CCR-SOP/OpenSourcePerfusionSystem/Documentation/README.txt

Files with extension .drawio can be read online directly through https://app.diagrams.net/?src=about
A free desktop app is available at https://github.com/jgraph/drawio-desktop/releases/
The "Windows No Installer" release can be run directly with no admin privileges needed.
