CCR-SOP/OpenSourcePerfusionSystem/Models/mcc_dac_amp-EDM/mcc_dac_amp_BottomDecalImage_5.png

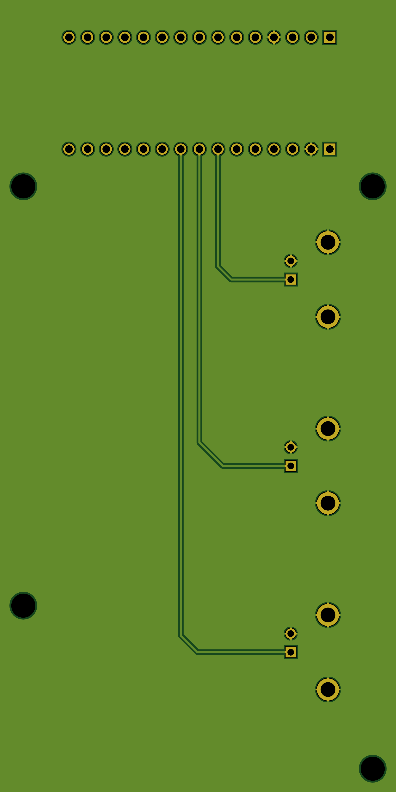
Models/mcc_dac_amp-EDM/mcc_dac_amp_BottomDecalImage_5.png
