CCR-SOP/OpenSourcePerfusionSystem/Models/mcc_dac_amp-EDM/mcc_dac_amp_TopDecalImage_5.png

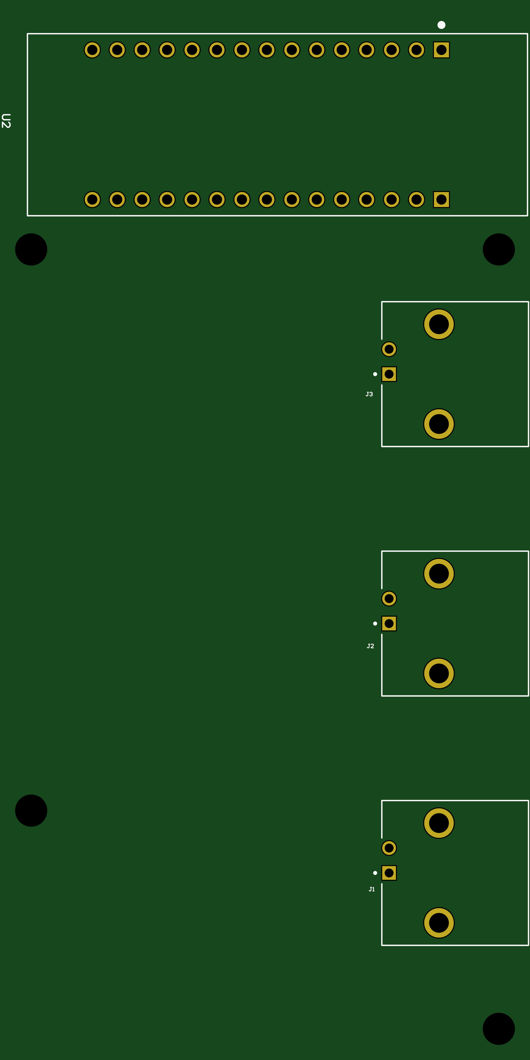
Models/mcc_dac_amp-EDM/mcc_dac_amp_TopDecalImage_5.png
