CCR-SOP/OpenSourcePerfusionSystem/Models/DialysisDACEnclosure.SLDASM

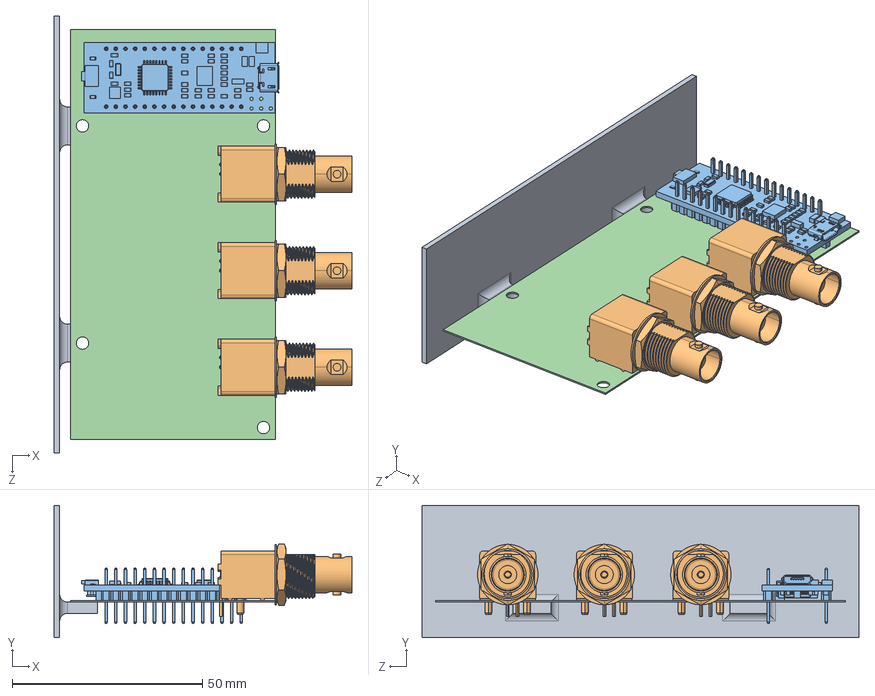
[picture p3: CAD file, 2024-11-08]
Models/DialysisDACEnclosure.SLDASM
78.4 x 34.8 x 115.0 mm
mcc_dac_amp_BOARD
MODULE_NUCLEO-F303K8_NUCLEO-F303K8-4
LINX_CONBNC002_CONBNC002-1 x 3
DialysisDACEnclosure_RearPanel
