CCR-SOP/OpenSourcePerfusionSystem/Models/PerfusionChamber/Liver_Perfusion_Chamber_Assembly.SLDASM

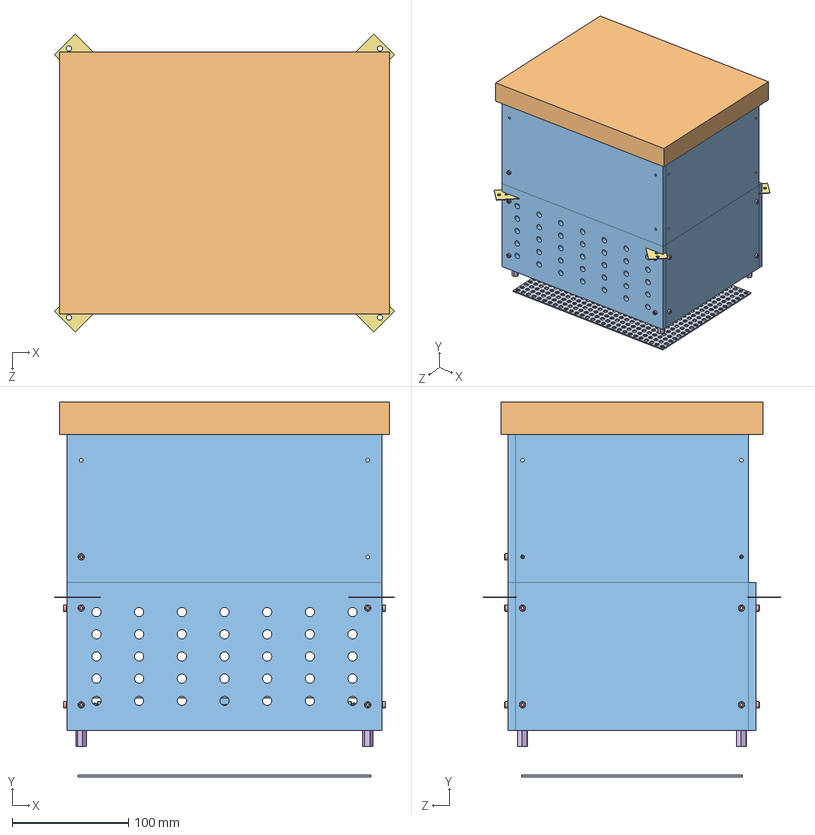
[picture p4: CAD file, 2022-06-02]
Models/PerfusionChamber/Liver_Perfusion_Chamber_Assembly.SLDASM
292.1 x 322.0 x 256.1 mm
Metal_Plate
CustomSpacerWall x 4
FabricationCube x 8
91292A346_18-8 Stainless Steel Socket Head Screw x 16
SH1000-G_Standoff x 4
91292A114_TYPE 18-8 SS SOCKET HEAD CAP SCREW x 4
Hammock_drainage_frame x 2
2633T11_HIGH-TEMPERATURE SILICONE RUBBER SHEET
magnet_based_drain
