CCR-SOP/OpenSourcePerfusionSystem/Models/mcc_dac_amp.SLDASM

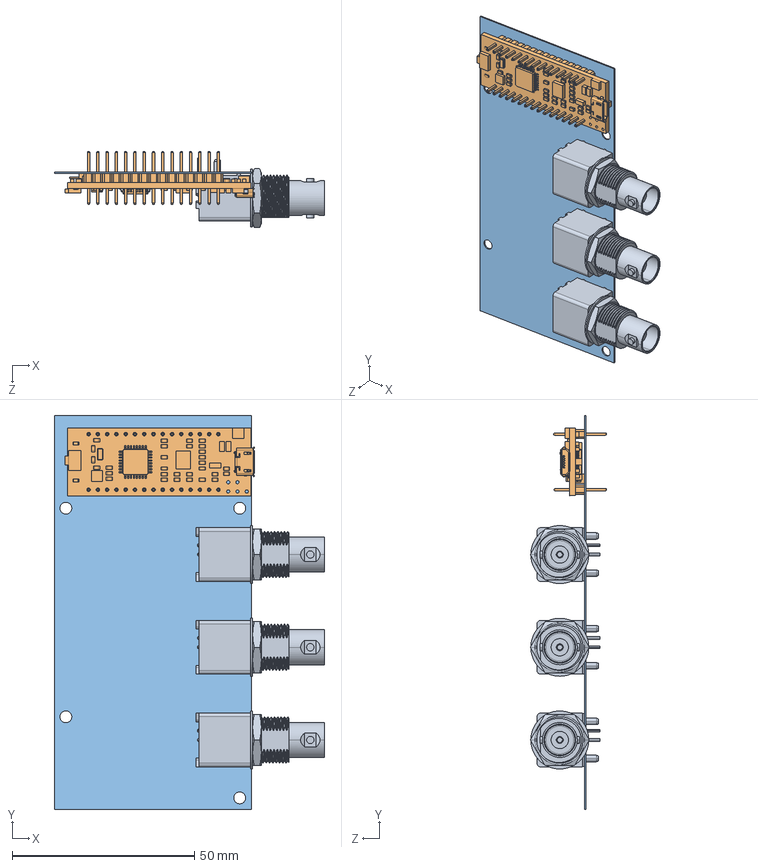
[picture p5: CAD file, 2024-07-02]
Models/mcc_dac_amp.SLDASM
74.1 x 108.0 x 20.9 mm
mcc_dac_amp_BOARD
MODULE_NUCLEO-F303K8_NUCLEO-F303K8-4
LINX_CONBNC002_CONBNC002-1 x 3
