CCR-SOP/OpenSourcePerfusionSystem/Models/SideComponents/Levitronics_pumpwithpumphead.SLDASM

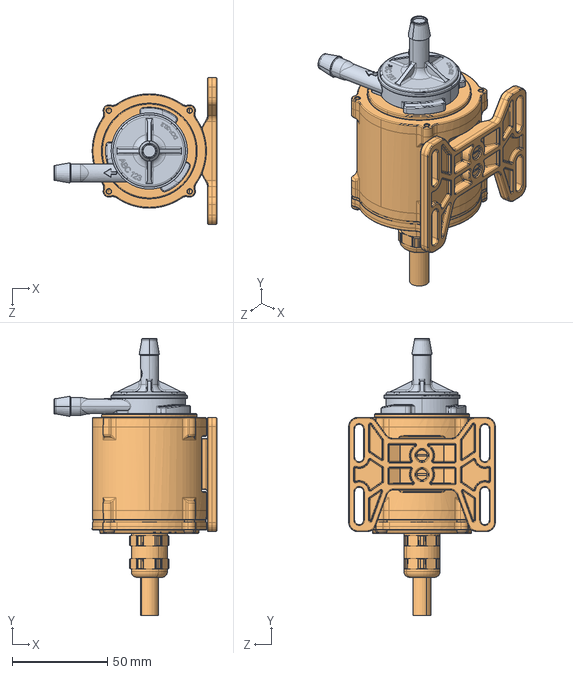
[picture p6: CAD file, 2024-11-08]
Models/SideComponents/Levitronics_pumpwithpumphead.SLDASM
85.5 x 145.4 x 77.0 mm
PS-4060-07 Rev01 Spec for Pump Driver IPD-30-8 Simplified Solid
PS-4078-00 Rev00 Pump Head DCP-30-2 Simplified Solid
