CCR-SOP/OpenSourcePerfusionSystem/Models/mcc_dac_amp-EDM/MODULE_NUCLEO-F303K8_NUCLEO-F303K8-3.SLDPRT

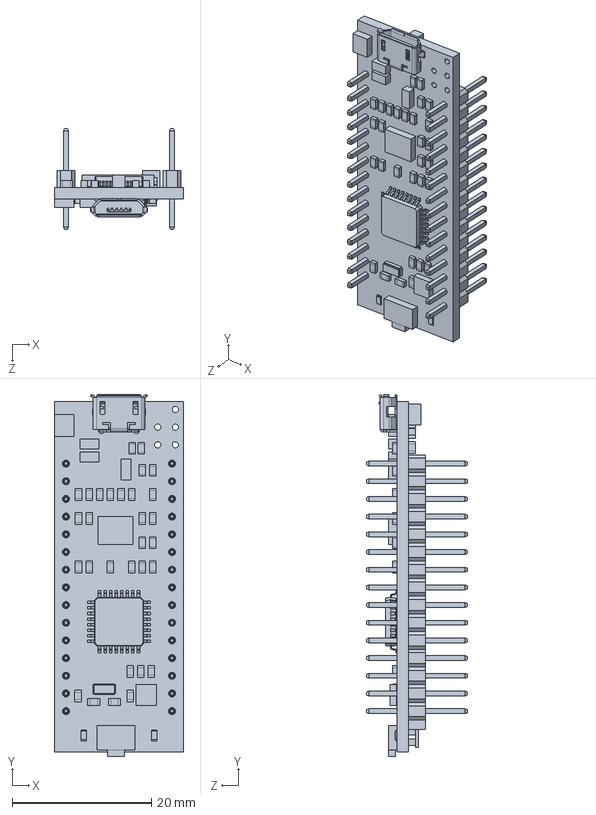
[picture p7: CAD file, 2024-07-02]
Models/mcc_dac_amp-EDM/MODULE_NUCLEO-F303K8_NUCLEO-F303K8-3.SLDPRT
18.5 x 52.0 x 14.5 mm
