CCR-SOP/OpenSourcePerfusionSystem/Models/SideComponents/pegboard_stand_top.SLDPRT

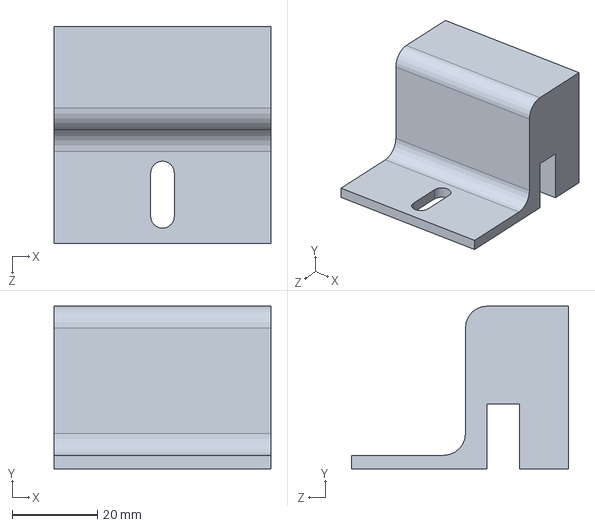
[picture p8: CAD file, 2024-11-08]
Models/SideComponents/pegboard_stand_top.SLDPRT
50.8 x 38.1 x 50.8 mm
