CCR-SOP/OpenSourcePerfusionSystem/Models/mcc_dac_amp-EDM/mcc_dac_amp_BOARD.SLDPRT

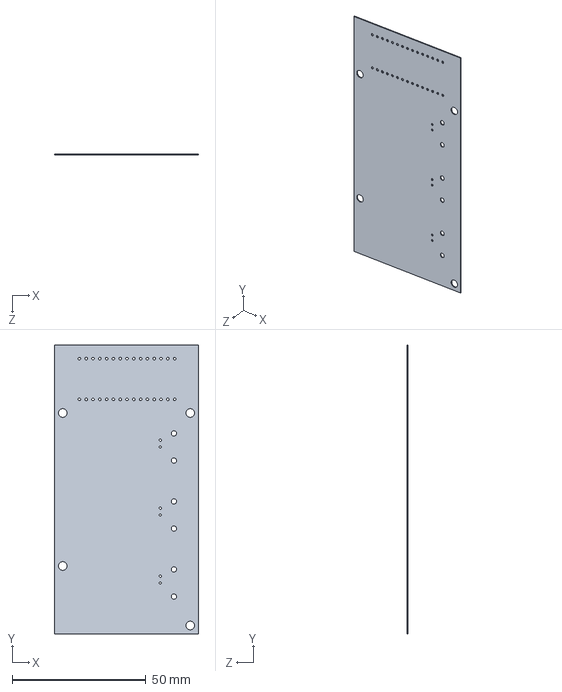
[picture p9: CAD file, 2024-07-02]
Models/mcc_dac_amp-EDM/mcc_dac_amp_BOARD.SLDPRT
54.0 x 108.0 x 0.411 mm
