CCR-SOP/OpenSourcePerfusionSystem/Models/SideComponents/HDfilter_holder.SLDPRT

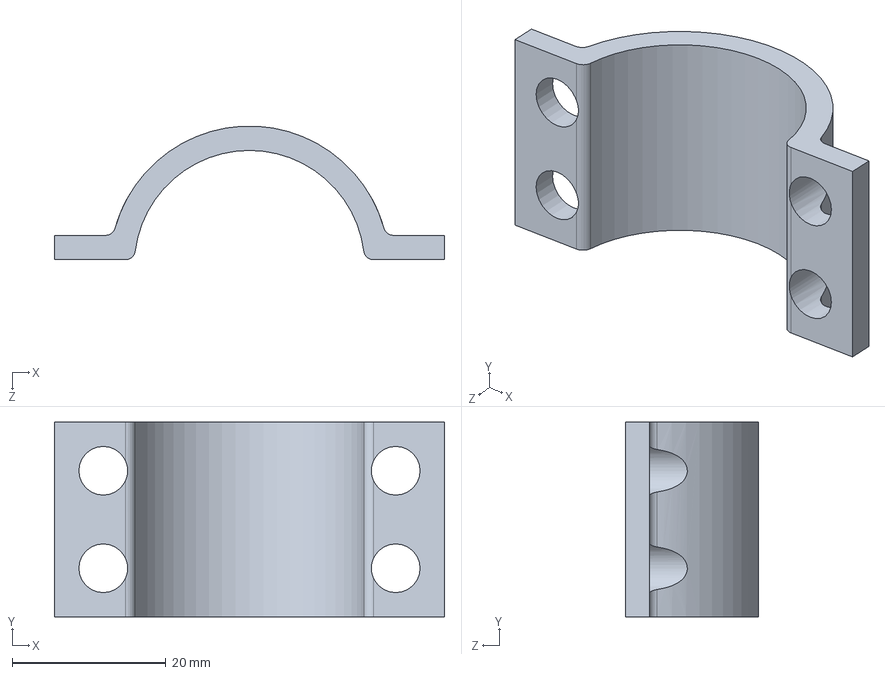
[picture p10: CAD file, 2024-11-08]
Models/SideComponents/HDfilter_holder.SLDPRT
50.8 x 25.4 x 17.4 mm
