CCR-SOP/OpenSourcePerfusionSystem/Models/DialysisDACEnclosure_RearPanel.SLDPRT

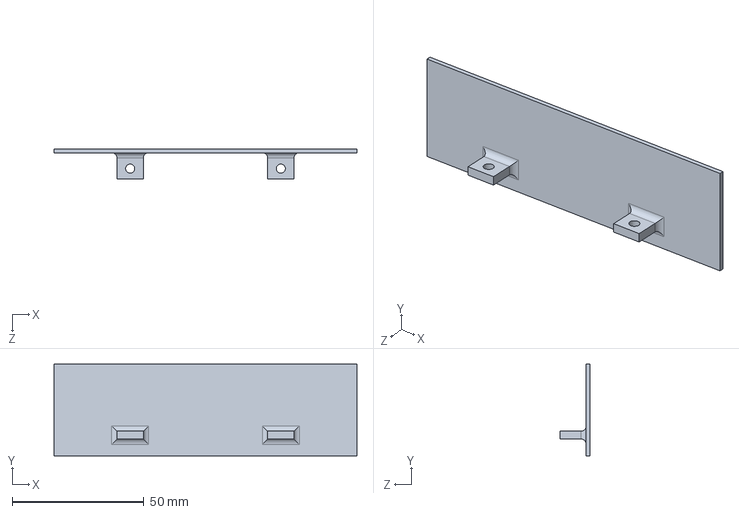
[picture p11: CAD file, 2024-07-02]
Models/DialysisDACEnclosure_RearPanel.SLDPRT
115.0 x 34.8 x 11.5 mm
