CCR-SOP/OpenSourcePerfusionSystem/Models/SideComponents/Clamponflow_holder.SLDPRT

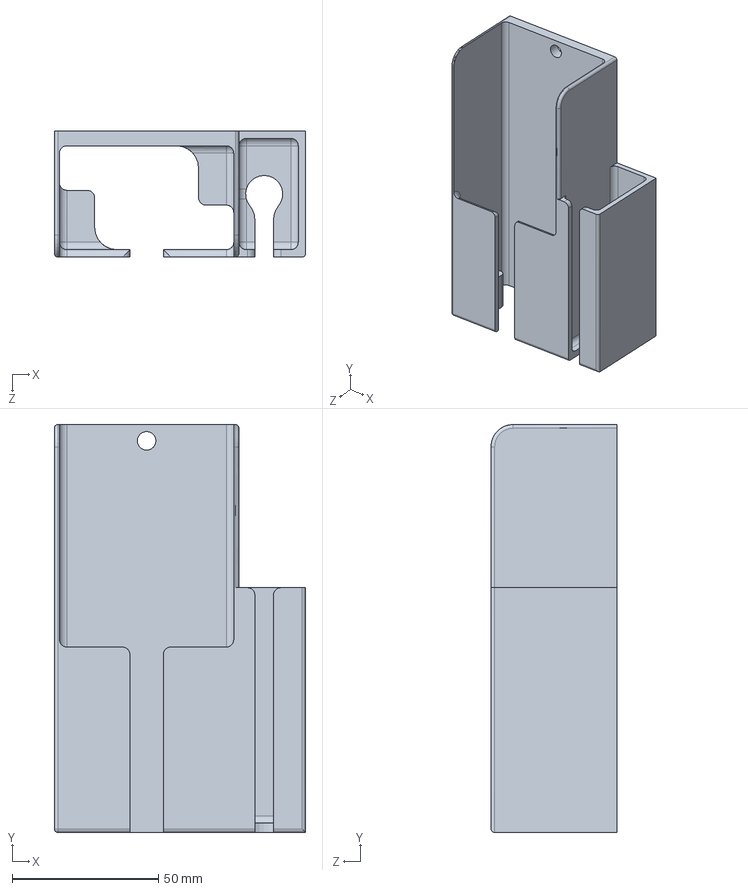
[picture p12: CAD file, 2024-11-08]
Models/SideComponents/Clamponflow_holder.SLDPRT
86.1 x 139.7 x 43.2 mm
