CCR-SOP/OpenSourcePerfusionSystem/Models/mcc_dac_amp-EDM/LINX_CONBNC002_CONBNC002-1.SLDPRT

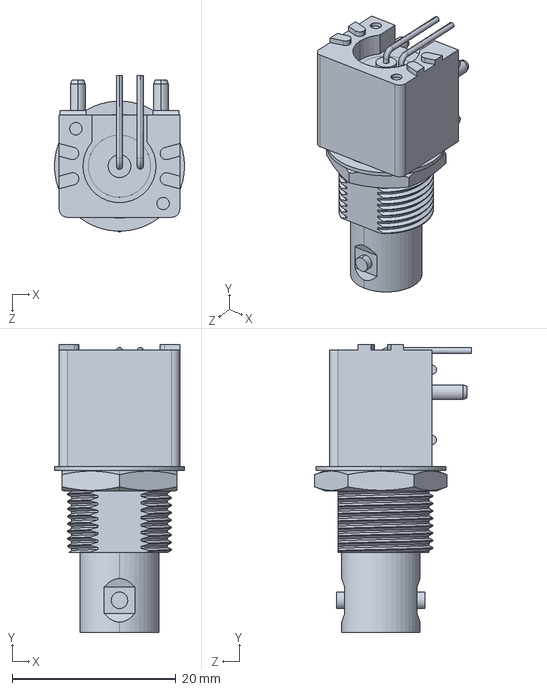
[picture p13: CAD file, 2024-07-02]
Models/mcc_dac_amp-EDM/LINX_CONBNC002_CONBNC002-1.SLDPRT
15.9 x 35.2 x 19.1 mm
