CCR-SOP/OpenSourcePerfusionSystem/Models/SideComponents/Clampon_frontbracket.SLDPRT

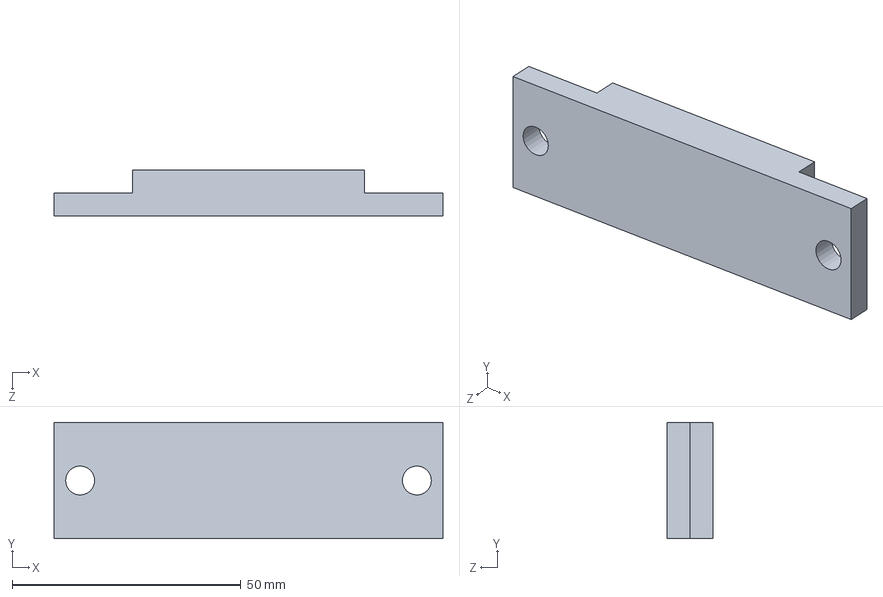
[picture p14: CAD file, 2024-11-08]
Models/SideComponents/Clampon_frontbracket.SLDPRT
85.1 x 25.4 x 10.2 mm
