CCR-SOP/OpenSourcePerfusionSystem/Models/SideComponents/PS-4060-07 Rev01 Spec for Pump Driver IPD-30-8 Simplified Solid.SLDPRT

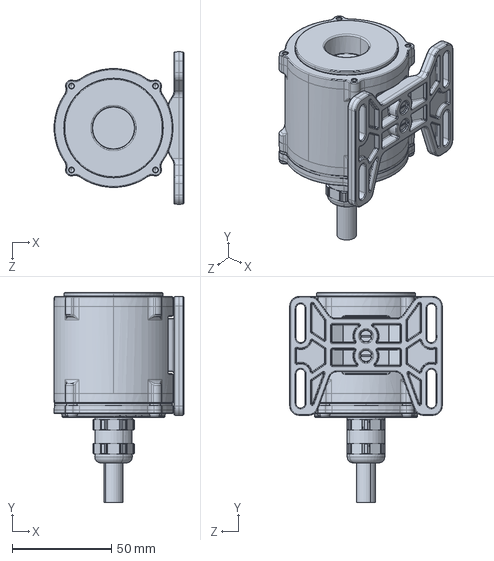
[picture p15: CAD file, 2024-11-08]
Models/SideComponents/PS-4060-07 Rev01 Spec for Pump Driver IPD-30-8 Simplified Solid.SLDPRT
65.5 x 106.0 x 77.0 mm
