CCR-SOP/OpenSourcePerfusionSystem/Models/SideComponents/HDfilter_holder_U.SLDPRT

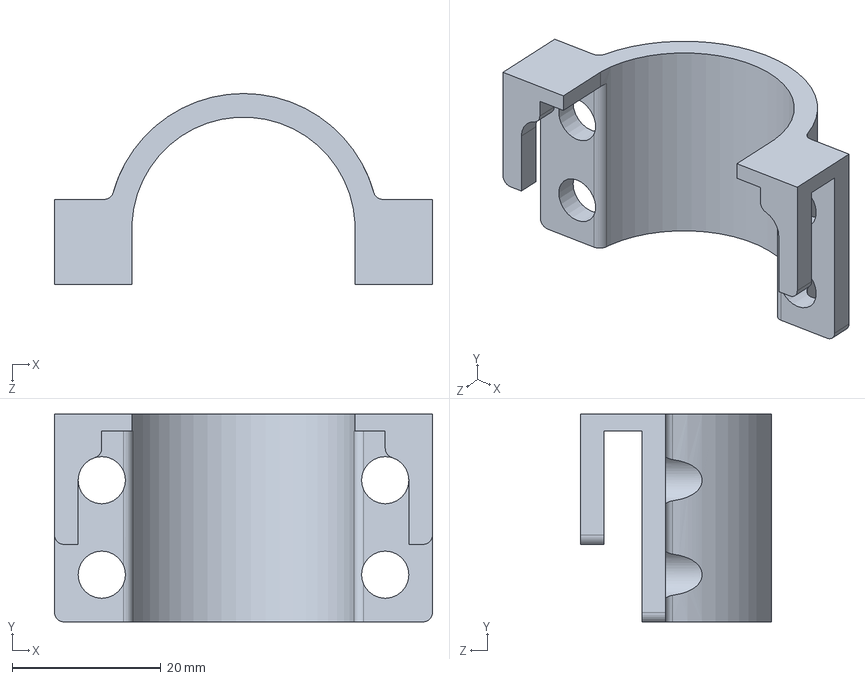
[picture p16: CAD file, 2024-11-08]
Models/SideComponents/HDfilter_holder_U.SLDPRT
50.8 x 27.9 x 25.7 mm
