CCR-SOP/OpenSourcePerfusionSystem/Models/SideComponents/Clampon_base.SLDPRT

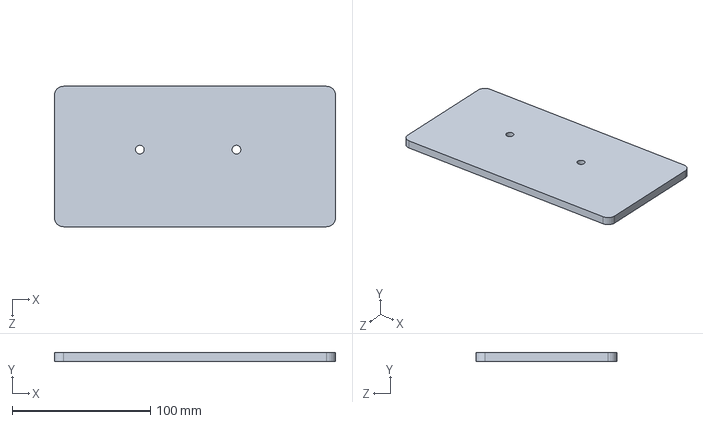
[picture p17: CAD file, 2024-11-08]
Models/SideComponents/Clampon_base.SLDPRT
203.2 x 6.35 x 101.6 mm
