CCR-SOP/OpenSourcePerfusionSystem/Models/SideComponents/Clampon_backbracket.SLDPRT

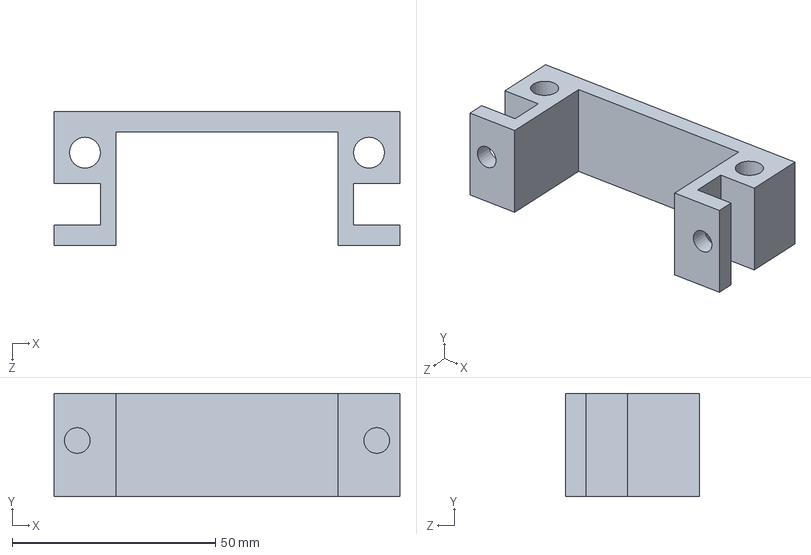
[picture p18: CAD file, 2024-11-08]
Models/SideComponents/Clampon_backbracket.SLDPRT
85.1 x 25.4 x 33.0 mm
