CCR-SOP/OpenSourcePerfusionSystem/Models/SideComponents/Pump_platform.SLDPRT

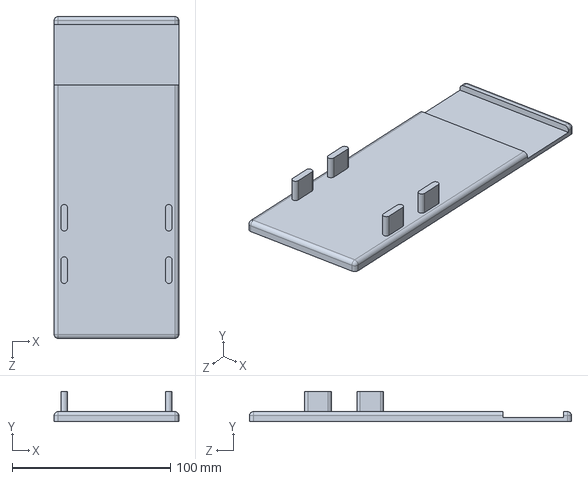
[picture p19: CAD file, 2024-11-08]
Models/SideComponents/Pump_platform.SLDPRT
78.7 x 19.1 x 203.2 mm
