CCR-SOP/OpenSourcePerfusionSystem/Models/SideComponents/Gasexchange_loop.SLDPRT

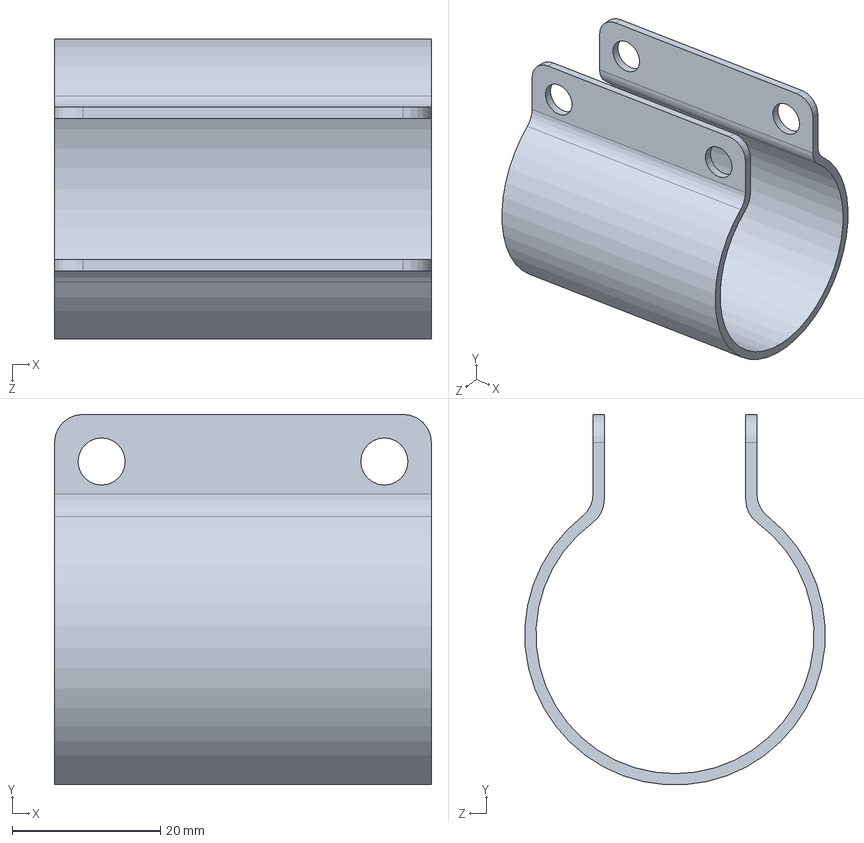
[picture p20: CAD file, 2024-11-08]
Models/SideComponents/Gasexchange_loop.SLDPRT
50.8 x 49.9 x 40.4 mm
