CCR-SOP/OpenSourcePerfusionSystem/Models/SideComponents/pegboard_stand.SLDPRT

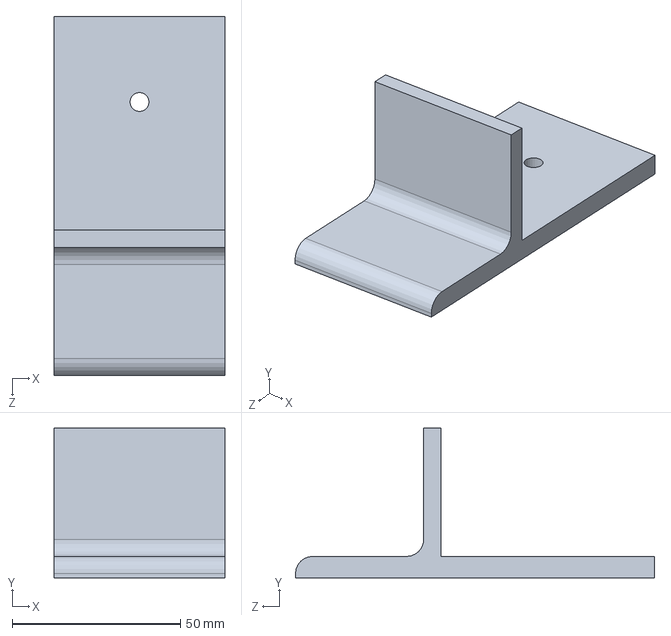
[picture p21: CAD file, 2024-11-08]
Models/SideComponents/pegboard_stand.SLDPRT
50.8 x 44.5 x 106.7 mm
