CCR-SOP/OpenSourcePerfusionSystem/Models/SideComponents/PS-4078-00 Rev00 Pump Head DCP-30-2 Simplified Solid.SLDPRT

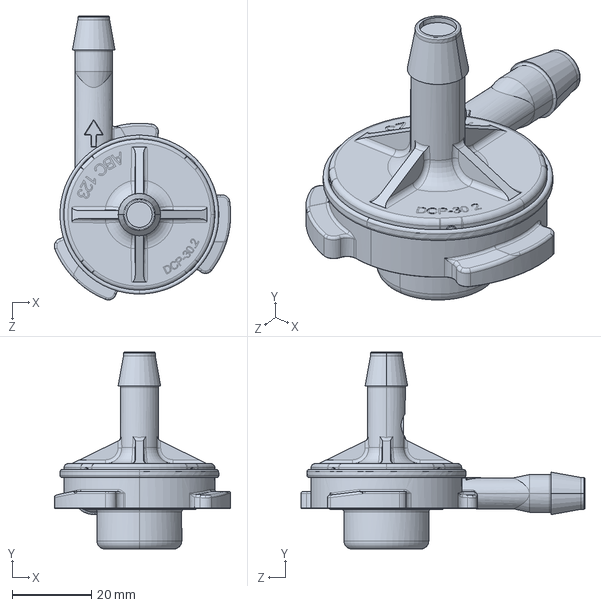
[picture p22: CAD file, 2024-11-08]
Models/SideComponents/PS-4078-00 Rev00 Pump Head DCP-30-2 Simplified Solid.SLDPRT
44.4 x 49.6 x 71.5 mm
