CCR-SOP/OpenSourcePerfusionSystem/Models/SideComponents/HDfilter_dialysis.SLDPRT

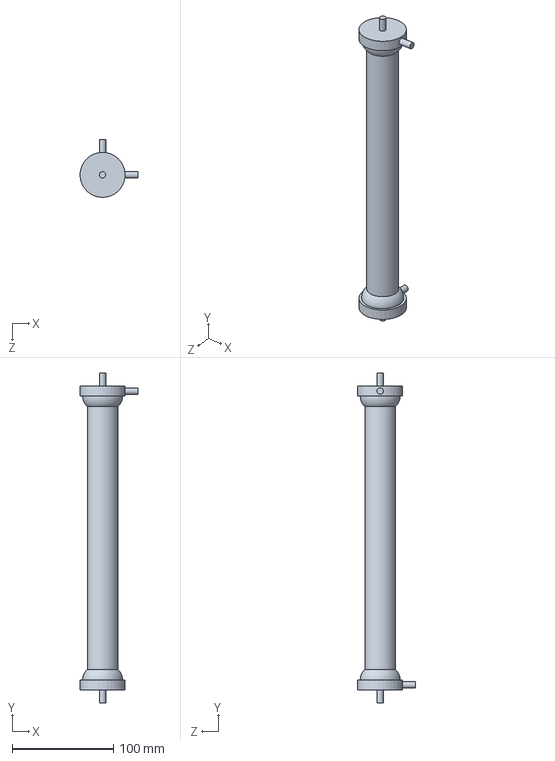
[picture p23: CAD file, 2024-11-08]
Models/SideComponents/HDfilter_dialysis.SLDPRT
56.9 x 325.4 x 57.0 mm
