CCR-SOP/OpenSourcePerfusionSystem/(list of files, cad)

Other CAD files:
Models/mcc_dac_amp-EDM/MODULE_NUCLEO-F303K8_NUCLEO-F303K8-4.SLDPRT
Circuits/mcc_dac_amp/mcc_dac_amp-EDM/LINX_CONBNC002_CONBNC002.x_t
Models/DialysisDACEnclosure.SLDPRT
Models/SideComponents/18535A102_Zinc-Plated Steel Pegboard Hook.SLDPRT
Models/SideComponents/18535A132_Pegboard Holder for 1-1 2 Diameter Item.SLDPRT
Models/mcc_dac_amp-EDM/Orig/LINX_CONBNC002_CONBNC002_1.x_t
