CCR-SOP/OpenSourcePerfusionSystem/(list of files, drawings)

Other design files:
Circuits/mcc_dac_amp/mcc_dac_amp.PcbDoc
Circuits/mcc_dac_amp/mcc_dac_amp.PrjPcb
Circuits/mcc_dac_amp/mcc_dac_amp.SchDoc
Circuits/mcc_dac_amp/SnapDocs/CONBNC002.PcbLib
Circuits/mcc_dac_amp/SnapDocs/CONBNC002.SchLib
Circuits/mcc_dac_amp/SnapDocs/SSQ-106-02-T-S-RA.PcbLib
Circuits/mcc_dac_amp/SnapDocs/SSQ-106-02-T-S-RA.SchLib
Circuits/PumpDriver/Driver.SchDoc
Circuits/PumpDriver/PumpDriver1/PumpDriver.SCHLIB
Circuits/PumpDriver/PumpDriver2/PumpDriver.SCHLIB
Circuits/PumpDriver/PumpDriver.PcbDoc
Circuits/PumpDriver/PumpDriver.PrjPcb
Circuits/PumpDriver/PumpDriver.SchDoc
