CCR-SOP/OpenSourcePerfusionSystem/Code/nucleo_dac/Core/Src/main.c

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
/* Includes ------------------------------------------------------------------*/
#include "main.h"
#include "cmsis_os.h"

/* USER CODE BEGIN Includes */
#include <string.h>
#include <stdio.h>
#include <stdarg.h>
#include <stdlib.h>
/* USER CODE END Includes */

/* USER CODE BEGIN PD */
#define UART_STR_LEN 80


#define CMD_MAX_LEN 16
#define PARAM_MAX_LEN 8
#define TOTAL_CMD_PARAMS 3
#define TOTAL_DACS 3
#define MAX_RCV_LEN (CMD_MAX_LEN + 1 + (PARAM_MAX_LEN * TOTAL_CMD_PARAMS))
#define FLAG_CMD_BUF0_READY 0x1
#define FLAG_CMD_BUF1_READY 0x2
#define FLAG_DAC0_UPDATE 0x1
#define FLAG_DAC1_UPDATE 0x2
#define FLAG_DAC2_UPDATE 0x3
/* USER CODE END PD */

DAC_HandleTypeDef hdac1;
DAC_HandleTypeDef hdac2;

UART_HandleTypeDef huart2;

/* Definitions for defaultTask */
osThreadId_t defaultTaskHandle;
const osThreadAttr_t defaultTask_attributes = {
  .name = "defaultTask",
  .stack_size = 128 * 4,
  .priority = (osPriority_t) osPriorityNormal,
};
/* Definitions for taskCMD */
osThreadId_t taskCMDHandle;
const osThreadAttr_t taskCMD_attributes = {
  .name = "taskCMD",
  .stack_size = 128 * 4,
  .priority = (osPriority_t) osPriorityLow,
};
/* Definitions for eventCMD */
osEventFlagsId_t eventCMDHandle;
const osEventFlagsAttr_t eventCMD_attributes = {
  .name = "eventCMD"
};
/* Definitions for eventUpdateDAC */
osEventFlagsId_t eventUpdateDACHandle;
const osEventFlagsAttr_t eventUpdateDAC_attributes = {
  .name = "eventUpdateDAC"
};
/* USER CODE BEGIN PV */
uint16_t dac_value[TOTAL_DACS];

char uart_msg[UART_STR_LEN];
extern struct RunTableInfo RunTable;

// serial command processing
uint8_t rcv_byte;
uint8_t rcv_buf[2][MAX_RCV_LEN];
uint8_t rcv_idx = 0;
uint8_t rcv_buf_idx = 0;
uint8_t rcv_cmd_len = 0;

char cmd_buf[MAX_RCV_LEN];
char cmd[CMD_MAX_LEN];
char cmd_params[TOTAL_CMD_PARAMS][PARAM_MAX_LEN];
char cmd_delim[2] = " ";


/* USER CODE END PV */

void SystemClock_Config(void);
static void MX_GPIO_Init(void);
static void MX_USART2_UART_Init(void);
static void MX_DAC1_Init(void);
static void MX_DAC2_Init(void);
void StartDefaultTask(void *argument);
void StartTaskCMD(void *argument);

/* USER CODE BEGIN PFP */
void debug_print_uart(char *fmt, ...);
/* USER CODE END PFP */

/**
  * @brief  The application entry point.
  * @retval int
  */
int main(void)
{
  /* MCU Configuration--------------------------------------------------------*/

  /* Reset of all peripherals, Initializes the Flash interface and the Systick. */
  HAL_Init();

  /* Configure the system clock */
  SystemClock_Config();

  /* Initialize all configured peripherals */
  MX_GPIO_Init();
  MX_USART2_UART_Init();
  MX_DAC1_Init();
  MX_DAC2_Init();
  /* USER CODE BEGIN 2 */
  HAL_DAC_Start(&hdac1, DAC_CHANNEL_1);
  HAL_DAC_Start(&hdac1, DAC_CHANNEL_2);
  HAL_DAC_Start(&hdac2, DAC_CHANNEL_1);
  /* USER CODE END 2 */

  /* Init scheduler */
  osKernelInitialize();

  /* USER CODE BEGIN RTOS_MUTEX */
  /* add mutexes, ... */
  /* USER CODE END RTOS_MUTEX */

  /* USER CODE BEGIN RTOS_SEMAPHORES */
  /* add semaphores, ... */
  /* USER CODE END RTOS_SEMAPHORES */

  /* USER CODE BEGIN RTOS_TIMERS */
  /* start timers, add new ones, ... */
  /* USER CODE END RTOS_TIMERS */

  /* USER CODE BEGIN RTOS_QUEUES */
  /* add queues, ... */
  /* USER CODE END RTOS_QUEUES */

  /* Create the thread(s) */
  /* creation of defaultTask */
  defaultTaskHandle = osThreadNew(StartDefaultTask, NULL, &defaultTask_attributes);

  /* creation of taskCMD */
  taskCMDHandle = osThreadNew(StartTaskCMD, NULL, &taskCMD_attributes);

  /* USER CODE BEGIN RTOS_THREADS */
  /* add threads, ... */
  /* USER CODE END RTOS_THREADS */

  /* Create the event(s) */
  /* creation of eventCMD */
  eventCMDHandle = osEventFlagsNew(&eventCMD_attributes);

  /* creation of eventUpdateDAC */
  eventUpdateDACHandle = osEventFlagsNew(&eventUpdateDAC_attributes);

  /* USER CODE BEGIN RTOS_EVENTS */
  /* add events, ... */
  /* USER CODE END RTOS_EVENTS */

  /* Start scheduler */
  osKernelStart();

  /* We should never get here as control is now taken by the scheduler */
  /* Infinite loop */
  /* USER CODE BEGIN WHILE */
  while (1)
  {
    /* USER CODE END WHILE */

    /* USER CODE BEGIN 3 */
  }
  /* USER CODE END 3 */
}

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
/* USER CODE BEGIN 4 */

void debug_print_uart(char *fmt, ...)
{
	va_list va;
	va_start(va, fmt);
	vsnprintf(uart_msg, UART_STR_LEN, fmt, va);
	HAL_UART_Transmit(&huart2, (const uint8_t*)uart_msg, strlen(uart_msg), 500);
	va_end(va);

}

void HAL_UART_RxCpltCallback(UART_HandleTypeDef *huart)
{
   if (huart->Instance == USART2) { // Current UART
	   rcv_buf[rcv_buf_idx][rcv_idx] = rcv_byte;    // Add data to Rx_Buffer
	   if ((rcv_byte == '\n' || rcv_byte == '\r')) {
		   // if a \r or \n already handled, ignore the next one until new characters received
		   if (rcv_idx > 0) {
			   rcv_cmd_len = rcv_idx;
			   osEventFlagsSet(eventCMDHandle, rcv_buf_idx + 1);
			   rcv_buf_idx = (int)(!rcv_buf_idx);
			   rcv_idx = 0;
		   }
	   } else {
		   rcv_idx++;
		   if (rcv_idx >= MAX_RCV_LEN) {
			   rcv_idx = MAX_RCV_LEN;
			   //TODO, should report error
		   }
	   }
   }

   HAL_UART_Receive_IT(&huart2, &rcv_byte, 1);
}

void parse_cmd_buf(void)
{
	char *ptr = strtok(cmd_buf, cmd_delim);
	strncpy(cmd, ptr, sizeof(cmd));
	int param_idx = 0;
	while (ptr != NULL) {
		ptr = strtok(NULL, cmd_delim);
		strncpy(cmd_params[param_idx], ptr, sizeof(cmd_params[param_idx]));
		param_idx++;
	}

}

void clear_cmd_buf(void)
{
	memset(cmd, 0, CMD_MAX_LEN);
	for (int i=0;i<TOTAL_CMD_PARAMS;i++) {
		memset(cmd_params[i], 0, PARAM_MAX_LEN);
	}
}
/* USER CODE END 4 */

/* USER CODE BEGIN Header_StartDefaultTask */
/**
  * @brief  Function implementing the defaultTask thread.
  * @param  argument: Not used
  * @retval None
  */
/* USER CODE END Header_StartDefaultTask */
void StartDefaultTask(void *argument)
{
  /* USER CODE BEGIN 5 */
  /* Infinite loop */
	uint32_t requested_flags = FLAG_DAC0_UPDATE | FLAG_DAC1_UPDATE | FLAG_DAC2_UPDATE;
	uint32_t flags;

	for(;;) {
		flags = osEventFlagsWait(eventUpdateDACHandle, requested_flags, osFlagsWaitAny, osWaitForever);
		if (flags < 0x80000000) {
			if (flags & FLAG_DAC0_UPDATE) {
				HAL_DAC_SetValue(&hdac1, DAC_CHANNEL_1, DAC_ALIGN_12B_R, dac_value[0]);
			}
			if (flags & FLAG_DAC1_UPDATE) {
				HAL_DAC_SetValue(&hdac1, DAC_CHANNEL_2, DAC_ALIGN_12B_R, dac_value[1]);
			}
			if (flags & FLAG_DAC2_UPDATE) {
				HAL_DAC_SetValue(&hdac2, DAC_CHANNEL_1, DAC_ALIGN_12B_R, dac_value[2]);
			}
		}
	}
  /* USER CODE END 5 */
}

/* USER CODE BEGIN Header_StartTaskCMD */
/**
* @brief Function implementing the taskCMD thread.
* @param argument: Not used
* @retval None
*/
/* USER CODE END Header_StartTaskCMD */
void StartTaskCMD(void *argument)
{
  /* USER CODE BEGIN StartTaskCMD */
  /* Infinite loop */
  for(;;) {
	  HAL_UART_Receive_IT(&huart2, &rcv_byte, 1);

		uint32_t flags;
		for(;;) {
			flags = osEventFlagsWait(eventCMDHandle, FLAG_CMD_BUF0_READY | FLAG_CMD_BUF1_READY, osFlagsWaitAny, 100);
			if (flags < 0x80000000) {
				memcpy((char*)cmd_buf, (const char*)rcv_buf[flags-1], rcv_cmd_len);
				cmd_buf[rcv_cmd_len] = '\0';
				clear_cmd_buf();
				parse_cmd_buf();
				if (strncmp(cmd, "dac", 3) == 0) {
					int dac_idx = atoi(cmd_params[0]);
					if (0 <= dac_idx && dac_idx < TOTAL_DACS) {
						float percent = atof(cmd_params[1]);
						if (percent < 0.0 || percent > 100.0) {
							debug_print_uart("Illegal dac value %d\r\n", dac_value[dac_idx]);
						} else {
							debug_print_uart("Setting DAC %d to %d\r\n", dac_idx, dac_value[dac_idx]);
							dac_value[dac_idx] = (int)(percent/100.0 * 4095);
							osEventFlagsSet(eventUpdateDACHandle, dac_idx+1);
						}
					} else{
						debug_print_uart("Illegal DAC %d\r\n", dac_idx);
					}
				} else {
					debug_print_uart("Unknown cmd |%s|\r\n", cmd);
				}
			}
		}
	}
  /* USER CODE END StartTaskCMD */
}

/**
  * @brief  This function is executed in case of error occurrence.
  * @retval None
  */
void Error_Handler(void)
{
  /* USER CODE BEGIN Error_Handler_Debug */
  /* User can add his own implementation to report the HAL error return state */
  __disable_irq();
  while (1)
  {
  }
  /* USER CODE END Error_Handler_Debug */
}

#ifdef  USE_FULL_ASSERT
/**
  * @brief  Reports the name of the source file and the source line number
  *         where the assert_param error has occurred.
  * @param  file: pointer to the source file name
  * @param  line: assert_param error line source number
  * @retval None
  */
void assert_failed(uint8_t *file, uint32_t line)
{
  /* USER CODE BEGIN 6 */
  /* User can add his own implementation to report the file name and line number,
     ex: printf("Wrong parameters value: file %s on line %d\r\n", file, line) */
  /* USER CODE END 6 */
}
#endif /* USE_FULL_ASSERT */
