CCR-SOP/OpenSourcePerfusionSystem/Code/PerfusionControl/config/automations.ini

[Arterial Gas Mixer Automation]
class = AutoGasMixerArterial
gas_device = Arterial Gas Mixer
data_source = CDI
adjust_rate_ms = 60000
pH_min = 7.35
pH_max = 7.45
CO2_min = 10
CO2_max = 30
PO2_min = 100
PO2_max = 130
O2_min = 95
O2_max = 100
CO2_adjust = 1.0
flow_adjust = 5.0
O2_channel = 1
CO2_channel = 2

[Venous Gas Mixer Automation]
class = AutoGasMixerVenous
gas_device = Venous Gas Mixer
adjust_rate_ms = 300000
data_source = CDI
O2_min = 82
O2_max = 88
pH_min = 7.35
pH_max = 7.45
flow_adjust = 5.0
O2_adjust = 1.0
O2_channel = 1
CO2_channel = 2

[Dialysate Inflow Automation]
class = AutoDialysisInflow
pump = Dialysate Inflow Pump
data_source = CDI
adjust_rate = 0.5
adjust_rate_ms = 300000
flow_range = [0, 100]
K_min = 2.0
K_max = 6.0

[Dialysate Outflow Automation]
class = AutoDialysisOutflow
pump = Dialysate Outflow Pump
data_source = CDI
adjust_rate = 0.5
adjust_rate_ms = 300000
hct_min = 35
hct_max = 45
K_min = 2
K_max = 6

[Dialysis Blood Automation]
class = AutoDialysis
pump = Dialysis Blood Pump
data_source = CDI
adjust_rate_ms = 300000
adjust_rate = 0

[Glucose Circuit Automation]
class = AutoDialysis
pump = Dialysis Blood Pump
data_source = CDI
adjust_rate_ms = 1000
adjust_percent = 0

[Vasoactive Automation]
class = AutoSyringeVaso
data_source = Hepatic Artery Pressure
constrictor = Phenylephrine
dilator = Epoprostenol
constrictor_volume_ul = 0
constrictor_ul_per_min = 0
dilator_volume_ul = 0
dilator_ul_per_min = 0
basal = True
update_rate_minute = 5
pressure_mmHg_min = 30.0
pressure_mmHg_max = 60.0

[Glucose Automation]
class = AutoSyringeGlucose
data_source = Hepatic Artery Pressure
increase = Glucagon
decrease = Insulin
decrease_volume_ul = 0
decrease_ul_per_min = 0
increase_volume_ul = 0
increase_ul_per_min = 0
basal = True
update_rate_minute = 5
glucose_min = 30.0
glucose_max = 50.0

[Phenylephrine Automation]
class = AutoSyringePhenyl
device = Phenylephrine
data_source = Hepatic Artery Pressure
adjust_rate_ms = 1000
volume_ul = 0
ul_per_min = 0
basal = True
pressure_mmHg_min = 30
pressure_mmHg_max = 60

[Epoprostenol Automation]
class = AutoSyringeEpo
device = Epoprostenol
data_source = Hepatic Artery Pressure
adjust_rate_ms = 1000
volume_ul = 0
ul_per_min = 10
basal = True
pressure_mmHg_min = 30
pressure_mmHg_max = 60

[Glucagon Automation]
class = AutoSyringeGlucagon
device = Glucagon
data_source = Hepatic Artery Pressure
adjust_rate_ms = 60000
volume_ul = 5
ul_per_min = 5
basal = False
glucose_min = 80
glucose_max = 180

[Insulin Automation]
class = AutoSyringeInsulin
device = Insulin
data_source = Hepatic Artery Pressure
adjust_rate_ms = 600000
volume_ul = 1
ul_per_min = 4
basal = True
glucose_min = 80
glucose_max = 180
max_ul_per_min = 11

[TPN + Bile Salts Manual]
class = AutoSyringe
device = TPN + Bile Salts
data_source = Hepatic Artery Pressure
adjust_rate_ms = 0
volume_ul = 0
ul_per_min = 83
basal = True

[Zosyn Manual]
class = AutoSyringe
device = Zosyn
data_source = Hepatic Artery Pressure
adjust_rate_ms = 0
volume_ul = 0
ul_per_min = 41
basal = True

[Solumed Manual]
class = AutoSyringe
device = Solumed
data_source = Hepatic Artery Pressure
adjust_rate_ms = 0
volume_ul = 0
ul_per_min = 33
basal = True

[TestAutoFlowDC]
class = StaticAutoFlow
device = Test Puralev DC
data_source = Hepatic Artery Flow
adjust_rate_ms = 1000
kp = 1.0
ki = 0.0
kd = 0.0
setpoint = 3.4
limit_high = 200.0
limit_low = 100.0

[TestAutoFlowSine]
class = SinusoidalAutoFlow
device = Test Puralev Sine
data_source = Hepatic Artery Flow
adjust_rate_ms = 1000
kp = 1.0
ki = 0.0
kd = 0.0
setpoint = 2.0
limit_high = 200.0
limit_low = 100.0
desired_min_flow = 40.0
desired_max_flow = 60.0
