CCR-SOP/OpenSourcePerfusionSystem/Code/PerfusionControl/config/hardware.ini

[MCC_Brd0]
class = MCCAIDevice
device_name = 0
device_number = 0
sampling_period_ms = 100
read_period_ms = 500
data_type = float64

[NI_Dev2]
class = NIDAQAIDevice
device_name = Dev2
sampling_period_ms = 100
read_period_ms = 500
data_type = float64
pk2pk_volts = 5
offset_volts = 2.5

[Pump1]
class = NIDAQDCDevice
device = Dev2
line = 1
flow_range = 0, 50
cal_pt1_volts = 0.1
cal_pt1_flow = 0.868
cal_pt2_volts = 5
cal_pt2_flow = 49.23

[Pump2]
class = NIDAQDCDevice
device = Dev2
line = 0
flow_range = 0, 50
cal_pt1_volts = 0.00
cal_pt1_flow = 0.0
cal_pt2_volts = 5
cal_pt2_flow = 1860

[Pump3]
class = NIDAQDCDevice
device = Dev1
line = 1
flow_range = 0, 50
cal_pt1_volts = 0.1
cal_pt1_flow = 0.806
cal_pt2_volts = 5
cal_pt2_flow = 49.23

[Pump4]
class = NIDAQDCDevice
device = Dev1
line = 0
flow_range = 0, 50
cal_pt1_volts = 0.1
cal_pt1_flow = 0.868
cal_pt2_volts = 5
cal_pt2_flow = 49.35

[CDI]
class = CDI
port = COM13
sampling_period_ms = 2000

[Gas Mixer 1]
class = GasDevice
port = COM25
flow_limits = 0, 250

[Gas Mixer 2]
class = GasDevice
port = COM19
flow_limits = 0, 250

[Syringe1_BDP_60ml]
class = Pump11Elite
com_port = COM9
baud = 9600
manufacturer_code = (bdp) Becton Dickinson, Plasti-pak
size = 60 ml
address = 0

[Syringe2_BDP_10ml]
class = Pump11Elite
com_port = COM11
baud = 9600
manufacturer_code = (bdp) Becton Dickinson, Plasti-pak
size = 10 ml
address = 0

[Syringe3_BDP_60ml]
class = Pump11Elite
com_port = COM7
baud = 9600
manufacturer_code = (bdp) Becton Dickinson, Plasti-pak
size = 60 ml
address = 0

[Syringe4_BDP_60ml]
class = Pump11Elite
com_port = COM8
manufacturer_code = (bdp) Becton Dickinson, Plasti-pak
size = 60 ml
baud = 9600
address = 0

[Syringe5_BDP_60ml]
class = Pump11Elite
com_port = COM12
baud = 9600
manufacturer_code = (bdp) Becton Dickinson, Plasti-pak
size = 60 ml
address = 0

[Syringe6_BDP_60ml]
class = Pump11Elite
com_port = COM10
baud = 9600
manufacturer_code = (bdp) Becton Dickinson, Plasti-pak
size = 60 ml
address = 0

[Puralev1]
class = PuraLevi30
port = COM4
baud = 57600
serial_num = nnnnnn-nnnn
device_addr = 0
update_rate_ms = 1
waveform = sine, 4000.0, 6000.0, 60

[Puralev2]
class = PuraLevi30
port = COM15
baud = 57600
serial_num = nnnnnn-nnnn
device_addr = 0
update_rate_ms = 1
waveform = sine, 4500, 4500, 0

[Leviflow1]
class = LeviFlow
port = COM14
baud = 57600
device_addr = 3
sampling_period_ms = 1000

[CITSens1]
class = CITSens
port = COM27
sampling_period_ms = 5000
