CCR-SOP/OpenSourcePerfusionSystem/Code/PerfusionControl/pyHardware/pyPuraLevi30.py

""" Class for controlling PuraLev i30 Pump

Uses minimalmodbus
Based on Firmware H2.48 R03 document provided by Levitronix

@project: LiverPerfusion NIH
@author: John Kakareka, NIH

This work was created by an employee of the US Federal Gov
and under the public domain.
"""

from dataclasses import dataclass
from enum import IntEnum
from queue import Queue, Empty
from threading import Lock, Thread, Event

import minimalmodbus as modbus
import serial
import numpy as np

import pyHardware.pyGeneric as pyGeneric
import pyPerfusion.utils as utils
import pyPerfusion.PerfusionConfig as PerfusionConfig
import pyHardware.pyWaveformGen as pyWaveformGen


class i30Exception(pyGeneric.HardwareException):
    """Exception used to pass simple device configuration error messages, mostly for display in GUI"""


class PumpState(IntEnum):
    Off = 1
    SpeedControl = 2
    ProcessControl = 3
    SpeedSafetyControl = 7
    ProcessSafetyControl = 8
    Error = 4


class RegisterMode(IntEnum):
    WriteSingle = 0x06
    WriteMultiple = 0x10


@dataclass
class Register:
    addr: int = 0x0
    word_len: int = 1
    scaling: float = 1.0


class ModbusFunction(IntEnum):
    HoldRegister = 6
    InputRegister = 4

# Taken from page 31 Section 2.3.2.4.1 of Firmware H2.48 docs
ReadRegisters = {
             'ID': Register(addr=0x3FE0, word_len=5),
             'DeviceType': Register(addr=0x3FE5),
             'FW': Register(addr=0x3FE6, word_len=8),
             'SN': Register(addr=0x3FEE),
             'State': Register(addr=0x4000),
             'ActualSpeed': Register(addr=0x4001),
             'ActualProcess': Register(addr=4002, scaling=0.01),
             'SetpointSpeed': Register(addr=0x4003),
             'SetpointProcess': Register(addr=0x4004, scaling=0.01),
             'Error': Register(addr=0x4005),
             'Warning': Register(addr=0x4006),
             'Message': Register(addr=4007),
             'DriverTemp': Register(addr=0x4008),
             'ImpellerZ': Register(addr=0x4009),
             'LastError': Register(addr=0x400A),
             'LastWarning': Register(addr=0x4006),
             'LastMessage': Register(addr=4007),
             'BearingPhaseV': Register(addr=0x400D, scaling=7.123/32767),
             'BearingPhaseW': Register(addr=0x400E, scaling=7.123/32767),
             'DrivePhaseV': Register(addr=0x400F, scaling=15/32767),
             'DrivePhaseW': Register(addr=0x4010, scaling=15/32767),
             'SupplyVoltage': Register(addr=0x40011, scaling=0.1),
             'PLCAnalogInput1': Register(addr=0x4012, scaling=0.002),
             'PLCAnalogInputCal1': Register(addr=0x4012, scaling=0.002),
             'PLCAnalogInputPercent1': Register(addr=0x4014, scaling=0.0125),
             'PLCAnalogInput2': Register(addr=0x4015, scaling=0.001),
             'PLCAnalogInputCal2': Register(addr=0x4016, scaling=0.001),
             'PLCAnalogInputPercent2': Register(addr=0x4017, scaling=0.01),
             'PLCProcessValue': Register(addr=0x4018, scaling=0.01),
             'PLCSetpointSpeed': Register(addr=0x4019),
             'PLCSetpointProcess': Register(addr=0x401A, scaling=0.01),
             'PLCAnalogOutput': Register(addr=0x401B, scaling=0.01),
             'PLCDigitalInput1': Register(addr=0x401C),
             'PLCDigitalInput2': Register(addr=0x401D),
             'PLCDigitalOutput1': Register(addr=0x401E),
             'PLCDigitalOutput2': Register(addr=0x401F),
             'BufferedError': Register(addr=0x4020),
             'BufferedWarning': Register(addr=0x4021),
             'BufferedMessage': Register(addr=0x4022)
             }


WriteRegisters = {
             'State': Register(addr=0x4000),
             'SetpointSpeed': Register(addr=0x4001),
             'SetpointProcess': Register(addr=0x4002, scaling=0.01),
             'Baud': Register(addr=0x4005),
             'DeviceAddress': Register(addr=0x4006),
             'InterframeTimeout': Register(addr=4007, scaling=0.2284148),
             'ActivateSettings': Register(addr=0x4008),
             'AnalogInputAssignment': Register(addr=0x4009),
             'AnalogOutputAssignment': Register(addr=0x400A),
             'DigitalOutput1Logic': Register(addr=0x400B),
             'DigitalOutput1Config': Register(addr=0x400C),
             'DigitalOutput2Logic': Register(addr=0x400D),
             'DigitalOutput2Config': Register(addr=0x400E),
             'CustomDigitalOutputConfig': Register(addr=0x400F)
             }


@dataclass
class PuraLevi30Config:
    port: str = ''
    baud: int = 57600
    serial_num: str = 'nnnnnn-nnnn'
    device_addr: int = 0
    update_rate_ms: int = 0
    waveform: str = 'none, 0'


class PuraLevi30(pyGeneric.GenericDevice):
    def __init__(self, name):
        super().__init__(name)
        self.cfg = PuraLevi30Config()
        self.waveform = pyWaveformGen.WaveformGen(parent=self)

        self.hw = None
        self.mutex = Lock()

        self.__thread = None
        self._event_halt = Event()

        self._buffer = np.zeros(1, dtype=self.data_dtype)
        self.buf_len = 1

        self.last_speed = 0

    def open(self):
        if self.cfg.port != '':
            self._lgr.info(f'{self.name}: Opening PuraLev i30 at {self.cfg.port}')
            try:
                with self.mutex:
                    self.hw = modbus.Instrument(self.cfg.port, 1, modbus.MODE_RTU, debug=False)
                    self.hw.serial.baudrate = self.cfg.baud
                    self.hw.serial.bytesize = 8
                    self.hw.serial.parity = serial.PARITY_EVEN
                    self.hw.serial.stopbits = 1
                    self.hw.serial.timeout = 3
            except serial.serialutil.SerialException as e:
                self._lgr.exception(e)
                raise i30Exception(f'Could not open Puralev {self.name} - {self.cfg}')
        self._queue = Queue()

    def close(self):
        if self.hw:
            with self.mutex:
                self.hw.serial.close()
            self.stop()

    def start(self):
        self._lgr.debug(f'{self.name}: stopping any existing thread')
        self.stop()

        super().start()
        self._event_halt.clear()

        self.__thread = Thread(target=self.run)
        self.__thread.name = f'{__name__} {self.name}'
        self.__thread.start()
        self.set_speed(self.last_speed)
        self._lgr.debug(f'{self.name}: starting at speed {self.last_speed}')

    def stop(self):
        if self.__thread and self.__thread.is_alive():
            self._event_halt.set()
            self.__thread.join(2.0)
            self.__thread = None
        else:
            self._lgr.debug(f'{self.name}: in stop(), no active thread')

        if self.hw:
            with self.mutex:
                try:
                    reg = WriteRegisters['State']
                    self.hw.write_register(reg.addr, PumpState.Off, functioncode=ModbusFunction.HoldRegister)
                    self._lgr.debug(f'{self.name}: in stop(), set pump state to off')
                except modbus.NoResponseError as e:
                    self._lgr.exception(e)
            self._buffer[0] = 0
            self._queue.put((self._buffer, utils.get_epoch_ms()))
            self.last_speed = 0
        else:
            self._lgr.debug(f'{self.name}: in stop(), no valid hw')
        super().stop()

    def has_started(self):
        return self.__thread.is_alive()

    def is_running(self):
        # JWK, replace with call to hardware to verify actually running
        return self.last_speed > 0.0

    def write_config(self):
        self.cfg.waveform = self.waveform.get_config_str()
        PerfusionConfig.write_from_dataclass('hardware', self.name, self.cfg, classname=self.__class__.__name__)

    def read_config(self):
        PerfusionConfig.read_into_dataclass('hardware', self.name, self.cfg)
        self._lgr.debug(f'config for {self.name} is {self.cfg}')
        self._lgr.debug(f'Creating waveform {self.cfg.waveform}')
        self.waveform = pyWaveformGen.create_waveform_from_str(self.cfg.waveform, parent=self)
        if self.waveform is None:
            self._lgr.error(f'Unknown waveform string: {self.cfg.waveform}')
        if self.cfg.update_rate_ms == 0 and type(self.waveform) == pyWaveformGen.SineGen:
            self.cfg.update_rate_ms = int(((1.0 / self.waveform.cfg.bpm) * 1_000.0) / 10.0)
            self._lgr.warning(f'{self.name}: No update rate specified for sine waveform,'
                              f'setting to {self.cfg.update_rate_ms} ms '
                              f'(10 the sinusoidal period of {self.waveform.cfg.bpm}')

        self.open()

    def update_waveform(self, waveform_cfg):
        self.waveform = pyWaveformGen.create_waveform_from_config(waveform_cfg)

    def set_speed(self, rpm: int):
        if rpm < 0:
            rpm = 0
            self._lgr.warning(f'Attempt to set rpm ({rpm}) below zero. Setting to 0.')
        rpm = int(rpm)

        if self.hw:
            with self.mutex:
                try:
                    reg = WriteRegisters['SetpointSpeed']
                    self.hw.write_register(reg.addr, rpm, functioncode=ModbusFunction.HoldRegister)
                    reg = WriteRegisters['State']
                    self.hw.write_register(reg.addr, PumpState.SpeedControl, functioncode=ModbusFunction.HoldRegister)
                except modbus.InvalidResponseError as e:
                    self._lgr.warning(f'{self.name}: when trying to set speed, received Invalid Response')
                    self._lgr.exception(e)

        self.last_speed = rpm
        self._buffer[0] = rpm
        t = utils.get_epoch_ms()
        self._queue.put((self._buffer, t))

    def set_flow(self, percent_of_max: float):
        self._lgr.info(f'Setting flow to {percent_of_max}%')
        if self.hw:
            with self.mutex:
                reg = WriteRegisters['SetpointProcess']
                self.hw.write_register(reg.addr, int(percent_of_max*100), functioncode=ModbusFunction.HoldRegister)
                reg = WriteRegisters['State']
                self.hw.write_register(reg.addr, PumpState.SpeedControl, functioncode=ModbusFunction.HoldRegister)

    def get_speed(self) -> int:
        if self.hw:
            with self.mutex:
                reg = ReadRegisters['SetpointSpeed']
                rpm = self.hw.read_register(reg.addr, functioncode=ModbusFunction.InputRegister)
                return rpm
        else:
            return 0

    def get_flow(self) -> float:
        if self.hw:
            with self.mutex:
                reg = ReadRegisters['SetpointProcess']
                percent = self.hw.read_register(reg.addr, functioncode=ModbusFunction.InputRegister)
                return percent / 100.0

    def get_data(self):
        buf = None
        t = None
        try:
            buf, t = self._queue.get(timeout=1.0)
        except Empty:
            # this can occur if there are attempts to read data before it has been acquired
            # this is not unusual, so catch the error but do nothing
            pass
        return buf, t

    def run(self):
        t = 0
        last_speed = self.get_speed()
        if self.waveform is None:
            self._lgr.error(f'Missing waveform for {self.name}')
            return
        if self.cfg.update_rate_ms == 0:
            self._lgr.warning(f'Update rate is 0, stopping thread')
            return
        while not PerfusionConfig.MASTER_HALT.is_set():
            period_timeout = self.cfg.update_rate_ms / 1_000.0
            if not self._event_halt.wait(timeout=period_timeout):
                t = t + period_timeout
                new_speed = self.waveform.get_value_at(t)
                if new_speed != last_speed:
                    self.set_speed(new_speed)
                    last_speed = new_speed
            else:
                break


class Mocki30(PuraLevi30):
    def __init__(self, name: str):
        super().__init__(name)
        self.state = PumpState.Off
        self.speed = 0
        self.process = 0

    def open(self):
        self._queue = Queue()

    def close(self):
        self.stop()

    def read_register(self, addr, number_of_decimals=0):
        if addr == ReadRegisters['SetpointProcess'].addr:
            return self.process
        elif addr == ReadRegisters['SetpointSpeed'].addr:
            return self.speed

    def write_register(self, addr, value):
        if addr == WriteRegisters['State'].addr:
            self.state = value
        elif addr == WriteRegisters['SetpointSpeed'].addr:
            self.speed = value
        elif addr == WriteRegisters['SetpointProcess'].addr:
            self.process = value
