CCR-SOP/OpenSourcePerfusionSystem/Code/PerfusionControl/pyPerfusion/pyAutoGasMixer.py

# -*- coding: utf-8 -*-
""" Class to auto adjust the percentages of gases in a GB100 gas mixer
    based on physiological values read from a CDI monitor

@project: LiverPerfusion NIH
@author: John Kakareka, NIH

This work was created by an employee of the US Federal Gov
and under the public domain.
"""

from threading import Thread, Event
from dataclasses import dataclass, field
from typing import List

from pyHardware.pyCDI import CDIData
import pyPerfusion.utils as utils
import pyPerfusion.PerfusionConfig as PerfusionConfig


@dataclass
class AutoGasMixerConfig:
    gas_device: str = ''
    data_source: str = ''
    adjust_rate_ms: int = 600_000


@dataclass
class ArterialAutoGasMixerConfig(AutoGasMixerConfig):
    pH_min: float = 0.0
    pH_max: float = 0.0
    CO2_min: float = 0.0
    CO2_max: float = 0.0
    O2_min: float = 0.0
    O2_max: float = 0.0
    PO2_min: float = 0.0
    PO2_max: float = 0.0
    CO2_adjust: float = 0.0
    flow_adjust: float = 0.0
    flow_cancel: float = 0.0
    flow_resume: float = 0.0
    O2_channel: int = 0
    CO2_channel: int = 0


@dataclass
class VenousAutoGasMixerConfig(AutoGasMixerConfig):
    pH_min: float = 0.0
    pH_max: float = 0.0
    O2_min: float = 0.0
    O2_max: float = 0.0

    O2_adjust: float = 0.0
    flow_adjust: float = 0.0
    O2_channel: int = 0
    N2_channel: int = 0


class AutoGasMixer:
    def __init__(self, name: str):
        self.name = name
        self._lgr = utils.get_object_logger(__name__, self.name)
        self.gas_device = None
        self.data_source = None
        self.cfg = AutoGasMixerConfig()

        self.acq_start_ms = 0
        self._event_halt = Event()
        self.__thread = None
        self.is_streaming = False

    @property
    def is_running(self):
        return self.is_streaming

    def write_config(self):
        PerfusionConfig.write_from_dataclass('automations', self.name, self.cfg, classname=self.__class__.__name__)

    def read_config(self):
        PerfusionConfig.read_into_dataclass('automations', self.name, self.cfg)

    def run(self):
        self.is_streaming = True
        # JWK, this assumes the take to get the data and make the
        # adjustments is small compared to the adjust rate so timing drift
        # is small
        while not PerfusionConfig.MASTER_HALT.is_set():
            timeout = self.cfg.adjust_rate_ms / 1_000.0
            if self._event_halt.wait(timeout):
                break
            if self.gas_device and self.data_source:
                ts, all_vars = self.data_source.get_last_acq()
                if all_vars is not None:
                    cdi_data = CDIData(all_vars)
                    self.update_on_input(cdi_data)
                # else:
                    # self._lgr.debug(f'{self.name} No CDI data. Cannot run gas mixers automatically')

    def start(self):
        self.stop()
        self._event_halt.clear()
        self.acq_start_ms = utils.get_epoch_ms()

        self.__thread = Thread(target=self.run)
        self.__thread.name = f'AutoGasMixer {self.name}'
        self.__thread.start()
        self._lgr.info(f'AutoGasMixer {self.name} started')

    def stop(self):
        if self.is_streaming:
            self._event_halt.set()
            self.is_streaming = False
            self._lgr.info(f'AutoGasMixer {self.name} stopped')

    def update_on_input(self, data):
        # this is the base class, so do nothing
        # This can be used when an automation object needs to be supplied
        # but no automation is necessary (e.g., panel_gas_mixers)
        pass


class AutoGasMixerVenous(AutoGasMixer):
    def __init__(self, name: str):
        super().__init__(name)
        self._lgr = utils.get_object_logger(__name__, self.name)
        self.cfg = VenousAutoGasMixerConfig()

    def update_on_input(self, data):
        try:
            self._update_O2(data.venous_sO2)
            self._update_flow(data.venous_pH)
        except AttributeError:
           # this will happen if there is invalid CDI data
            pass

    def _update_flow(self, pH: float):
        if pH == -1:
            self._lgr.warning(f'{self.name} pH is out of range. Cannot be adjusted automatically')
        elif pH < self.cfg.pH_min:
            self.gas_device.adjust_flow(self.cfg.flow_adjust)
            self._lgr.info(f'{self.name} is acidotic (pH={pH:1.2f}), increasing total flow by {self.cfg.flow_adjust}')
        elif pH > self.cfg.pH_max:
            self.gas_device.adjust_flow(-self.cfg.flow_adjust)
            self._lgr.info(f'{self.name} is alkalotic (pH={pH:1.2f}), decreasing total flow by {self.cfg.flow_adjust}')

    def _update_O2(self, O2: float):
        O2_adjust = 0

        if O2 == -1:
            self._lgr.warning(f'{self.name}: O2 is out of range. Cannot be adjusted automatically')
        elif O2 < self.cfg.O2_min:
            O2_adjust = self.cfg.O2_adjust
            self._lgr.info(f'{self.name}: O2 low. Increasing O2 percentage by {O2_adjust}%')
        elif O2 > self.cfg.O2_max:
            O2_adjust = -self.cfg.O2_adjust
            self._lgr.warning(f'{self.name}: O2 high. Decreasing O2 percentage by {O2_adjust}%')
        if O2_adjust != 0:
            new_percent = self.gas_device.get_percent_value(self.cfg.O2_channel) + O2_adjust
            self.gas_device.set_percent_value(2, 100-new_percent)  # only adjust channel 2
            self._lgr.info(f'O2 updated to {new_percent}')


class AutoGasMixerArterial(AutoGasMixer):
    def __init__(self, name: str):
        super().__init__(name)
        self._lgr = utils.get_object_logger(__name__, self.name)
        self.cfg = ArterialAutoGasMixerConfig()

    def update_on_input(self, data):
        try:
            self.update_CO2(data.arterial_pH, data.arterial_CO2)
            #self._update_O2(data.arterial_sO2)
            self._update_PO2(data.arterial_O2, data.arterial_pH)
        except AttributeError:
            # this will happen if there is invalid CDI data
            pass

    def update_CO2(self, pH: float, CO2: float):
        co2_adjust = 0
        check_co2 = False
        if pH == -1:
            self._lgr.warning(f'{self.name}: pH is out of range. Cannot be adjusted automatically')
            check_co2 = True
        elif pH < self.cfg.pH_min:
            co2_adjust = -self.cfg.CO2_adjust
            self._lgr.info(f'{self.name} is acidotic (ph={pH:1.2f}), decreasing CO2')
        elif pH > self.cfg.pH_max:
            co2_adjust = self.cfg.CO2_adjust
            self._lgr.info(f'{self.name} is alkalotic (ph={pH:1.2f}), increasing C02')
        else:
           check_co2 = True

        if check_co2 is True:
            if CO2 == -1:
                self._lgr.warning(f'{self.name}: CO2 is out of range. Cannot be adjusted automatically')
            elif CO2 < self.cfg.CO2_min:
                co2_adjust = self.cfg.CO2_adjust
                self._lgr.warning(f'{self.name}: CO2 low, blood alkalotic')
            elif CO2 > self.cfg.CO2_max:
                co2_adjust = -self.cfg.CO2_adjust
                self._lgr.warning(f'{self.name}: CO2 high, blood acidotic')

        if co2_adjust != 0:
            new_percent = self.gas_device.get_percent_value(self.cfg.CO2_channel) + co2_adjust
            self.gas_device.set_percent_value(self.cfg.CO2_channel, new_percent)
            self._lgr.debug(f'CO2 updated')

    def _update_PO2(self, PO2: float, pH: float):
        if PO2 == -1:
              self.gas_device.bolus_O2()
              self.gas_device.cancel_flow()
              self._lgr.warning(f'{self.name}:PO2 is out of range. Cannot be adjusted automatically')
        elif PO2 < self.cfg.PO2_min:
              self.gas_device.bolus_O2()
              self.gas_device.resume_flow()
              self._lgr.info(f'{self.name}: PO2 low: {PO2}. Resuming flow.')
        elif PO2 > self.cfg.PO2_max:  # and pH < self.cfg.pH_max:
              self.gas_device.bolus_O2()
              self.gas_device.cancel_flow()
              self._lgr.info(f'{self.name}: PO2 high: {PO2}.Stopping flow.')
        elif PO2 > self.cfg.PO2_max and pH > self.cfg.pH_max:
              self.gas_device.bolus_CO2()
              self.gas_device.resume_flow()
              self._lgr.warning(f'{self.name}: PO2 high: {PO2} but artery is basic: {pH}. Bolusing CO2.')


#    def _update_O2(self, O2: float):
#
 #       if O2 == -1:
  #          self._lgr.warning(f'{self.name}: O2 is out of range. Cannot be adjusted automatically')
   #     elif O2 < self.cfg.O2_min:
    #        self.gas_device.adjust_flow(self.cfg.flow_adjust)
     #       self._lgr.info(f'{self.name}: O2 low. {O2}. Increasing total flow by {self.cfg.flow_adjust}')
      #  elif O2 > self.cfg.O2_max:
       #     self.gas_device.adjust_flow(self.cfg.flow_adjust)
        #    self._lgr.warning(f'{self.name}: O2 high. Decreasing total flow by {self.cfg.flow_adjust}')
