CCR-SOP/OpenSourcePerfusionSystem/Code/PerfusionControl/pyPerfusion/Strategies.py

# -*- coding: utf-8 -*-
"""Base class for processing stream data


@project: LiverPerfusion NIH
@author: John Kakareka, NIH

This work was created by an employee of the US Federal Gov
and under the public domain.
"""
import pyPerfusion.PerfusionConfig as PerfusionConfig
import pyPerfusion.Strategy_Processing as Strategy_Processing
import pyPerfusion.Strategy_ReadWrite as Strategy_RW


def get_class(name: str):
    if name == 'RMS':
        return Strategy_Processing.RMS
    elif name == 'MovingAverage':
        return Strategy_Processing.MovingAverage
    elif name == 'RunningSum':
        return Strategy_Processing.RunningSum
    elif name == 'WriterStream':
        return Strategy_RW.WriterStream
    elif name == 'WriterPoints':
        return Strategy_RW.WriterPoints
    else:
        return None


def get_strategy(name: str):
    params = PerfusionConfig.read_section('strategies', name)
    strategy_class = get_class(params['algorithm'])
    cfg = strategy_class.get_config_type()()
    PerfusionConfig.read_into_dataclass('strategies', params['algorithm'], cfg)
    strategy = strategy_class(cfg.name, cfg.window_len, cfg.buf_len)
    return strategy
