CCR-SOP/OpenSourcePerfusionSystem/(commit log)

2019-03-18 basic half sketch of perfusion lid
    [perfusion_basket.SLDPRT]
2019-03-18 Redo sketch as previous one didn't line up well. This one based on horizontal (across major axis) distances and slot-slot distances.
    [perfusion_basket.SLDPRT]
2019-03-18 Basic lid, good enough for initial testing.
    [perfusion_basket.SLDPRT]
2019-03-20 Reduce Control Point to lip edge form 9mm to 7mm. First prototype did not fit properly within recessed lip.
    [perfusion_basket.SLDPRT]
2019-03-20 very basic wedge design as suggested by Tom
    [BladderWedge.SLDPRT]
2019-03-25 Update lid for an empty center in preparation for a two part design
    [perfusion_basket.SLDPRT]
2019-03-26 add assembly for entire lid and create a holder to bolt underlying fabric sheet to hold liver
    [FabricHolder.sldprt, LidAssembly.SLDASM]
2019-03-26 Initial design for wedge
    [BladderWedge.SLDPRT]
2019-03-26 fTAM vacuum chamber base (flashcube vacuum chamber 1b) from Tom Pohida
    [BladderBase.sldprt]
2019-03-26 new part for bladder assembly
    [BladderAssembly.SLDASM, BladderBase.sldprt, BladderWindow.sldprt]
2019-03-27 updates to lidassembly
    [LidAssembly.SLDASM]
2019-03-28 Updates so bladder backing can be cut from acyrlic for quicker design iterations
    [BladderAssembly.SLDASM, BladderBacking.sldprt, FlexibleBottomSupportHolder.sldprt, LidAssembly.SLDASM, perfusion_basket_lid.SLDPRT]
2019-04-01 Add a bladder mask so bladder portion is completely separate from lid
    [BladderBacking.sldprt, BladderMask.sldprt, LidAssembly.SLDASM, perfusion_basket_lid.SLDPRT]
2019-04-02 add support piece to mate existing bladder window to clamped membrane support
    [BladderToSupportSpacer.SLDPRT]
2019-04-03 Add new clamps for holding flexible bottom material Add supports and clamps to main assembly
    [BladderAssembly.SLDASM, BladderWindow.sldprt, BottomSupportClamps.sldprt]
2019-04-03 Had to rebuild assembly for unknown reason
    [BladderAssembly.SLDASM]
2019-04-04 add datasheet for BPS120 pressure sensor which will be used to hopefully measure the pressure of the bladder
2019-04-04 initial commit of MSPWare I2C example
2019-04-04 Add small hook to support a rod to cause the bladder to divide into two regions
    [BladderAssembly.SLDASM, BladderDividerHook.SLDPRT]
2019-04-04 add global variables for a few dimensions
    [BladderBase.sldprt, BladderWindow.sldprt]
2019-04-04 add microcontroller user's guide being used to test pressure sensor
2019-04-04 Add code specific to BPS120 sensor to I2C example
2019-04-09 update graphics demo for basic buttons for inflating and deflating
2019-04-09 Create new test project to test GPIO control of bladder relays. Based on simple GUI test program
2019-04-09 Update basic bladder control program with inflate/deflate buttons tied to GPIO Remove unused code
2019-04-10 New bottom support bracket. Full rectangular design and double-slots to hold rubber sheet/fabric
    [BottomSupport.SLDPRT]
2019-04-12 Wide bracket offset and use only a single slot...originally design could not be cut correctly using acrylic
    [BottomSupport.SLDPRT]
2019-04-12 Redesign bladder base and assembly: rounded edges to prevent tearing of rubber sheet, no inset in bladder base (not needed)
    [BladderAssembly.SLDASM, BladderBase.sldprt, BladderDividerHook.SLDPRT, BladderWindow.sldprt, BottomSupportClamps.sldprt]
2019-04-16 Update bladder hook to add a rear hook for attaching string/cable etc to limit the bladder expansion in certain areas
    [BladderAssembly.SLDASM, BladderDividerHook.SLDPRT]
2019-04-17 Update divider hook...use a rounded edge on top and bottom to make it easier to slide onto assembly, remove screw hole (ideally unnecessary), and eliminate tab to hook onto top (there is some width v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
    [BladderAssembly.SLDASM, BladderDividerHook.SLDPRT]
2019-04-18 Add square pegs to bottom of Bladder to act as posts for locking hooks Update locking hooks to fit square pegs
    [BladderAssembly.SLDASM, BladderBase.sldprt, BladderDividerHook.SLDPRT, BladderWindow.sldprt]
2019-04-18 Add two small hooks to bottom of bladder hooks as a tie off
    [BladderAssembly.SLDASM, BladderDividerHook.SLDPRT]
2019-04-23 Remove tie-offs and redesign hooks to fit between pegs instead of over them. Less stress on hooks and allows them to be more easily added.
    [BladderAssembly.SLDASM, BladderDividerHook.SLDPRT]
2019-04-23 Add BladderSheet to assembly Add fillet to inside of bladderhooks for more strength
    [BladderAssembly.SLDASM, BladderDividerHook.SLDPRT, BladderSheet.sldprt, BladderWindow.sldprt]
2019-04-23 circuit board to interface pressure sensors and relays to uproc board
    [MSP430F5529_Relays_PressureSensor.brd, MSP430F5529_Relays_PressureSensor.sch]
2019-04-24 Fix error on pressure board (launchpad header rotated 180 )
    [MSP430F5529_Relays_PressureSensor.brd]
2019-04-25 Add new design for hold the bladder assembly and bottom support using a height bar with holes between clips.
    [BladderAndSupport.SLDASM, BladderAssembly.SLDASM, BladderDividerHook.SLDPRT, BottomSupportSheetClip.SLDPRT, HeightBar.SLDPRT]
2019-04-25 Update sheet clip and heightbar (heightbar needs to be thicker and clip needs a larger jaw to account for support sheet Height bar will screw into clip as it need to resist bladder moving upwards
    [BladderAndSupport.SLDASM, BottomSupportSheetClip.SLDPRT, HeightBar.SLDPRT]
2019-04-25 Add debouncing to the touchscreen and enlarge buttons
2019-04-25 create helper function for creating buttons
2019-04-25 Update thickness of support bracket to proper 1/4" Move screw hold for bottom support hook to underneath hook so there is more material for strength Slim outside thickness for bottom support hook so 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
    [BladderAndSupport.SLDASM, BottomSupport.SLDPRT, BottomSupportSheetClip.SLDPRT]
2019-04-26 Fix bug where timer IRQ not cleared which prevent IRQ from firing after wraparound Some other style changes and removal of test code
    [main.c]
2019-04-26 add doc on I2C comm for Honeywell sensor
2019-04-26 Move driverlib and grlib to main parent directory so all project can access In project, grlib folder cannot be named "grlib" for some reason (causes linking errors, may be grlib is #define or somethi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
2019-04-26 Update clips and hooks to use a slotted mechanism for locking
    [BladderAndSupport.SLDASM, BladderAssembly.SLDASM, BladderDividerHook.SLDPRT, BottomSupportSheetClip.SLDPRT]
2019-04-26 Update pressuresensor test app for basic operation Based off TI example usci_b_i2c_ex4_masterRxMultiple
2019-04-26 refactor i2c code into separate files for re-use in other projects
2019-04-30 move driverlib files into a subfolder of project
2019-05-02 updates to fix bad I2C communication and data read
    [main.c]
2019-05-02 code cleanup to SSC driver
2019-05-07 Updates to properly integrate LCD/Touchscreen with I2C sensor Key point is the setup of the clock
2019-05-07 add some additional datasheets (main 5529, TFT/LCD driver, and MSP430 I2C comm)
2019-05-08 Update I2C test program to explicitly set clocks to verify the needed clocks for the TFT/LCD are compatible with the I2C
2019-05-08 use OPAQUE_TEXT when printing psi
2019-05-08 return PSI as milliPSI as the pressure measured from the bladder is sub-0 typically
2019-05-08 cycle pressure based on preset values instead of timing. Check pressure every 0.25 seconds
2019-05-09 Update touchscreen to use an interrupt timer for checking for touches
2019-05-09 git move driverlib and grlib files into project folders
2019-05-13 Fix driverlib references
2019-05-13 add text doc listing all resources used to avoid pin double-use
2019-05-14 Circular Joint
    [BladderAndSupport.SLDASM, BladderAssembly.SLDASM, BladderDividerHook.SLDPRT, BottomSupportSheetClip.SLDPRT]
2019-05-14 Added tolerances and addition config for joint
    [BottomSupportSheetClip.SLDPRT]
2019-05-14 Added tolerances- .005 and .002
    [BladderDividerHookJointTest.STL, BottomSupportSheetClip .002.STL, BottomSupportSheetClip .005.STL, BottomSupportSheetClip.SLDPRT, BottomSupportSheetClipJointTest.STL]
2019-05-14 Added tolerances- .009 and .007
    [BottomSupportSheetClip .007.STL, BottomSupportSheetClip .009.STL, BottomSupportSheetClip.SLDPRT]
2019-05-14 Removed slot in bladder divider hook
    [BladderAndSupport.SLDASM, BladderAssembly.SLDASM, BladderDividerHook.SLDPRT, BottomSupportSheetClip.SLDPRT]
2019-05-14 Revert "move driverlib files into a subfolder of project"
    This reverts commit 253463cd37a9dcfbef35b17092f9508c9da7f380.
    Main PC failed before commit could be pushed to github. Continued work on laptop and fixed all issues from this commit.
2019-05-15 Switching back to work on PC, needed to re-add MainApp to workspace
2019-05-15 add new test program allowing to cycle pressure without the LCD This is was done due to the only one LCD in stock and allows testing cycling while developing new GUI for LCD
2019-05-15 added divider hook with submerged clip/extension and set joint as .009 tol
    [BladderDividerHook with clip.STL, BladderDividerHook.SLDPRT, BladderDividerHook.STL, BottomSupportSheetClip fullsize .009.STL, BottomSupportSheetClip.SLDPRT]
2019-05-15 added addition hooks and shortened length of dividerhook
    [BladderDividerHook with clip.STL, BladderDividerHook.SLDPRT, BladderDividerHook.STL, BladderDividerHookJointTest.STL, BottomSupportSheetClip .002.STL, BottomSupportSheetClip .005.STL, BottomSupportSheetClip .007.STL, BottomSupportSheetClip .009.STL]
2019-05-15 bug fixes to basic GUI control. Not all buttons are enabled yet, titles and background not working
    [main.c]
2019-05-16 changed drawing references to dividerhook and bottomsupportsheetclip and added additional parts to the assembly
    [BladderAndSupport.SLDASM, BladderAssembly.SLDASM, BladderDividerHook.SLDPRT, BottomSupport.SLDPRT, BottomSupportSheetClip.SLDPRT]
2019-05-16 added more clips to the assembly
    [BladderAndSupport.SLDASM, BladderAssembly.SLDASM]
2019-05-16 add actions for all buttons on GUI (+/-, high/low)
2019-05-16 Unsure of why this project settings changed, probably related to renaming (grlib->grilib_local, driverlib->driverlib_local)
2019-05-16 add pullup resistors to I2C lines
    [MSP430F5529_Relays_PressureSensor.brd, MSP430F5529_Relays_PressureSensor.sch]
2019-05-16 Add CK switches datasheet
2019-05-16 Substitute right angle pressure sensor
    [MSP430F5529_Relays_PressureSensor.brd, MSP430F5529_Relays_PressureSensor.sch]
2019-05-16 Add switches for control of LCD instead of touchscreen
    [MSP430F5529_Relays_PressureSensor.brd, MSP430F5529_Relays_PressureSensor.sch]
2019-05-20 changed pushdown hook to adjust from lower joint
    [BladderDividerHook.SLDPRT]
2019-05-20 add board to align switches around LCD
    [GUI_Switches.brd, GUI_Switches.sch]
2019-05-20 Add power supply and connector for GUI_Switches board
    [GUI_Switches.brd, GUI_Switches.sch, MSP430F5529_Relays_PressureSensor.brd, MSP430F5529_Relays_PressureSensor.sch]
2019-05-21 add mounting holes
    [MSP430F5529_Relays_PressureSensor.brd]
2019-05-21 minor update to silkscreen
    [MSP430F5529_Relays_PressureSensor.brd]
2019-05-21 Fix mistakes where power supply and terminal on bottom but use bottom traces Put both on top (top of supply will still be below LCD) and fix traces Some other minor layout adjustments (move pressure 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
    [MSP430F5529_Relays_PressureSensor.brd, MSP430F5529_Relays_PressureSensor.sch]
2019-05-21 Update doc file with missing 6 switch GPIO pin
2019-05-21 add driver for mechanical switches
2019-05-21 refactor code so touchscreen and mechanical switches alter program operation
2019-05-21 add Switches.* to project
2019-05-21 Replace P7.4 with P2.3 as P7.4 is not IRQ-capable
    [MSP430F5529_Relays_PressureSensor.brd, MSP430F5529_Relays_PressureSensor.sch]
2019-05-21 Check current panel mode before looking as switches as they are duplicated.
2019-05-21 modified lid
    [BladderBacking.sldprt, BladderMask.sldprt, LidAssembly.SLDASM]
2019-05-29 "Changed Lid assembly"
    [BladderBacking.sldprt, BladderMask.sldprt, LidAssembly.SLDASM, perfusion_basket_lid.SLDPRT]
2019-05-29 added lid and handle
    [BladderDividerHook.SLDPRT, BladderMask.sldprt, Lid Handle.SLDPRT, Lid.SLDPRT, LidAssembly.SLDASM]
2019-05-30 made lid handle smaller
    [BladderMask.sldprt, Lid Handle.SLDPRT, Lid.SLDPRT, LidAssembly.SLDASM]
2019-05-30 update used pins docs for GPIO switch (port 7 does not support interrupts)
2019-05-31 added air filter and regulator
    [Air Filter.SLDPRT, Air Regulator.SLDPRT]
2019-05-31 added valves to pneumatic parts
    [Air Filter.SLDPRT, Air Regulator.SLDPRT]
2019-05-31 added air fill bleed
    [Air Fill Bleed.SLDPRT]
2019-06-03 added pneumatic assembly and mounting board
    [Pneumatic Assembly.SLDASM, Pneumatic Base.SLDPRT]
2019-06-05 removed mounting brackets and using hole to mount filter
    [Air Filter Mount.SLDPRT, Pneumatic Assembly.SLDASM, Pneumatic Base Stand.SLDPRT, Pneumatic Base.SLDPRT]
2019-06-07 right-angle SMT sensor has a different slave address. Use #ifdef to choose which sensor is being used
2019-06-10 add new sensor information Update min/max default values Fix bug where pressures were off by factor of 10
    [main.c]
2019-06-14 added config to bottom support with rounded corners
    [BottomSupport.SLDPRT]
2019-06-14 made clips narrower
    [BladderAndSupport.SLDASM, BladderAssembly.SLDASM, BladderBase.sldprt, BladderDividerHook.SLDPRT, BladderSheet.sldprt, BladderWindow.sldprt, BottomSupport.SLDPRT, BottomSupportSheetClip.SLDPRT]
2019-06-17 Update hole for 15/32 feedthrough pneumatic (Clippard part 15027)
    [BladderBase.sldprt]
2019-06-17 made joint modifications on clips to flip system
    [BladderAndSupport.SLDASM, BladderDividerHook.SLDPRT, BottomSupportSheetClip.SLDPRT]
2019-06-18 modified tolerances and made the female joint shorter
    [BladderAndSupport.SLDASM, BladderDividerHook.SLDPRT, BottomSupportSheetClip.SLDPRT]
2019-06-18 updated assembly
    [BladderAndSupport.SLDASM, BottomSupportSheetClip.SLDPRT]
2019-06-19 updated old assembly to be accurate
    [BladderAndSupport.SLDASM, BladderDividerHook.SLDPRT, BottomSupportSheetClip.SLDPRT]
2019-06-20 checking dividerhook tolerances
    [BladderAndSupport.SLDASM, BladderDividerHook.SLDPRT]
2019-06-20 switch to master
    [BladderAndSupport.SLDASM, BladderAssembly.SLDASM, BladderBase.sldprt, BladderDividerHook.SLDPRT, BladderSheet.sldprt, BladderWindow.sldprt, BottomSupport.SLDPRT, BottomSupportSheetClip.SLDPRT]
2019-06-24 modified support sheet clip tolerances to account for eden
    [BladderAndSupport.SLDASM, BladderDividerHook.SLDPRT, BottomSupportSheetClip.SLDPRT]
2019-06-28 modified bladder base
    [BladderAndSupport.SLDASM, BladderAssembly.SLDASM, BladderBase.sldprt, BladderDividerHook.SLDPRT, BladderWindow.sldprt, BottomSupportSheetClip.SLDPRT]
2019-07-02 made trench deeper in bladderback
    [BladderBase.sldprt]
2019-07-22 modified tolerances and clips
    [BladderAndSupport.SLDASM, BladderAssembly.SLDASM, BladderBase.sldprt, BladderDividerHook milling template no hook 1 .42.SLDPRT, BladderDividerHook milling template no hook 2 .42.SLDPRT, BladderDividerHook milling template no hook 2.SLDPRT, BladderDividerHook milling template no hook.SLDPRT, BladderDividerHook milling template.SLDPRT]
2020-07-31 Move datasheets for custom diaphragm pump to sub-folder to differentiate in anticipation of adding more datasheets for other aspects of perfusion system
2020-07-31 Move compression models into subfolder
    [Air Fill Bleed.SLDPRT, Air Filter Mount.SLDPRT, Air Filter.SLDPRT, Air Regulator.SLDPRT, BladderAndSupport.SLDASM, BladderAssembly.SLDASM, BladderBacking.sldprt, BladderBase.sldprt]
2020-07-31 rename PressureSensor to more DiaphragmControl to better reflect actual code
2020-08-20 add second page showing how different pumps and sensors are controlled
2020-08-21 update plotting panel to switch between different sensors and plot dummy data for testing
2020-08-21 copy of mock sensor classes from another project
2020-08-21 add a sensor name to the classes to keep track of sensors
2020-08-21 simple program to test creation and use of mock sensors
2020-08-28 Added SW Model of Dexcom Glucose Sensor
    [Dexcom_Glucose_Sensor.SLDPRT]
2020-08-28 Added SW model of Platform Holder for the Dexcom
    [Glucose_Sensor_Adapter_Platform.SLDPRT]
2020-08-28 Added SW model of Tubing where Dexcom inserts
    [Glucose_Sensor_Adapter_Tubing.SLDPRT]
2020-08-28 Added SW assembly for the Dexcom parts
    [Glucose_Sensor_Assembly.SLDASM]
2020-08-28 Moved all Dexcom files to subfolder 'DexcomSensor'
    [Dexcom_Glucose_Sensor.SLDPRT, Glucose_Sensor_Adapter_Platform.SLDPRT, Glucose_Sensor_Adapter_Tubing.SLDPRT, Glucose_Sensor_Assembly.SLDASM]
2020-08-28 Removed Dexcom files from main folder
    [Dexcom_Glucose_Sensor.SLDPRT, Glucose_Sensor_Adapter_Platform.SLDPRT, Glucose_Sensor_Adapter_Tubing.SLDPRT, Glucose_Sensor_Assembly.SLDASM]
2020-09-01 New Platform/Box Model Created
    [Glucose_Sensor_Adapter_Platform_pt2.SLDPRT]
2020-09-01 Updated Sensor to contain adhesive patch
    [Dexcom_Glucose_Sensor.SLDPRT, Glucose_Sensor_Adapter_Platform_pt2.SLDPRT]
2020-09-01 Added SW Assembly of updated platform and sensor
    [Glucose_Sensor_Assembly_pt2.SLDASM]
2020-09-02 Shortened the push on connector, removed "pt2" from platform file name
    [Glucose_Sensor_Adapter_Platform.SLDPRT, Glucose_Sensor_Adapter_Platform_pt2.SLDPRT]
2020-09-03 Updated assembly with new platform, removed "pt2" from file name
    [Glucose_Sensor_Assembly.SLDASM, Glucose_Sensor_Assembly_pt2.SLDASM]
2020-09-09 Deleted "Glucose_Sensor_Adapter_Tubing.SLDPRT"; no longer being used
    [Glucose_Sensor_Adapter_Tubing.SLDPRT]
2020-09-14 new manuals for peristaltic pump and Reglo Digital Pump
2020-09-15 Add base classes for acquiring sensor data and streaming to file
2020-09-15 add basic test program for testing SensorStream class
2020-09-15 update to use SensorStream Class use set_data functions for better plotting
2020-09-15 Update to use SensorStream and HWAcq classes
2020-09-15 re-add printing of header small code cleanups
2020-09-15 remove debug print
2020-09-15 Update choice box to reflect time frame to plot Create enum for management of time frames
2020-09-15 add read_period separate from sampling period to reflect that the ADC may read multiple samples for efficieny
2020-09-15 add support from getting data from starting add support for slicing full data based on samples needed
2020-09-16 code refactoring to ease overriding print header update for HWAcq queue changes (includes timestamp)
2020-09-16 refactor print header for better readability refactor main thread to extract writing to file for easier overriding by subclasses
2020-09-16 Fix print_header (fid does not have print()), refactor for cleaner updates
2020-09-16 refactor panel_plotting to support multiple lines based on number of sensors add helper function to HWAcq and SensorStream to retrieve size of buffers
2020-09-16 change some private var to protected to they can be accessed by subclass open file as binary and update text-based header printing accordingly
2020-09-16 add support for printing SensorEvents
2020-09-17 fix plotting format for events to only plot markers
    [panel_plotting.py]
2020-09-17 add class for saving event-type data (e.g. injections). The assumption is the samples are more widely spaced and not a continuous stream
2020-09-17 cut down on the wait time for halt event
2020-09-17 start sensors closer in time to one another slow down event creation
2020-09-18 add basic diagragm showing potential data pathways for glucose sensor
2020-09-22 add Reglo pump details for blood gas circuit
2020-09-22 Updated box design to strengthen adapters; shortened length of both the filament and the sensing portion of the filament in accordance with updated measurements
    [Dexcom_Glucose_Sensor.SLDPRT, Glucose_Sensor_Adapter_Platform.SLDPRT, Glucose_Sensor_Assembly.SLDASM]
2020-09-22 Updated box design
    [Dexcom_Glucose_Sensor.SLDPRT, Glucose_Sensor_Adapter_Platform.SLDPRT, Glucose_Sensor_Assembly.SLDASM]
2020-09-22 update SensorStream to use memory-mapped files for efficient reading and slicing of files over long time periods
2020-09-23 update SensorPoint to use new fid naming convention
2020-09-23 Updated box assembly to shorten inner channel
    [Glucose_Sensor_Adapter_Platform.SLDPRT, Glucose_Sensor_Assembly.SLDASM]
2020-09-23 refactor printing of stream info for easier overriding when subclasses need to add information
2020-09-23 set title of plot to sensor name
2020-09-23 provide SensorStream property to access expected units for sensor plot units along y-axis
2020-09-23 add support for showing a shaded area for valid sensor ranges
2020-09-23 on initial printing of shaded region, check for a valid region
2020-09-23 Changed filament angle to 30 degrees; further updated box design
    [Dexcom_Glucose_Sensor.SLDPRT, Glucose_Sensor_Adapter_Platform.SLDPRT]
2020-09-24 Finished updated design of glucose adapter w/shortened inner channel
    [Dexcom_Glucose_Sensor.SLDPRT, Glucose_Sensor_Adapter_Platform.SLDPRT, Glucose_Sensor_Assembly.SLDASM]
2020-09-24 reduce font size of time frame choice box
2020-09-25 add basic class for printint out a single number readout from a sensor
2020-09-25 add SensorStream as parameter, use sensor object for text values Add timer to get last value of sensor and display
2020-09-28 add valid ranges to sensors place readouts in a single columns expand plots
2020-09-28 refactor sensor loops as list comprehensions
2020-09-28 check for valid "valid range" before trying to print shaded area
2020-09-28 update so overrange and underrange have shaded areas create LongTerm (LT) subclass for plots printing from start (not title/labels) create getter/setter for frame_ms
2020-09-29 update SensorPoint to match fid read changes to SensorStream
2020-09-29 Added strain relief holes to sensor mount design
    [Dexcom_Glucose_Sensor.SLDPRT, Glucose_Sensor_Adapter_Platform.SLDPRT, Glucose_Sensor_Assembly.SLDASM]
2020-09-29 Shortened patch length to decrease overall length of platform for better drilling out of lumen
    [Dexcom_Glucose_Sensor.SLDPRT, Glucose_Sensor_Adapter_Platform.SLDPRT, Glucose_Sensor_Assembly.SLDASM]
2020-10-02 Replace protected classes for converting volts to counts and setting ao by counts with a single set_voltage. NIDAQ allows for specifying voltage directly, so the abstract class shouldn't assume it ne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
2020-10-02 add concrete class for setting the voltage on an NIDAQ analog output
2020-10-02 Update AOSine to generate sine wave data directly as NI USB devices do not support the FuncGen functionality Generate a single cyle of the desired sine wave and repeat until stopped
2020-10-02 fixes to pyAI to work with NIDAQ (which returns data as voltages, not adc counts)
    [pyAI.py]
2020-10-02 add concrete class for NIDAQ analog input update pyAI to pass buffer type since NIDAQ returns data converted into voltages (float64)
2020-10-02 BUGFIX: _convert_to_units should convert to specified datatype and return buffer
    [pyAI_NIDAQ.py]
2020-10-02 SensorStream.open should also call open of underlying HW object
2020-10-08 add text to right side of plot to display current value. Hernandez group prefers the current val be displayed with the associated plot rather than on a side panel.
2020-10-08 add flag to control display of current value readout. By default, long-term plots should not display the current values as it is redundant when paired with a time window display
2020-10-14 Notes on using Dexcom glucose sensors
2020-10-26 add notes for proper printing of the glucose mount
2020-10-27 Form3 file for glucose mount, printed at an angle on 2020-10-26 by Javier Mendez
2020-10-28 Decreased inner lumen diameter, decreased barb ID and OD
    [Dexcom_Glucose_Sensor.SLDPRT, Glucose_Sensor_Adapter_Platform.SLDPRT, Glucose_Sensor_Assembly.SLDASM]
2020-10-28 Move driver diagrams from ConceptLayout to SoftwareArchitecture Remove blank drawio file
2020-10-28 Add new classes for syringe control based on USB serial comm
2020-10-28 add classes for USBSerial and PHDserial (syringe pump)
2020-10-29 add functions to retrieve and print builtin syringe manufacturer info
2020-10-29 simple test program to verify proper retrieval of syringe manufacturers
2020-11-02 add additional test buttons for DIO
2020-11-03 move configuring of device from constructor to open() function so configuration can be done after creation
2020-11-03 fixes to syntax of pyserial. Rename self.__port to self.__serial
    [PHDserial.py]
2020-11-03 enable sine-wave specific controls only if sine checkbox checked. Reuse offset voltage for dc voltage (non-sine) control
2020-11-04 Update AOSine to support outputing a DC voltage to avoid need for a separate DC class
2020-11-04 refactor thread code so changes can be made without closing the AO channel
2020-11-04 Use former AOSine as new AO as it now supports setting a DC voltage directly
2020-11-04 Updated files in order to get list of syringe manufacturers correctly
    [PHDserial.py]
2020-11-05 Updated PHDSerial for successful fetching and display of syringe types and volumes
2020-11-05 Updated code to successfully set infusion rate/syringe type, and to initiate and stop infusions
2020-11-06 Fixed method for setting syringe type; added methods for seeing/clearing infusion volume; added methods for visualizing syringe parameters
    [PHDserial.py]
2020-11-09 Added output.txt file that displays syringe types/volumes from pytests.test_phdserial
2020-11-09 Updated hardware spec file to reflect how to control bvp-bp and peristaltic pump
2020-11-09 Updated hardware spec file to reflect control of syringe pump
2020-11-09 Updated hardware spec file to reflect gaining control of Reglo peristaltic pump
2020-11-09 Updated glucose sensor notes to reflect further details regarding the Dexcom sensors/third party data acquistion apps surrounding them
2020-11-10 Updated PHDserial.py to fix parsing of syringe volumes
    [PHDserial.py]
2020-11-10 Updated glucose sensor notes doc in relation to getting data via intercepting Bluetooth comms w/CGMBLEKit
2020-11-10 Updated glucose sensor notes doc
2020-11-10 Add Formlabs .form file used to 3D print commit 36855f49b59bfa24658830ba262c39643e00ae21
2020-11-12 Cleaned up code to eliminate polling switches, unnecessary while loops; overrode base "send" method to clear buffer after sending a string
2020-11-13 set default syringe address to 0, as non-programmable syringes can't be daisy-chained so all will be at same address of 0 and controlled by unique COM port
2020-11-13 add basic panel for testing and configuration of syringe pumps
2020-11-13 change get_syringe_xxx to update_syringe_ and add properties to underlying lists so values can be retrieved without redownloading from pump
2020-11-13 fix default of Baud rate add choice boxes for selection of syringe manufacturer and type
2020-11-13 when setting syringe manufacturer, do not set infusion rate, do that separately refactor set_parm string to use f formatting
2020-11-13 when a syringe type is selected, update the syringe pump with the new info
2020-11-13 add infuse and stop buttons
2020-11-16 add option to load/save current configuration
2020-11-17 add PerfusionConfig module to keep track of base folders and global config
2020-11-17 add helper function to create subfolder for streaming data Update SensorStream to use new PerfusionConfig class
2020-11-17 add PerfusionConfig support fix bug in how sensors are stopped at end of program
2020-11-19 add simple test app to test maintaining a flow rate based on sensor output
2020-11-19 add basic controls and plotting for pump (analog output) and sensor (analog input)
2020-11-19 add volts_offset property to retrieve expected offset in volts, needed for algorithms trying to maintain flow
2020-11-19 add timer to adjust analog output until measured sensor value matches desired value
2020-11-19 add label to show current analog ouput. print debug statements to terminal
2020-11-19 don't download syringe info on open, add manual button to download
2020-11-19 add setters for manufactuers and syringes lists so they can be set after reading data from a file
2020-11-19 add helper functions to read/save manufacturer info from syringe pumps
2020-11-19 clean up layout of controls and add a static box with name so it is clear which syringe is being controlled
2020-11-19 add array of syringe control in basic test
2020-11-19 force optionxform of ConfigParser to honor case of keys check for valid section, return empty map if none found
2020-11-19 fix bugs added during last refactor
    [pyAI.py, pyAI_NIDAQ.py]
2020-11-19 fix bug in variable naming during path creation do no open underlying hardware. New open() commands require parameters not available to SensorStream. Calling code responsible for opening the hardware
2020-11-20 default internal buffer to [] instead of None if len is checked before the AI is actually configured, it returns 0 instead of an error
    [pyAI.py]
2020-11-20 add ability to do 2pt cal, includes passing sensor to all the Panel classes. This code works but needs cleaning/refactoring
2020-11-20 make hw variable public so code using SensorStream can access underlying hardware for configuration
2020-11-20 add 2pt calibration functionality
2020-11-20 add ability to reset the calibration
    [panel_AI.py]
2020-11-20 add is_open property to AI class to prevent attempt to read_data before AI is opened()
    [pyAI.py, pyAI_NIDAQ.py]
2020-11-20 Tested compatibility of panel_Syringe with pump; maded minor modifications to PerfusionConfig such that configs were saved/loaded correctly
    [PHDserial.py, PerfusionConfig.py]
2020-12-01 Began schematic displaying all plumbing/connections for the perfusion machine
2020-12-01 Updated plumbing diagram, updated glucose sensor notes to reflect updates with our use of the G6 Commercial receiver, began updating Hardware Specs document with more detailed instructions for use
2020-12-01 Added documentation for heater oxygenator
2020-12-02 Added additional documentation files for BAT-12 Thermometer, Presens system, and heater/oxygenator
2020-12-03 Updated hardware specs sheet with information on pressure transducers
2020-12-09 documentation showing pin to wire color for VCS breakout. VCS pin numbering is non-standard from conventional DSub conventions.
2020-12-09 Correct mistakes from confusing Pin #'s with Bit #'s. Pinout confirmed with DMM
2020-12-14 Optimized loading in a syringe configurtion into panel_Syringe so that syringe can immediately be run after loading in; accomplished by updating infusion rate upon loading of the config
2020-12-15 Updated PerfusionConfig and panel_Syringe such that syringe libraries are loaded in correctly (i.e. syringe sizes after the first one no longer are loaded in with a space preceding them; prior to the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
    [PerfusionConfig.py]
2020-12-15 Updated panel to include 3 columns instead of 2; ensures that each individual syringe panel displays all buttons
2020-12-21 Updated DAQ routing doc to reflect that dialysis flow is being mesaured using an in-line flow sensor, rather than IVC flow
2020-12-21 Updated names of substances to be infused via syringe pump
2020-12-21 Updated syringe_gui to display an error message when trying to open an unavailable COM port
2020-12-21 Recommitting updated syringe_gui code after issue with local and remote repositories diverging
2021-01-04 Created preliminary framework for Dexcom sensor/receiver panel
2021-01-04 Further progressing in creation of Dexcom sensor panel
2021-01-05 Added new method in PerfusionConfig that returns receiver serial number/perfusion circuit location pair for each of the three Dexcom receivers
2021-01-05 Further updates to panel; connect button is no longer available if the receiver is changed after a previous receiver has been connected
2021-01-08 Updated plotting of glucose values; full date for each timepoint is shown to avoid problems with rescaling graph; disconnecting receiver adds a red line to the graph; errors from the sensor/receiver 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
2021-01-11 Further updated panel; tick marks on graph need to be made vertical, and app has error messages when a sensor run ends
2021-01-11 Updated perfusion config so that DAQ configuration data for the VCS is recorded in hardware.ini when it this data doesn't already exist (i.e. when a config is saved for the first time)
    [PerfusionConfig.py]
2021-01-11 Added functionality to save/load in configs for each valve
2021-01-12 update AO/AI lines for testing Update algorithm handling of deviation, flow returns 0-1.0V
2021-01-15 Added color coding of valve state, printed an error message when an attempt to open an already open DIO line is made, and fixed problem where the activate/deactivate button wouldn't always work on th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
2021-01-15 Removed unnecessary print statements associated with wx.MessageBox error notifications
2021-01-19 add simple-pid library to pipenv
2021-01-19 Added subpanel for control of VCS peristaltic pump
2021-01-21 Updated pump code to ensure that output voltage is set to 0 prior to closing the DIO channel; created basics of coordinating valve states for the valves corresponding to chemical sensors
2021-01-21 Chemical sensor valves are now designed such that only one can be opened at a time
2021-01-21 Fixed issue where pump panel didn't expand correctly to fit the screen like the valve panels do
2021-01-21 Add coordination panel that allows for cycling between open chemical sensor valves in order (HA->PV->IVC) in accordance with a specified time interval
2021-01-22 add test file for simple case of writing analog output to file
2021-01-25 Use ContSamps in CfgSampClkTiming so the USB repeats the same buffer. Remove attempts to push new buffer (not necessary in this mode) every sample. current code does not work with DC
2021-01-25 set output to 0V DC on before halting. This is to stop the motor if the app ends
2021-01-25 Refactor to use member thread instead of deriving from Thread class. This allows cleaner interaction with objects (open/close) and cleaning up resources on exit
2021-01-25 when frame closed, make sure panels are closed which in turns explicitly closes underlay AO objects. Without this, the frame close hangs due to the underlying threads
2021-01-25 When adjusting DC voltage, ensure that a max accel is maintained to prevent the motor from stalling
2021-01-25 remove debug print statement
2021-01-26 check if hardware clocking of AO is supported, if not, do not try to set ramp on DC voltage change
2021-01-26 refactor so thread is member instead of deriving class from Thread. This allows cleaner closing and exiting of the thread
2021-01-27 properly shut down SensorStream and AI objects when demo_ai app closes Refactor AI classes to thread is member for better handling
2021-02-01 Updated DAQ routing; AO for HA and PV BVP pumps moved to a new DAQ (USB-6211; Dev3); VCS peristaltic pump was rigged up for AO via Dev1/AO1
2021-02-02 use WriteAnalogF64 always to avoid error when trying to use WriteAnalogScalarF64 with USB-6211 add some debug print statements
2021-02-02 Created testing file for integration of valve switching with chemical sensors
2021-02-03 Added skeleton of code for coordinating valve switching with output of chemical sensors
2021-02-03 On halt, check for valid thread before trying to set dc to 0. If there is no valid_thread, the object was already closed and the output can't be changed.
2021-02-03 check for an alive thread before joining (can't join a thread which wasn't started)
2021-02-03 update simple test_ao app to test for some recent bugs (open/close, setting voltage to current value, waiting for task to complete)
2021-02-04 check if thread is alive before joining
2021-02-04 updates for new SensorStream/AI handling
2021-02-04 create sensor in test frame, catch evt_close and safely shutdown
2021-02-10 Messages are no longer printed to the command window when syringe parameters are changed; this speeds up the infusions in pyPerfusion/panel_Syringe
    [PHDserial.py]
2021-02-10 Syringe will infuse a user-defined volume upon request; I am using a timer here, so manual manipulation of the syringes using the panel is unavailable during these specific infusions
2021-02-10 Created skeleton code for app for testing integration of syringes with pressure/flow sensors
2021-02-10 Added syringe panels to test app
2021-02-10 add ch parameter to SensorStream so it knows which channel to access update test_stream app to test
2021-02-10 specify line in open() of SensorStream, not init
2021-02-10 update to panel_AI for new API use set_ch_id in SensorStream to set line so it can be more easily changed later
2021-02-11 BUGFIX: update slicing of multi-channel buffer to reflect proper grouping (all data from channel, next channel) instead of interleaved
    [pyAI_NIDAQ.py]
2021-02-11 Update demo_ai to reflect new AI/SensorStream API to support multiple channels
2021-02-11 Added functionality for two point calibration
2021-02-11 Edited out more unnecessary polling states so that opening/configuration of syringes in test_vasoactive_syringe.py occurs faster
2021-02-11 Integrated pressure sensor calibration into panel; also added syringe pump control, and added base code for initiating injections based on pressure conditions
2021-02-11 Added '\r' to string sent by set_syringe_manufacturer_size method to prevent the next query to the syringe pump from being invalid
    [PHDserial.py]
2021-02-11 Removed unnecessary print statement during voltage-to-unit conversion to avoid cluttering of command line
    [pyAI.py]
2021-02-11 Updated code such that syringes successfully initiate injections when the pressure is above or below a threshold
2021-02-12 in demo_ai, force all panel_AI to use one device which is chosen on startup.
2021-02-12 add sensors with fixed names for the flows and pressures
2021-02-12 Updated code such that the calibration readings and actual pressure readings during a run are separated
2021-02-12 Added methods for more efficient configuration and resetting of syringes
2021-02-12 Syringe target and infusion volumes are only reset when the syringe infused during the previous timer instance
2021-02-12 Added self.reset property to init method; is called during test_vasoactive_syringe
    [PHDserial.py]
2021-02-17 fix error message when can't open AI channel
    [pyAI_NIDAQ.py]
2021-02-17 update demo/demo_monitor1 to support new pyAI/SensorStream APIs
2021-02-17 Removed incomplete panel for testing VCS sensors; changes will be made to pyPerfusion/panel_VCS first prior to downstream testing
2021-02-17 update all test scripts and demo's for new pyAI/SensorStream API
2021-02-17 add basic panel for setting PID configuration
2021-02-17 panel_VCS now calls panel_AO for its pump subpanel; made small changes to panel_AO to condense the panel, set AO pump to 0 V upon opening, and set initial choices for offset and peak to peak voltages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
2021-02-17 add support for PID in test_maintain_flow (UNTESTED)
2021-02-17 Added "name" parameter to __init__ method of PanelDIO, added save and load buttons to panel, made it such that activate/deactivate button is unavailable until the DIO line is opened, made sure DIO li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
2021-02-17 Cleaned up "update_chemical_valves" method; added method for closing all chemical valves; simplified UI for coordination panel
2021-02-17 Load config button is deactivated when a DIO channel is opened
2021-02-18 Made slight changes to code after testing against VCS hardware; added method for closing the last open valve during valve switching
2021-02-18 Manual opening/closing of valves no longer relies on creating and updating a list of open valves (via open_glucose_valves and open_chemical_valves); code now queries the hardware directly to identify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
2021-02-18 Valve switching methods now query the hardware directly to look for open valves
2021-02-19 Added commented code which prevents the code attempting to reopen an unspecified channel of the DAQ which occurs when all AI channels are closed
    [pyAI.py]
2021-02-22 Convert voltages to units if a calibration has been performed
2021-02-22 If an ai channel is opened, calibrated, and then closed, upon reopening the previous calibration settings are retained; also removed unnecessary print statement which confirmed voltage -> unit conver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
2021-02-22 Added calibration functionality onto panel_AI
2021-02-22 Removed pyPerfusion/panel_calibration, as the calibration functionality was added to panel_AI instead
2021-02-22 Base code for running pressure controlled perfusions
2021-02-22 Finished basic code for running pressure controlled perfusions
2021-02-23 Make devname public the underlaying hardware configuration can be displayed by code using the class fix conflicts due to rebase
    [pyAI_NIDAQ.py]
2021-02-23 Added plots of IVC pressure and HA/PV flow onto panel
2021-02-23 Hepatic artery pump now outputs sinusoidal signals instead of DC ones
2021-02-23 Changed dev/line combinations for hardware to match HA pump/flow sensor in system; started sensor correctly so that the analog input is plotted as desired
2021-02-25 Made small modifications to code for setting flow
2021-02-26 Added new file for plotting outputs of the chemical sensors
2021-03-01 Added panel for plotting output of chemical sensors
2021-03-01 Removed panel for plotting chemical sensors, as I integrated this functionality into pyPerfusion/panel_VCS instead
2021-03-01 Added functionality for plotting chemical sensors outputs
2021-03-02 Added basic functionality for initiating valve switches passed on AI from chemical sensors
2021-03-02 Added method for returning the last 'x' sensor readings
2021-03-02 Added code that prevents an attempt to open an AI channel when all channels have been closed
    [pyAI.py]
2021-03-02 Completed integration of chemical sensors with VCS; tested successfully with system
2021-03-03 Made it such that receiver must be disconnected at the end of a sensor run
2021-03-03 Added code in add_Dexcom from PanelPlotting for plotting glucagon/insulin injection events and "end of sensor run" events
2021-03-03 Moved ResetSyringe and syringe_configuration methods from test app to underlying hardware app (PHDserial)
    [PHDserial.py]
2021-03-06 Reconfigured file for compatibility with SensorStream; the Dexcom() class serves as the hardware component in SensorStream
2021-03-06 Reconfigured file for compatibilty with SensorStream; code now uses PanelPlotting class, rather than overwriting some of its functionality with a child class (PlottingDexcom); made each subpanel be t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
2021-03-07 Added file detailing tubing information for the system
2021-03-07 Added images of tubing configuration for each of the five main circuits in the system
2021-03-08 Finished updating tubing documentation
2021-03-08 Created subfolder for housing all schematic information
2021-03-08 Updated the way in which the latest glucose value/time pair is returned so as to be compatible with SensorStream
2021-03-10 Created separate file for streaming data from a Dexcom sensor, rather than reusing SensorStream
2021-03-10 Replaced SensorStream with DexcomStream; removed unnecessary setting of channel_id for DexcomStream
2021-03-10 Added functionality for panel_plotting to plot in a different manner if type(sensor) is DexcomStream
2021-03-10 Updated code so that PanelPlotLT is compatible with sensors of type DexcomStream
2021-03-11 Prevented SensorStream from attempting to access more data from the receiver after a sensor session ends
2021-03-11 When a sensor session ends, DexcomStream thread is stopped
2021-03-11 Main plot only shows last hour's worth of data; updated code to handle the end of a sensor run
2021-03-17 Created syringe_timer code for centralized timer control of syringes; moved methods for resetting and configuring syringe to PHDserial
    [PHDserial.py]
2021-03-17 Updated test_vasoactive_syringe to call its syringe functionality via pyPerfusion/syringe_timer
2021-03-18 Added "parent" parameter in init method so that class can be called correctly; added print statements for confirmation of code functionality
2021-03-18 Added "self" in calls to SyringeTimer() class to ensure proper functionality
2021-03-18 Indent on elif statement was off, so normally unreachable code was executing and causing errors
    [panel_plotting.py]
2021-03-19 Updated code so that syringe injections can be stopped/started again if desired
2021-03-19 Upon calling the SyringeTimer class, the timer for checking injections is not initiated; this has instead been implemented in a separate method that is called outside the class; added appropriate con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
2021-03-19 Added commas back into code where they had inadvertently been removed; their absence was causing errors
    [panel_plotting.py]
2021-03-19 Removed comma from line of code in section of code that executes when sensor type = DexcomStream; was causing errors
    [panel_plotting.py]
2021-03-19 Changed plot_frame_ms for Dexcom plot so that the sampling period for data acquisition from the receiver can be increased to 5 minutes as needed; added button for starting/stopping syringe injections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
2021-03-22 Renamed DexcomStream to DexcomPoint and had it assume the functionality / data format of SensorPoint, rather than SensorStream
2021-03-22 When the sensor throws an error, it returns '0.1' as the glucose concentration, rather than 0, as returning 0 was causing errors with downstream code in DexcomPoint failing to execute
2021-03-22 Added code for stopping DexcomPoint object once glucose sensor session has ended
2021-03-25 Removed wx from syringe_timer and replaced it with timer functionality from threading
2021-03-25 add basic logging to pyHardware classes...converts existing prints to logging function but does not add new logging
2021-03-25 add basic logging to pyPerfusion classes...converts existing print statements to logging, but does not add more
2021-03-25 Changed the way in which threads are created/destroyed to ensure proper functionality of code; works with the system
2021-03-29 Added new data format for storing injection data from syringe pumps
2021-03-29 Added basic functionality for logging data about syringe injections into data files
2021-03-29 Created SyringeTimer objects outside of PanelVasoactiveSyringeTesting and passed them in as arguments so that syringe streams can be properly closed upon panel closure
2021-03-29 BUGFIX: fix improper config import
    [panel_plotting.py]
2021-03-29 add exception handling for instance of DAQ disconnect from USB and hibernation. Only print messages once
2021-03-29 Updated syringe names to correspond with new machine configuration
2021-03-29 Added method for getting COM/baud pairs for each syringe
2021-03-29 Hardcoded in COM/baud pairs for each syringe such that each syringe has its own dedicated subpanel; update code for compatibility with changes to underlying hardware code (PHDserial())
2021-03-29 Changed bytes per timestamp back to 4 instead of 8, as the amount of datapoints per timestamp doesn't actually affect this; changed how "chunk" is handled in the while loop to prevent an error when h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
    [PHDserial.py]
2021-03-29 Syringe stream is opened upon loading in a config
2021-03-29 Code now manages infusion rate string properly for PHDserial() to handle; added appropriate LP_CFG functionality for syringe streaming
2021-03-29 Syringe stream is properly stopped upon panel closure
2021-04-06 Commented out code that prints latest sensor readings every time a new valve is opened
2021-04-06 Changed initial conditions for desired pressure choices
2021-04-15 Integrated functionality in syringe_timer for stopping/starting basal infusions before/after bolus injections are given
2021-04-15 Removed unnecessary comments/print statements used during testing
2021-04-15 Removed unnecessary "start" button; made small changes in OnStartStop to make sure the proper methods/properties in parent/child classes are being referenced
2021-04-15 Removed syringe_configuration method, as I've stopped arbitrarily setting syringe size/type
2021-04-15 Added code to handle the case where syringe injections are stopped in the middle of the delivery of a bolus injection
2021-04-15 Updated file to reflect data logging in the case where a bolus injection is interrupted before it can be completed
2021-04-19 on sine wave output, check that device support feature, if not, print error to log
2021-04-19 catch SamplesNoLongerAvailableError exception and restart the task to clear the error
    [pyAI_NIDAQ.py]
2021-04-19 record time of each acq and, after recovery from failure to acquire samples (possibly due to sleep mode), print current time and last time so user can find out how much data was missed
    [pyAI_NIDAQ.py]
2021-04-20 Added new button for initiating basal injections independent of bolus injections; cleaned up appearance of UI and removed some unnecessary buttons
2021-04-20 Changed "if" statements in infuse and stop to properly handle exceptions; did a type conversion to prevent handling strings as integers
    [PHDserial.py]
2021-04-20 Added second peristaltic pump to control panel
2021-04-20 Centrifugal pump speed is altered every three seconds rather than every one second; added code to prevent setting pump voltage out of allowable range (0-5 V)
    [panel_pressure_controlled_perfusion.py]
2021-04-21 Fixed syntax errors associated with logging
    [panel_AO.py, panel_plotting.py]
2021-04-21 on device open, catch more appropriate DevCannotBeAccessedError exception and stop printing full exception. add is_open() function to check for open device In panel_AI, check if device was successful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
2021-04-21 add exceptions handling for AO missing device or bad line number
2021-04-21 if OnOpen fails, make sure button state retains unpressed state
    [panel_AO.py]
2021-04-21 add custom AODeviceException to pass on certain DAQ error messages so the GUI can display useful error message without needing to know the underlying DAQmx errors
    [panel_AO.py]
2021-04-22 add custom exception to handle AI device opening/configuration errors catch more specific errors are return clear messages to user
    [panel_AI.py, pyAI.py, pyAI_NIDAQ.py]
2021-04-22 in add_channel, need to reopen device as code that add channels to an existing opened device expects the device to be re-opened implicitly with the newly added channel
2021-04-22 add exception handling for device access in pyDIO
2021-04-23 refactor main acq loop to take into account time to acquire samples. This eliminate small time drifts that cause longer delays in acquisition over time
    [pyAI.py]
2021-04-23 update SensorStream loop to eliminate time drifts cleanup pyAI_NIDAQ
    [pyAI_NIDAQ.py]
2021-04-26 create acq buffer on start to avoid creating a new buffer every acq
    [pyAI.py, pyAI_NIDAQ.py]
2021-04-26 BUGFIX: fix bug in devname when creating thread name
    [pyAI.py]
2021-05-03 Added readout panels for displaying latest chemical sensor values
2021-05-03 Created sensors dedicated to each chemical sensed and each circuit (HA/PV/IVC); changed size of readout panels
2021-05-03 Tested functionality for initiating basal injections, stopping these injections to deliver bolus injections based on flow conditions, and then restarting these basal injections; stopping the cycle of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
2021-05-04 Tested functionality for stopping flow-informed bolus injections
2021-05-06 Updated UI to include readouts of each circuits' most recent chemical sensor readings; also eliminated plots
2021-05-06 Added code for initiating basal, bolus, or condition-informed bolus syringe injections on main perfusion panel
2021-05-06 If perfusion-condition informed injections are not supported for a syringe, a message is printed
2021-05-06 Is a syringe is infusing, it is stopped upon panel closure
2021-05-07 fix devname naming in creating thread name for is_open, check if any lines added, if not, consider it closed
    [pyAI.py]
2021-05-07 check valid device names on open() NIDAQ is_open should also check for a valid device names add new test script which requires valid hardware
2021-05-07 better checking for device open, refactor adding channel and open for cleaner code and error handling
    [panel_AI.py, pyAI_NIDAQ.py]
2021-05-07 fixes to channel handling of pyAI and pyA_NIDAQ to prevent errors. Hardware must be explicitly started after adding channels update test_stream to new usage
    [pyAI.py, pyAI_NIDAQ.py]
2021-05-07 if no channel added, return devname with device id (eg. Dev1) more descrption message if device rejected as valid device
2021-05-10 explicitly check for empty Device as an empty string is in all strings fix code so exceptions are raised properly to calling code
    [pyAI_NIDAQ.py]
2021-05-12 load config for DIO lines automatically add exception handling in case configuration missing for for some lines or device not available use global timeout for clearance timer
2021-05-12 add new class for finite sample acq update base classes to remove certain assumptions test script to test new class
2021-05-12 add new class to handle the switching of the VCS
2021-05-13 For finite acq, samples specificed at creation otherwise data file needs to support varying number of samples. There shouldn't be a need to change samples requested for a given channel. Add fixes to 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
    [pyAI.py, pyAI_Finite_NIDAQ.py, pyAI_NIDAQ.py]
2021-05-13 reset acq_complete flag on starting test acq of second group of samples
    [pyAI_Finite_NIDAQ.py]
2021-05-13 test script to test finite acq of samples test script to test reading of multi-sample sensorpoint
2021-05-13 print out full file
2021-05-14 bug fixes to get sensors working add test_vcs script
    [pyAI_Finite_NIDAQ.py]
2021-05-17 Increased wait times between checking for syringe injections; increased cooldown time for injections
2021-05-17 Changed method for stopping sensors upon valve switching so as to not constantly close and reopen DAQ channels
2021-05-19 fix bug in setting border
    [panel_AI.py]
2021-05-20 add notify functionality for better updating of readouts create new class to group sensors for given circuit location
2021-05-20 clean up GUI fix bugs in notify setup
    [pyAI_Finite_NIDAQ.py]
2021-05-20 update to reflect that the sensors share the same hardware AI which should only be started once Only one notify per group needed, PanelReadoutGroup will call individual readouts add slop to acq timeo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
    [pyAI_Finite_NIDAQ.py, pyAI_NIDAQ.py]
2021-05-21 add code to more cleanly handle the VCS pump
2021-05-21 add pump active/inactive feedback
2021-06-08 Commented out syringe injections for updating at a later point; removed HA glucose sensor
2021-06-15 SolidWorks model of bottom portion of the Liver Perfusion Chamber
    -Models only the portion of the chamber that holds the blood while running
    -Does not include tubes for fluid/blood flow
    [Blood_Portion_of_Liver_Perfusion_Chamber.SLDPRT]
2021-06-15 SolidWorks model of Octagonal Stir Bar
    -Stir bar with octagonal cross section created using measurements taken of the stir bar in use in lab
    -Stir bar has been used for perfusion runs up to 15 June 2021
    [Octagonal_Stir_Bar.SLDPRT]
2021-06-17 Remove old models used for compression system. Keep only files required for liver support Due to large divergence from legacy/compression/narrow-nopillar branch and current LiverPerfusion branch, I d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
    [Air Fill Bleed.SLDPRT, Air Filter Mount.SLDPRT, Air Filter.SLDPRT, Air Regulator.SLDPRT, BladderAndSupport.SLDASM, BladderAssembly.SLDASM, BladderBacking.sldprt, BladderBase.sldprt]
2021-06-17 Adjust overall size to 5x5 and fix all broken mates/relationships.
    [BladderAssembly.SLDASM, BladderBase.sldprt, BladderSheet.sldprt, BladderWindow.sldprt, Diaphragm_O-Ring.SLDPRT]
2021-06-22 Removed unnecessary setting of folder in SyringeTimer
2021-06-22 Syringe class is created separately from SyringeTimer; SyringeTimer is now only for condition-informed bolus infusions; modified allowable values/increments on spin controls; changed 2222 and 1111 to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
2021-06-22 Replaced print with logging
    [PHDserial.py]
2021-06-22 Added buttons for changing the bolus injection volume and time between checks for boluses during condition-informed syringe injections
2021-06-22 Updated code to only deal with syringe timing, not syringe configuration; updated names of timers to more accurately reflect their function; consolidated "check_for_injection" method; updated how the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
2021-06-22 Updated errors where an unnecessary "syringe" was present
2021-06-22 Added functionality for manually updating cooldown time during condition-informed syringe injections
2021-06-22 Fixed syntax error which was causing basal infusions to go unrecognized by the SyringeTimer code
2021-06-22 Removed buttons for changing thread timers mid-run
2021-06-23 Cleaned up init method for SyringeTimer; removed unnecessary while loop in OnCooldownLoop; reduced amount of polling of syringes during bolus infusions
2021-06-23 Updated calling of SyringeTimer to reflect changes to its init method
2021-06-23 Updated UI such that entire syringe panel fits on the screen
2021-06-23 Integrated syringe functionality in Dexcom panel
2021-06-23 Changed label for generalize code to all syringes
2021-06-23 Fixed if statement clauses to make sure syringes are being properly shunted into their specified code
2021-06-23 Added buttons for updating tolerance and threshold values mid-run
2021-06-24 Changed UI such that button always reads "activate" after opening/closing the line (during open/close, the valve is always shut off, so it will always be "activatable" after this action)
2021-06-25 Added button for opening/closing glucose valves
2021-06-25 Automatically shut off all independent valves when they are created; ensures that all valves are shut off prior to manipulation, in the case where one channel is active prior to running the code
2021-06-28 SolidWorks model of Upper Water Jacket -Water jacket sits on the very top of the entire device, directly above the spacer
    [Upper_Water_Jacket.SLDPRT]
2021-06-28 SolidWorks model of Spacer -Sits between the Upper Water Jacket and Reservoir/Lower Chamber
    [Spacer.SLDPRT]
2021-06-28 SolidWorks dimensions method update for Spacer and Upper Water Jacket -Modified dimensions in Spacer and Upper Water Jacket to refer to global variables instead of directly using numerical dimensions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
    [Spacer.SLDPRT, Upper_Water_Jacket.SLDPRT]
2021-06-28 SolidWorks model of Metal Plate -Model of Metal Plate with holes that rests on extrusions in Reservoir -Liver rests on Metal Plate -Modifications made to "Standard_Dimensions.txt" to include variable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
    [Metal_Plate.SLDPRT]
2021-06-28 SolidWorks model of Reservoir -Previous model was "Blood_Portion_of_Liver_Perfusion_Chamber.SLDPRT" and modeled only the lower part of the Reservoir that held the blood -Renamed "Blood_Portion_of_Liv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
    [Blood_Portion_of_Liver_Perfusion_Chamber.SLDPRT, Reservoir.SLDPRT]
2021-06-28 SolidWorks Liver Perfusion Chamber Assembly -Assembly of Reservoir, Metal Plate, Spacer, and Upper Water Jacket -Does not include tubing
    [Liver_Perfusion_Chamber_Assembly.SLDASM, Metal_Plate.SLDPRT, Reservoir.SLDPRT, Spacer.SLDPRT, Upper_Water_Jacket.SLDPRT]
2021-06-28 SolidWorks Liver Perfusion Chamber Assembly with Tubing -Created blackbox for area tubing occupies -Added Tubing Blackbox to Liver Perfusion Chamber Assembly -Linked "Standard_Dimensions.txt" to asse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
    [Liver_Perfusion_Chamber_Assembly.SLDASM, Metal_Plate.SLDPRT, Reservoir.SLDPRT, Spacer.SLDPRT, Tubing_Blackbox.SLDPRT, Upper_Water_Jacket.SLDPRT]
2021-06-30 SolidWorks Reservoir Feature Name Update -Modified feature names in "Reservoir.SLDPRT" to make it more clear which SolidWorks features correspond to which physical features
    [Liver_Perfusion_Chamber_Assembly.SLDASM, Reservoir.SLDPRT]
2021-06-30 Prevented pump from stopping completely while sensor readings are taking place; turn off pump briefly during valve switching
2021-06-30 SolidWorks Lower Water Jacket added to Reservoir Model -Added Lower Water Jacket model to "Reservoir.SLDPRT" -Updated "Standard_Dimensions.txt" with dimensions from Lower Water Jacket -Updated assemb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
    [Liver_Perfusion_Chamber_Assembly.SLDASM, Metal_Plate.SLDPRT, Reservoir.SLDPRT, Spacer.SLDPRT, Tubing_Blackbox.SLDPRT, Upper_Water_Jacket.SLDPRT]
2021-07-01 Add mm units to the equations file (unlink file, update equations, link file)
    [Liver_Perfusion_Chamber_Assembly.SLDASM, Metal_Plate.SLDPRT, Reservoir.SLDPRT, Spacer.SLDPRT, Tubing_Blackbox.SLDPRT, Upper_Water_Jacket.SLDPRT]
2021-07-02 remove direct saving to file from SensorStream and use strategy Support multiple strategies
2021-07-06 fix import in SensorStream add tests for sensor with strategy
2021-07-07 fixes for support of multiple plots and proper legend
    [plotting.py]
2021-07-07 fix support for specifying color
    [plotting.py]
2021-07-07 fix and test valid_ranges
    [plotting.py]
2021-07-07 update readouts to show with legend to avoid overlap when multiple plots are used
    [plotting.py]
2021-07-13 update SensorPoint so it doesn't collect regularly. It would typically only work with FiniteAcq . Update test script to use FiniteAcq
2021-07-14 allow option to keep old title when adding new strategies to keep event names from overriding the underlying sensor
2021-07-15 don't print message inn filter_legend_messages
2021-07-16 Spacer Peg Addition -Added the pegs that hold the spacer onto the reservoir and prevent the spacer from sliding
    [Spacer.SLDPRT]
2021-07-16 Standard_Dimensions.txt fix -Corrected Standard_Dimensions.txt to include all dimensions in assembly after some were mistakenly deleted in commit 23bda03
2021-07-19 SolidWorks addition of pegs to Upper Water Jacket -Added the pegs that hold the Upper Water Jacket onto the Spacer while the chamber is assembled
    [Spacer.SLDPRT, Upper_Water_Jacket.SLDPRT]
2021-07-19 Initial SolidWorks part for custom in-house spacer -Developed the initial design for the custom spacer to be fabricated in-house for use with rods to suspent the liver via hammock. -This initial mode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
    [CustomSpacer.SLDPRT]
2021-07-19 Added custom spacer to SolidWorks assembly -Added custom spacer design to assembly as new configuration
    [CustomSpacer.SLDPRT, Liver_Perfusion_Chamber_Assembly.SLDASM, Metal_Plate.SLDPRT, Reservoir.SLDPRT, Spacer.SLDPRT, Tubing_Blackbox.SLDPRT, Upper_Water_Jacket.SLDPRT]
2021-07-22 Custom Spacer Assembly -Created a SolidWorks part for each individual component of the custom spacer to be manufactured or purchased -Created an assembly of the custom spacer from individual componen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
    [89325K911_CORROSION-RESISTANT 316316L STAINLESS STEEL ROD.SLDPRT, 91292A114_TYPE 18-8 SS SOCKET HEAD CAP SCREW.SLDPRT, 91292A346_18-8 Stainless Steel Socket Head Screw.SLDPRT, CustomSpacer.SLDPRT, CustomSpacerLengthWall.SLDPRT, CustomSpacerWidthWall.SLDPRT, CustomSpacer_Assembly.SLDASM, FabricationCube.SLDPRT]
2021-07-22 Custom spacer SolidWorks assembly standoff addition -Created SolidWorks model of standoff SH1000-G (Davies Molding) -Added standoffs to custom spacer assembly as pegs to keep custom spacer from slidi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
    [CustomSpacerLengthWall.SLDPRT, CustomSpacerWidthWall.SLDPRT, CustomSpacer_Assembly.SLDASM, FabricationCube.SLDPRT, SH1000-G_Standoff.SLDPRT]
2021-07-22 Liver Perfusion Chamber Assembly updated with Custom Spacer Assembly -Added assembly version of custom spacer to the full liver perfusion chamber assembly
    [CustomSpacerLengthWall.SLDPRT, CustomSpacerWidthWall.SLDPRT, CustomSpacer_Assembly.SLDASM, FabricationCube.SLDPRT, Liver_Perfusion_Chamber_Assembly.SLDASM, Metal_Plate.SLDPRT, Reservoir.SLDPRT, Spacer.SLDPRT]
2021-07-23 Updated code so that the PV pump speed can be set based on flow condition, rather than pressure
2021-07-23 Automatically load in device configurations and calibrations for AI sensors
2021-07-23 Automatically load in device configurations for pumps; for dialysis pumps, a flow rate (rather than a voltage) is choosen
2021-07-26 Detail Drawings for Custom Spacer Components -Created SolidWorks detail drawings for components of custom spacer to be manufactured
    [CustomSpacer.SLDPRT, CustomSpacer_Assembly.SLDASM, Tubing_Blackbox.SLDPRT]
2021-07-26 Updated device names for liver system
2021-07-26 Updated initialization of IVC pressure sensor with new code; same with getting latest pressure readings from HA and PV pressure sensors
2021-07-26 Updated how "check_for_injection()" method gets latest sensor value based on newest code
2021-07-26 Added code for proper opening of flow sensors based on latest code
2021-07-27 Detail Drawings for Custom Spacer Components Correction -Detail drawings added to git after accidentally being excluded from commit 05fe11b
    [CustomSpacer_AssemblyDrawing.SLDDRW]
2021-08-20 Temporarily adding old SensorStream code, now called DexcomStream, to branch so that panel_Dexcom code still works
2021-08-20 Changed names of imported files accordingly to reflect change of names for SensorStream -> DexcomStream, panel_plotting -> plotting_Dexcom
2021-08-24 Updated correct file paths in code
    [utils.py]
2021-08-25 Changed names of 'RMS' strategies so that they are not the same; was causing problems with trying to plot RMS data
    [panel_AI.py]
2021-08-26 Updated calibration of sensor such that it now works properly
2021-08-26 Added functionality for updating HA pump voltage based on RMS values
2021-08-26 Updated panel_AI so that calibration of the DAQ can always be performed correctly
    [panel_AI.py]
2021-08-26 Updated syringe_timer so that bolus injection loop was correctly accessing the latest flow/pressure data point
2021-08-26 Updated how syringe waits during a bolus injection before resetting; is now the same as the methodology used in syringe_timer
2021-08-26 Added functionality for plotting data from Dexcom Sensors
2021-08-26 Updated code to properly handle retrieving data from Dexcom sensors
2021-08-30 Added base functionality for updating values in code by using a button, instead of constantly sampling a spin selector
    Please enter the commit message for your changes. Lines starting
2021-08-30 Further updates for integration of update buttons rather than continuous monitoring of spin controllers
2021-08-30 Changed how divisor button is disabled for the PV line
2021-09-01 Updated code so that the arterial sine wave is always bounded by the voltage limits of the centrifugal pump
2021-09-07 add a hammock designed to be laser cut from silicon rubber A "curved" version was built but unsure how to flatten it out for laser cutting
    [2633T11_HIGH-TEMPERATURE SILICONE RUBBER SHEET.SLDPRT, CustomSpacerLengthWall.SLDPRT, CustomSpacerWidthWall.SLDPRT, CustomSpacer_Assembly.SLDASM, FabricationCube.SLDPRT, Hammock.SLDPRT, Hammock_curved.SLDPRT, Liver_Perfusion_Chamber_Assembly.SLDASM]
2021-09-08 add simple board for PWM modulation of DC motor using power transistor
    [Driver.SchDoc, PumpDriver.PcbDoc, PumpDriver.PrjPcb, PumpDriver.SCHLIB, PumpDriver.SchDoc]
2021-09-15 Use 12" sheet size to match in-stock parts
    [Hammock.SLDPRT]
2021-09-15 change bottom polygon to solid for proper GERBER file creation (otherwise LPKF etches a hatched copper pour)
    [PumpDriver.PcbDoc, PumpDriver.PrjPcb]
2021-09-20 add optics posts to model, adjust hammock to match post layout
    [CustomSpacerLengthWall.SLDPRT, CustomSpacerWidthWall.SLDPRT, CustomSpacer_Assembly.SLDASM, FabricationCube.SLDPRT, Hammock.SLDPRT, Liver_Perfusion_Chamber_Assembly.SLDASM, Metal_Plate.SLDPRT, OpticsPost.SLDPRT]
2021-09-20 re-export board outline, adjust export options for LPKF
    [PumpDriver.PcbDoc, PumpDriver.PrjPcb]
2021-09-20 changed hammock for a "X" shape for better control over stretching. Unknow why other parts were modified.
    [CustomSpacerLengthWall.SLDPRT, CustomSpacerWidthWall.SLDPRT, CustomSpacer_Assembly.SLDASM, FabricationCube.SLDPRT, Hammock.SLDPRT, Liver_Perfusion_Chamber_Assembly.SLDASM, Metal_Plate.SLDPRT, Reservoir.SLDPRT]
2021-09-21 update board size to fit Bud CU-3003-A enclosure change 10ohm resistor from SMD to through-hole
    [Driver.SchDoc, PumpDriver.PcbDoc, PumpDriver.SchDoc]
2021-09-21 board updates to clean up DRC messages
    [PumpDriver.PcbDoc, PumpDriver.SchDoc]
2021-09-21 update hammock to be slightly smaller than raw sheet size for alignment in laser cutter
    [CustomSpacer_Assembly.SLDASM, Hammock.SLDPRT, Liver_Perfusion_Chamber_Assembly.SLDASM]
2021-09-23 enlarge annular rings around components and increase clearance between copper pours and traces/vias/etc
    [PumpDriver.PcbDoc, PumpDriver.PrjPcb]
2021-09-23 enlarge 4-40 screw holes and via hole sizes
    [PumpDriver.PcbDoc, PumpDriver.PrjPcb]
2021-09-30 add configs adding more material to 3 sides
    [Hammock.SLDPRT]
2021-10-05 correct length of PCB variable (should be 117mm)
    [StepperMotorControlBoardCover.SLDPRT]
2022-01-11 inital model of hammock drain using annular magnets
    [2518N131_Twist-Release Paired Magnets.SLDPRT, magnet_based_drain.SLDPRT, small_tubing_barb.SLDPRT]
2022-01-11 add config for just the holder to provide a grip for the matching magnet
    [magnet_based_drain.SLDPRT]
2022-01-11 add fillets
    [magnet_based_drain.SLDPRT]
2022-01-14 add unit testing for pymqtt correct errors discovered during unit testing
    [pyMQTT.py]
2022-01-14 fix bug introduced during merge conflict add .join when canceling subscriber to make sure channel cancel finished before closing connection
    [pyMQTT.py]
2022-01-18 reduce thickness of holder-only config to maximize drainage within hammock
    [magnet_based_drain.SLDPRT]
2022-01-20 fix bad relations
    [BladderAssembly.SLDASM, BladderBase.sldprt, BladderSheet.sldprt, BladderWindow.sldprt, Diaphragm_O-Ring.SLDPRT]
2022-01-20 add 8x6 configuration to match original size
    [BladderAssembly.SLDASM, BladderBase.sldprt, BladderSheet.sldprt, BladderWindow.sldprt, Diaphragm_O-Ring.SLDPRT]
2022-01-28 Add config for larger diameter tubing, fix some bad relations and fillets as needed
    [magnet_based_drain.SLDPRT]
2022-03-16 Added threading functionality to continously stream data from CDI instrument
2022-03-16 Successfully streaming data from instrument and printing on command line; need to ensure writing to file is correct though
2022-03-17 Updated get_latest() method to successfully return latest sample from monitor in string format
2022-03-18 Fix 5x5 ID o-ring (had been defaulted to all config) change 8x6 to current 8x5 size
    [BladderAssembly.SLDASM, BladderBase.sldprt, BladderSheet.sldprt, BladderWindow.sldprt, Diaphragm_O-Ring.SLDPRT]
2022-03-21 Adjust base thickness to 4.5mm to match existing base Adjust thickness of windows to 1/8 to match existing window and provide more sturdiness
    [BladderAssembly.SLDASM, BladderBase.sldprt, BladderSheet.sldprt, BladderWindow.sldprt, Diaphragm_O-Ring.SLDPRT]
2022-03-23 Updated TSM hardware code so that timestamps (in milliseconds from start) format are stored during data streaming
2022-03-23 Updated data formats file to reflect storage of timestamps in milliseconds from start with TSM data
2022-04-01 add config to close all 4 sides to better capture blood
    [Hammock.SLDPRT]
2022-04-01 remove 2 innermost holes...unused and allows blood to leak
    [Hammock.SLDPRT]
2022-04-04 Add 2in of excess to all sides to help better capture blood.
    [Hammock.SLDPRT]
2022-04-06 rename LiverCompression to LiverSupport to better reflect usage
    [BladderAssembly.SLDASM, BladderBase.sldprt, BladderSheet.sldprt, BladderWindow.sldprt, Diaphragm_O-Ring.SLDPRT]
2022-04-06 add configuration for black wall, rod support, cannulus cutout and cannulus holes
    [CustomSpacerLengthWall.SLDPRT]
2022-04-07 add config for WidthWall for rod support, remove rod cutouts from base wall
    [CustomSpacerLengthWall.SLDPRT, CustomSpacerWidthWall.SLDPRT, CustomSpacer_Assembly.SLDASM, FabricationCube.SLDPRT]
2022-04-07 add cannula large cutout and hole configs for width wall
    [CustomSpacerWidthWall.SLDPRT]
2022-04-07 update main assembly to show 2 new wall configs
    [CustomSpacerLengthWall.SLDPRT, CustomSpacerWidthWall.SLDPRT, CustomSpacer_Assembly.SLDASM, FabricationCube.SLDPRT]
2022-04-07 change wall thickness to 0.25
    [CustomSpacerLengthWall.SLDPRT, CustomSpacerWidthWall.SLDPRT, CustomSpacer_Assembly.SLDASM, FabricationCube.SLDPRT]
2022-04-21 fix rod mates on bottom spacer add second spacer to main assembly and configure for 3 blank walls and cannula cutout
    [CustomSpacerLengthWall.SLDPRT, CustomSpacerWidthWall.SLDPRT, CustomSpacer_Assembly.SLDASM, FabricationCube.SLDPRT, Hammock.SLDPRT, Liver_Perfusion_Chamber_Assembly.SLDASM, Metal_Plate.SLDPRT, Reservoir.SLDPRT]
2022-04-21 add new config to standoffs to support 30mm length to avoid collision between 2 spacers Update main assembly to use 30mm spacers in second spacer
    [CustomSpacer_Assembly.SLDASM, Liver_Perfusion_Chamber_Assembly.SLDASM, SH1000-G_Standoff.SLDPRT]
2022-04-21 fix mate for upper water jacket
    [CustomSpacerLengthWall.SLDPRT, CustomSpacer_Assembly.SLDASM, FabricationCube.SLDPRT, Liver_Perfusion_Chamber_Assembly.SLDASM, Metal_Plate.SLDPRT, Reservoir.SLDPRT, Tubing_Blackbox.SLDPRT, Upper_Water_Jacket.SLDPRT]
2022-04-21 remove unused spacer part delete unused spacer parts from main assembly remove unused tubing_blackbox from main assembly
    [Liver_Perfusion_Chamber_Assembly.SLDASM, Spacer.SLDPRT, Tubing_Blackbox.SLDPRT]
2022-04-21 add screws to fab cubes for supporting hammock Remove posts
    [CustomSpacerLengthWall.SLDPRT, CustomSpacer_Assembly.SLDASM, FabricationCube.SLDPRT, Liver_Perfusion_Chamber_Assembly.SLDASM, Metal_Plate.SLDPRT, Reservoir.SLDPRT, Upper_Water_Jacket.SLDPRT]
2022-04-22 Rearranged code so that total mixer flow is changed before percentage values
2022-04-22 Fixed syntax error in sample description
2022-04-25 Created new method for updating gas mix, with its timer separated from that of updating the readouts / plots; also, automatically stop gas mixer upon closing window
2022-04-25 Updated code such that values are only graphed if new values are being produced (i.e. the cuvette and shunt sensor are working)
2022-04-25 Got lt plots to start plotting; before, they were not associated with a sensor object
2022-04-29 Removed flow-thru sensor integration with VCS hardware code; in the future, code that calls this hardware code will handle sensor set up / synchronization
2022-04-29 I previously removed the integration of sensors w/pyHardware.pyVCS, so I did the same thing here; removed all readout panels, changed valve names to reflect updated needs, and removed code initializi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
2022-05-02 Fixed valve cycling by properly cancelling timers once they call their methods; properly stop timers upon cycle stop; added break in _cleared_perfusate() method required to prevent rapid fire cycling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
2022-05-02 Integrated independent glucose valves with Dexcom code such that the valves corresponding to each Dexcom sensor are opened or closed when the sensors are activated / deactivated
2022-05-03 Simplified hardware class for Dexcom Sensor; removed unnecessary references to SensorStream class, simplified thread which acquires data from the Dexcom receiver, and updated txt. file header describ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
2022-05-03 Updated get_data() and init() methods to get rid of extraneous features (buffer length, sampling period, etc.); get_data() also now only returns a glucose value or "None" rather than any strings corr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
2022-05-03 Added plotting methods from feature/gas_mixer_saturation_monitor branch to current branch; plotting of Dexcom data will be accomplished similarly to plotting of CDI data, so these added methods will 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
2022-05-03 Changed hardware class to ensure compatibility w/panel_Dexcom code; "sensor" is now "receiver", COM is no longer passed to the object, and unit is now passed
2022-05-04 Added mechanism for transmitting sensor error messages from receiver to panel_Dexcom via the "get_latest()" method
2022-05-04 Added mechanism for transmitting relevant sensor errors to pyDexcom code
2022-05-04 Updated panel_Dexcom; added readout panel for latest glucose value, updated plotting style, and added functionality to change plot frame length
2022-05-04 Changed timer in pyDexcom now that testing is complete; removed indexing of glucose records now that testing is complete
2022-05-04 Updated method names (and color of plotted datapoints based on valid_range) in plotting.py in accordance with changes made in fixes/dexcom_updates branch; updated names in pyPerfusion/panel_gb100_sat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
    [plotting.py]
2022-05-04 VCS pump is now stopped upon panel closure
2022-05-04 Original timestamp in txt format in now in milliseconds rather than seconds
2022-05-04 Updated data formats file to reflect storage of time in milliseconds from start format being written to txt file for format 3
2022-05-05 add WallLength variable to CustomSpacerWidthWall and set to InternalWidth WallLength will allow configuration for width and length wall in one part
    [CustomSpacerLengthWall.SLDPRT, CustomSpacerWidthWall.SLDPRT, CustomSpacer_Assembly.SLDASM, FabricationCube.SLDPRT]
2022-05-05 add long wall configuration to customspacerwidthwall remove longwall part from customspacer assembly and use widthwall with longwall config
    [CustomSpacerWidthWall.SLDPRT, CustomSpacer_Assembly.SLDASM, FabricationCube.SLDPRT]
2022-05-05 Hardcode internal width and length as that is a fixed parameter
    [CustomSpacerWidthWall.SLDPRT, CustomSpacer_Assembly.SLDASM, FabricationCube.SLDPRT]
2022-05-05 Started to configure syringes from config to lessen the amount of hard coding; particularly, syringe manufacturer and size are automatically loaded in as opposed to being chosen by the user
2022-05-05 add config for array of rod support holes to long wall
    [CustomSpacerWidthWall.SLDPRT, CustomSpacer_Assembly.SLDASM]
2022-05-05 rename customspacerwidth wall to jsut CustomSpacerWall as configurations handle short vs long wall Remove CustomSpacerLengthWall
    [CustomSpacerLengthWall.SLDPRT, CustomSpacerWall.SLDPRT, CustomSpacerWidthWall.SLDPRT, CustomSpacer_Assembly.SLDASM, CustomSpacer_AssemblyDrawing.SLDDRW]
2022-05-05 fix main assembly, create spacer assembly configs
    [CustomSpacerWall.SLDPRT, CustomSpacer_Assembly.SLDASM, FabricationCube.SLDPRT, Liver_Perfusion_Chamber_Assembly.SLDASM, Metal_Plate.SLDPRT, Reservoir.SLDPRT, Upper_Water_Jacket.SLDPRT]
2022-05-05 add hammock for blood collection
    [2633T11_HIGH-TEMPERATURE SILICONE RUBBER SHEET.SLDPRT, CustomSpacerWall.SLDPRT, CustomSpacer_Assembly.SLDASM, FabricationCube.SLDPRT, Hammock.SLDPRT, Liver_Perfusion_Chamber_Assembly.SLDASM, Metal_Plate.SLDPRT, Reservoir.SLDPRT]
2022-05-05 add drainage holes to hammock
    [Hammock.SLDPRT]
2022-05-06 Updated syringe panel; changed PanelTestVasoactiveSryinge panel name to reflect that any syringe type (not just vasoactive syringes) can be passed to the class; loading in relevant syringe values via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
2022-05-07 Set syringe manufacturer and size upon panel creation as opposed to on injection initiation; made sure all relevant buttons are turned off / on when injections are started / stopped
2022-05-07 Removed syringe label; properly set panel_feedback sizer so that it now properly appears on the main panel
2022-05-07 Spaced out elements on panels better; removed "Basal Infusion Rate" label; moved button for toggling basal infusions active/inactive to panel_feedback and removed any dependency of main panelSyringe 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
2022-05-07 Updated hardware code and data formats file to reflect that syringe injection data is now being stored in uL
2022-05-07 Updated syringe timer code; the class will always be passed a sensor now, so removed an unnecessary if statement; removed unnecessary value checks for insulin/glucagon as Dexcom hardware code has bee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
2022-05-07 Made logger messages in syringe_timer more clear; infused volume is now properly expressed in uL in the injection() method in syringe_timer; updated name of "Start Feedback Injections" button to more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
2022-05-07 Fixed bug in syringe_timer where upon restarting basal infusion after a bolus, the infusion rate was set to a number too high to be registered by the syringe hardware; reset self.wait in syringe_time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
2022-05-07 Renamed stop_stream() to close_stream() in PHDserial; added additional code to properly shut off all syringes upon panel closure
2022-05-09 Updated PanelFeedbackSyringe to pass its btn_start_feedback_injections to syringe_timer; in this way, syringe_timer can disable this button during active feedback-informed bolus injections such that 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
2022-05-09 Removed last_ms and samples_needed arguments from get_data()
2022-05-09 Updated OnClose() method so that syringes are properly shut off upon panel closure
2022-05-09 Prevented code from double-logging syringe_timer messages
2022-05-10 Added "enable_buttons" method in PanelSyringe; updated PanelFeedbackSyringe code to reflect desired functionality: vasoactive syringes will not have bolus injections; instead, their injection rates w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
2022-05-10 update config to small clamp 5x5
    [BladderAssembly.SLDASM, BladderBase.sldprt, BladderSheet.sldprt, BladderWindow.sldprt, Diaphragm_O-Ring.SLDPRT]
2022-05-13 Altered how the gas mix is changed; many times, methods for get_working_status() and set_working_status either ON or OFF were not reliable (i.e. get status reflected the incorrect mixer status, and s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
    [pyGB100.py]
2022-05-13 Changed valid range for O2 sat; added print messages for debugging; changed update_plots() method so that numerical (rather than string) values are plotted
2022-05-16 Data time is now returned in milliseconds rather than seconds
2022-05-20 Now that configuration of CDI sensors has been established (they will NOT be integrated w/the VCS; they will only read venous values), I updated labels of graphs accordingly, and also explained what 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
2022-05-20 Created new Python file for integrating arterial gas mixer w/Presens flow-thru pO2 sensor
2022-05-20 Deleted presens file; decided that it will be simpler to integrated Presens sensor into existing GB100/Saturation Monitor panel
2022-05-21 Made initial changes for adding Presens pO2 sensor and arterial gas mixer to panel;
2022-05-21 Continued updating panel for integration of presens pO2 sensor and arterial gas mixer; added _add_lt_presens() method, updated choice time methods to properly work for both CDI and Presens graphed da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
2022-05-22 Added line in pyHardware/PHDserial to track data logging
2022-05-22 Added functionality for keeping buttons inactive until a bolus injection has been completed
2022-05-22 Added functionality for communicating a maximum allowable bolus injection volume / infusion rate to syringe_timer
2022-05-22 Updated syringe_timer; glucagon syringe now has only bolus injections, vasoactives are basal only, and insulin injections support both (added check_for_basal_insulin_change() and insulin_injection() 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
2022-05-24 create frame to support drainage hammock add drainage_hammock to main assembly and mate with drain
    [2633T11_HIGH-TEMPERATURE SILICONE RUBBER SHEET.SLDPRT, CustomSpacerWall.SLDPRT, CustomSpacer_Assembly.SLDASM, FabricationCube.SLDPRT, Hammock.SLDPRT, Hammock_drainage_frame.SLDPRT, Liver_Perfusion_Chamber_Assembly.SLDASM, Metal_Plate.SLDPRT]
2022-06-20 Changed 'injectionrate' name to 'inject' in config file to reflect that some syringes are bolusing while some are injecting continuously; removed button to update intervention magnitude during syring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
2022-06-21 Added incrementation button in panel_Syringe for specifying scalar by which infusion rate/ bolus infusion volume is increased during feedback-controlled infusion; addded thread which, if the desired 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
2022-06-21 Changed code at end of check_for_change() method; if just reducing magnitude of insulin/glucagon boluses, no injection at that time is needed; cooldown timer is not started when reducing infusion rat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
2022-06-21 Updated panel_pressure_controlled_perfusion_syringes for compatibility with new syringe code
2022-06-21 Updated pyPerfusion/panel_Dexcom code for compatibility with new syringe code
2022-06-21 Updated DAQ routing file for updated system configuration; moved VCS peristaltic pump to dialysis such that there are pumps on both the dialysate inflow and outflow; pH and CO2 sensors are no longer 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
2022-06-21 Removed self._lgr and renamed self._sensor to self.sensor to fix errors; graphs ranges for the CDI and presens pO2 sensor are now loaded in from a file rather than hard-coded in
2022-06-22 Made a large number of changes; replaced AI_Finite_NIDAQ /SensorPoint/PointsToFile with NIDAQ_AI / SensorStream/StreamToFile; added validrange to the SensorStream sensor; removed presens_label and pr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
2022-06-22 Added functionality for automating dialysate inflow/outflow rates based on Hct readings from the CDI; pumps start at designated flow rate in config file; inflow rate increases if K is out of range, w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
2022-06-23 Created new pyHardware file for recording data relating to automation of dialysate inflow/outflow pumps
2022-06-23 Added code for logging data relating to automation of dialysate inflow and outflow flow rates through pyHardware/pyDialysatePumps
2022-06-23 Restored original file location for read_binary_file and added method for reading data from pressure/flow sensors (AI - data version 1)
2022-06-23 Deleted print statement now that streaming has been confirmed to be occurring successfully
2022-06-23 Updated streaming of data from dialysate pump automation to include working status of the pumps; modified pyHardware/pyDialysatePumps, post_perfusion_processing/read_binary_file, and Data Formats fil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
2022-06-23 Added spacers to reduce panel clutter; updated streaming of dialysate automation data to reflect updates to pyHardware/pyDialysatePumps (working status of the pumps is now included in the stream)
2022-06-23 Shortened rod supporter cutouts by 3mm so there is not a complete hole in wall for heat loss - kept a ~3mm interior notch for rods to rest on
    [CustomSpacerWall.SLDPRT]
2022-06-24 Replaced thread for reducing interventions with a Timer(); replaced self.change with self.increase and removed self.increment; added conditions for checking if self.increase and self.reduce are true 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
2022-06-24 Loaded in desired/tolerance/increment/divisor from config file; updated code for determining whether to add divisor functionality to the panel based on HA vs. PV control; NIDAQ_AO() object is now cre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
2022-06-25 For PanelPressureFlowControl, I added the corresponding sensor (e.g. HA Flow for HA Pressure, PV Pressure for PV Flow, etc.); if a potential increase in centrifugal pump speed is required, but the up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
2022-06-25 Removed source of redundant logging; updated label titles; set self.reduce in syringe_timer object to False prior to initiating feedback injections; upon stopping feedback injections, all syringes ar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
2022-06-25 self.reduction time is now loaded in from config (in Panel_Syringe) rather than hard-coded in syringe_timer; removed print messages added for debugging; moved location of setting self.reduce to False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
2022-06-26 Added code for handling glucose value from Dexcom sensor
2022-06-26 Added initial code for reading syringe data
2022-06-26 In get_data() method, time is returned in millisecond rather than seconds
2022-06-26 Added code for processing and graphing glucose data from Dexcom sensor
2022-06-26 Added print messages for debugging; set self.old_glucose = new_glucose after forgetting to do so previously; removed time.sleep and replaced reset_target_volume() with ResetSyringe() in bolus infusio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
2022-06-27 made the depth of the notches 1/2 the total thickness of the wall -- titled "front" to be used in assembly as a separate part rather than re-mating all of the components
    [CustomSpacerWall_front.SLDPRT]
2022-06-27 assembly using new notched peices, mainly just for visualization since we just need two prints of the modified wall
    [91292A346_18-8 Stainless Steel Socket Head Screw.SLDPRT, CustomSpacerWall.SLDPRT, FabricationCube.SLDPRT, NoHolesCustomSpacer_Assembly.SLDASM, SH1000-G_Standoff.SLDPRT]
2022-06-27 For bolus injections, changed how the code checks to see if infused volume >= target volume, as with some target volumes (e.g. 1001 uL), slightly less than the target volume (1000.99999 uL) is actual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
2022-06-27 Made final updates to syringe_timer; reset self.old_glucose upon stopping main thread; removed print messages used for debugging; modified case where self.reduce is true for insulin syringe so that i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
2022-06-27 All calls to syringe_timer create self.old_glucose so that no errors are created upon panel_Syringe panel closure
2022-06-27 Changed some increments from 1 to 0.1; added comment regarding basal insulin infusion rate buttons; set insulin_change to false prior to starting feedback injections; added TPN/Bile Salts and Heparin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
2022-06-27 Removed print message used for debugging
2022-06-27 reworked some of the files so my edits are different configurations instead of separate files
    [CustomSpacerWall.SLDPRT, CustomSpacerWall_front - Copy.SLDPRT, NoHolesCustomSpacer_Assembly.SLDASM, blankCustomSpacerWall_front.SLDPRT]
2022-06-27 Changed sensor from IVC to PV Dexcom sensor
2022-06-28 initial designs for sliding diaphragm mechanism -- added slits to either side of short wall; aiming to slide rods up and down to control diaphragm height, more adjustable than holes
    [CustomSpacerWall.SLDPRT]
2022-06-28 changed slit width to match screw diameter(3.20 mm); could be possible to use fabrication cubes as tightening mechanisms to secure diaphragm at given height
    [CustomSpacerWall.SLDPRT]
2022-06-28 Finished code for plotting stored data about syringe infusion rate
2022-06-28 sizer for adding normal panel and feedback panel (if applicable) for each syringe is now a FlexGridSizer, allowing the panels to be closer together to save space; eliminated extraneous text on button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
2022-06-28 Added heparin and TPN/bile salt syringes to panel, added FlexGridsizers where appropriate to improve layout, slightly changed OnClose() method in accordance with changes to panel construction; sizer 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
2022-06-28 Made final updates to panel; strings loaded into config file are now converted to float; added if statements for adding functionality for self.divisor and self.upperlimit; corresponding sensor value 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
2022-06-29 Removed output txt file from syringe pump that is no longer relevant
2022-06-29 deleted extra copies of files now obsolete because of configuration edits
    [CustomSpacerWall_front - Copy.SLDPRT, CustomSpacerWall_front.SLDPRT, blankCustomSpacerWall_front.SLDPRT]
2022-06-29 Added additional call to self.Destroy() to ensure that panels are closed properly; stopped all timers upon panel closure
2022-06-29 Updated panel to eliminate hardcoding and instead load in pump info from config file
2022-06-29 Updated LiverPerfusion_ConceptLayout diagram according to current system set up; added additional comments in data formats file specifying which hardware component corresponds with which data format;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
2022-06-29 Added files relating to Rotaflow pumps, Permselect and Capiox oxygenators, CDI monitor, and Harvard Apparatus chamber redesign meeting
2022-07-05 Edited slit configuration to place slits 106 mm from each other (47 mm from side of short wall). This allows the slit method to work for both the small and big bladder, stabilized by two rods. Diamet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
    [CustomSpacerWall.SLDPRT]
2022-07-11 Rebuilt chamber with new slit design
    [2633T11_HIGH-TEMPERATURE SILICONE RUBBER SHEET.SLDPRT, 91292A114_TYPE 18-8 SS SOCKET HEAD CAP SCREW.SLDPRT, CustomSpacerWall.SLDPRT, CustomSpacer_Assembly.SLDASM, FabricationCube.SLDPRT, Hammock.SLDPRT, Hammock_drainage_frame.SLDPRT, Liver_Perfusion_Chamber_Assembly.SLDASM]
2022-07-12 added rod,cubes,and 7/8 thumbscrews to final assembly
    [91292A346_18-8 Stainless Steel Socket Head Screw.SLDPRT, 99607A219_Stainless Steel Flared-Collar Knurled-Head Thumb Screw.SLDPRT, CustomSpacerWall.SLDPRT, CustomSpacer_Assembly.SLDASM, FabricationCube.SLDPRT, Hammock_drainage_frame.SLDPRT, Liver_Perfusion_Chamber_Assembly.SLDASM, hollow 3-16 rod.SLDPRT]
2022-07-13 committing and pushing again to see if it works
    [CustomSpacer_Assembly.SLDASM, Liver_Perfusion_Chamber_Assembly.SLDASM]
2022-07-14 realized I added the wrong screws last time - this model shows the exact ones that we ordered!
    [99607A219_Stainless Steel Flared-Collar Knurled-Head Thumb Screw.SLDPRT, CustomSpacerWall.SLDPRT, CustomSpacer_Assembly.SLDASM]
2022-07-14 new cannula file, full cannula with olive tip (pretty much just a test run)
    [CustomSpacer_Assembly.SLDASM, Custom_Cannula_Olive.SLDPRT]
2022-07-20 test_ai updated to print data values. test_temperature_graphs updated to open and start device 2 and channel 0
2022-07-20 reordered opening of analog input device in test_temperature_graphs
2022-07-20 doubled height and tripled width of sensor base so that we can attach wound vacuum seal to better seal up glucose sensor
    [Glucose_Sensor_Adapter_Platform.SLDPRT]
2022-07-22 model for olive tip addition to cannulas, 0.75 inner diamter, 3 mm outer diamter -- need to change inner diamter once I know the right size
    [Custom_Cannula_Olive.SLDPRT, Glucose_Sensor_Adapter_Platform.SLDPRT, olive_tip_only.SLDPRT]
2022-07-22 final dimensions - tip length is slightly less than 10mm (semicircle sketch is 10 mm but cut off by extrude-cut of inner circle), inner diamter 1.1 mm (fits 1.05 cannula), outer diamter 3 mm
    [olive_tip_only.SLDPRT]
2022-07-22 renamed sections to make things easier to look at
    [olive_tip_only.SLDPRT]
2022-07-27 add config for a blank long wall
    [CustomSpacerWall.SLDPRT]
2022-08-02 got rid of zip tie holes so model is stronger for printing and more space for vacuum seal
    [CustomSpacer_Assembly.SLDASM, Glucose_Sensor_Adapter_Platform.SLDPRT, NoHolesCustomSpacer_Assembly.SLDASM]
2022-08-05 Restored to July 21 version with line added and altered p2p voltage
2022-08-05 Added dev 2 and line 0 for temp probe
2022-08-11 suppress the holes for strain relief
    [Glucose_Sensor_Adapter_Platform.SLDPRT]
2022-08-23 Updating temperature graph to use PanelAI
2022-08-23 Calibrator button functionality added to test_temperature_graphs
2022-08-24 Removed RMS strategy and changed p2p voltage input
2022-08-24 add variables for olive tip dimensions
    [olive_tip_only.SLDPRT]
2022-08-24 add config for smaller olive tip to better match cannula #19 adjust default config so ID matches cannula #19
    [olive_tip_only.SLDPRT]
2022-08-26 remove check for _task OnClose. _task is a protected variable and checking it directly should not be necessary. This seems to have led to instances where closing the panel would hang
2022-08-26 add UpdateUI event handler so the Open/Close button reflects actual state of device in OnClose, explicitly stop the underlying hardware
2022-08-26 remove hardcoding of device and line
2022-08-30 change device name for testing on JWK desktop replace hardcoded devicename in first test with global var DEVICE_UNDER_TEST
2022-08-30 remove check for live thread when getting data as this is not true for a finite acq
2022-08-30 add unit testing for sensorpoint and points2file add better log message in FileStrategy
2022-08-30 remove unneeded sensorpoint examples as replaced with unit testing remove overly complicated test_syringe example (redundant with panel_syringe) add unit test for reading from sensorpoint with Numpy
2022-08-30 remove unneeded mmap test files as replaced by unit testing or unused Perf file is of minimal usage in current state Using mmap through numpy is not possible due to certain numpy limitation regarding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
2022-09-06 add simple comment block replace self._logger with self._lgr for consistency with other classes
    [pyAI.py]
2022-09-07 rename ResetSyring to reset_syringe for consistency with coding style
    [PHDserial.py]
2022-09-20 remove pySerialPort as it is an unnecessary abstraction from the underlying serial object add serial function direct to Pump11Elite class, remove unused Protocol
2022-09-20 add pytest-mock library for mocking in unit tests add unit test for mocked Pump11Elite
2022-09-20 change data type in Pump11Elite to int32 as all data stored as integers add simple example file on recording actions with syringe using a Mock
2022-09-21 rename panel_Syringe as it did more than just provide the basic interface to a syringe
2022-09-21 add new simple syringe panel for basic config and control To pyPump11Elite: add is_infusing boolean, additional error checking, and util for listing avail com ports is_infusing boolean should be upda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
    [panel_syringe.py, pyPump11Elite.py]
2022-09-21 complete panel_syringe for basic config and control updates to pyPump11Elite to add mock for testing without hardware, minor bug fixes and additional logging
    [panel_syringe.py, pyPump11Elite.py]
2022-09-28 SyringeTimer functionality flowchart added
2022-10-18 BUGFIX: remove starting/stopping \r on syringe response
    [pyPump11Elite.py]
2022-10-18 move folder_management and PerfusionConfig from fixes/update_configuration_handling branch to this branch to separate out pyAI changes
    [PerfusionConfig.py, folder_management.py]
2022-10-19 improve config handling for syringe update handling of default manufacturer names and codes
2022-10-20 get pyAI refactored files from fixes/update_configuration_handling to better split out config refactor from pyAI refactor
    [panel_AI.py, pyAI.py, pyAI_Finite_NIDAQ.py, pyAI_NIDAQ.py]
2022-10-20 add SensorPoint/Stream and strategies from fixes/update_configuration_handling
2022-10-20 remove tight_layout call as it always fail
    [plotting.py]
2022-10-20 fixes to loading/saving config
    [PerfusionConfig.py, pyAI.py]
2022-10-20 checkout files from fixes/update_configuration_handling to separate out pyAO changes form other aspects
    [panel_AO.py]
2022-10-21 add pytests BUGFIX: fix creation of devname for NIDAQ hardware
    [pyAI_NIDAQ.py]
2022-11-02 Frameworks for CDI and gas mixer integration
2022-11-02 pySaturationMonitor includes data parsing for venous shunt sensor. pyCDI framework developer
2022-11-02 More framework in pyCDI
2022-11-02 Added John's suggested framework to ex_CDI.py
2022-11-02 Updated request_data in pyCDI and corrected typo in ex_CDI
    [pyCDI.py]
2022-11-02 Removed extraneous printing from ex_CDI
2022-11-02 Attempted to make pyCDI more efficient. Not sure if this correctly assigns class attributes (or how to fix)
    [pyCDI.py]
2022-11-02 Corrected function names to standard and made data acquisition more efficient in pyCDI
    [pyCDI.py]
2022-11-02 code to support read-only access and saving multi-var sensors (e.g., CDI)
2022-11-02 sensorpoint updates to support multivar inputs
2022-11-07 complete code to link sensorpoint with CDI. uses timestamp derived from start of acq instead of CDI timestamp to remain consistent with other code.
2022-11-08 fix missed merge conflicts
    [PerfusionConfig.py]
2022-11-09 Updated ex_GB100 to read gas flow values
2022-11-09 Updated ex_GB100 to change total flow, on/off status, and gas percentage
2022-11-10 Updated ex_GB100 for use in calibration testing
2022-11-21 bugfixes necessary to run code
    [PerfusionConfig.py, panel_syringe.py, pyPump11Elite.py]
2022-11-22 bug fixes to get system working
    [PHDserial.py, panel_AI.py, pyPump11Elite.py]
2022-11-22 bug fixes to properly handles bytes to string
    [pyCDI.py]
2022-11-22 add app for displaying flow/pressure sensors
2022-11-22 add Dev1.ini which handles current AI hardware config
2022-11-22 update panel_AI test to use actual sensor name
2022-11-30 Updated pyPump11Elite to allow SyringeConfig dataclass to accept comport, size, injection rate, etc. inputs
2022-11-30 Added all syringes to app_hardware_control.py. New syringe panel class created because panel_syringe isn't working in the large grid format. Not yet functional.
2022-12-01 add property to get buflen and datatype directly for AI channel. Needed so SensorPoint doesn't need to assume working with an AI channel with a device attribute
    [pyAI.py]
2022-12-01 update AIChannel to access device properties so sensorpoint and stream do not need to know about underlying device
2022-12-05 updates to fix code
    [panel_syringe.py, pyPump11Elite.py]
2022-12-06 Fix PointsToFile:retrieve_buffer to return only samples needed
2022-12-06 update CDI stream example for easier use add some error checking to pyCDI
    [pyCDI.py]
2022-12-06 move get_avail_com_ports to utils as it can be used by classes other than syringe
2022-12-06 Corrected OnBolus error messaging and deleted faulty data class
    [pyPump11Elite.py]
2022-12-12 FInished framework initialization for panel_DialysisPumps. Needs to be connected to hardware still
2022-12-12 Created framework for panel_SPCStockertPumps to add to app_hardware_control
2022-12-12 Added mock framework for sinusoidal pump control to panel_SPCStockertPump
2022-12-13 Created separate panel with all 6 syringes. Edited app_hardware_control to combine individual hardware panels
2022-12-13 Corrected sizer error for proper display in the individual hardware panels
    [panel_DialysisPumps.py]
2022-12-13 Added updated dialysis and centrifugal pump panels to app_hardware_control
2022-12-14 Added basic functionality to panel_gas_mixer.py. Panel not configured correctly so added features have not been tested.
    [panel_gas_mixers.py]
2022-12-16 Added config statement to ex_CDI_stream and panel_CDI but not opening correctly. Stopped printing in panel_CDI
    [pyCDI.py]
2022-12-16 Updated pyGB100_SL to reflect sO2 instead ofg pO2. Corrected additional error case
2022-12-19 add CDI sensor to app_sensors to save data only
2022-12-19 Updated syringe incrementing
2022-12-19 Corrected toggle buttons in panel_DialysisPumps and made skeleton functionality for dialysis pumps based on Allen's code
    [panel_DialysisPumps.py]
2022-12-19 total flow should be an int
2022-12-19 get CDI examples to work 9no more print_results, bad config name)
2022-12-20 create simplified Dexcom class to interact with SensorStream add default ini and example
2022-12-20 add example for interfacing dexcom to SensorPoint
2022-12-20 updates to get dexcom working (not completed, but can communicate with sensor)
2022-12-21 remove sine controls from panel_AO as no longer needed replace spin with slider
    [panel_AO.py]
2023-01-05 Inserted panel_AO into panel_DialysisPumps
2023-01-06 Dialysis panel can control all 3 dialysis pumps
2023-01-06 Fixed label to dialysis inflow
    [panel_DialysisPumps.py]
2023-01-11 Last nminute updates to run. Str to float converstion in panel_AI, updated syringe names/configs
2023-01-19 Changed panel_AO to spinCtrlDouble and added 4th pump
2023-01-19 Added Update Rate button to panel_AO for side circuit roller pumps
2023-01-20 panel_AO updated to accept init rates. Halfway complete currently
2023-01-23 fix plotting so title and axes labels are displayed properly
    [plotting.py]
2023-01-25 add moving average strategy and hardcode for PV/HA pressures and flows. will add to config later
2023-01-25 add moving average filter and add default for app sensors fix bug where streams didn't use strategy name in filename causing overwrites
    [plotting.py]
2023-01-26 replace pyAO with pyDC as current hardware only supports DC simply base classes (remove ramp/sine as unsupported anyway, remove channel support as it provides no benefit with DC output) Add integrati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
    [pyDC.py, pyDC_NIDAQ.py]
2023-02-07 Added in control of glucose circuit pump
2023-02-07 Debugging attempts for Save/Load Default buttons in panel_DialysisPumps. Not yet fixed
    [panel_AO.py]
2023-02-07 Tested ex_dc_stream_from_config with roller pump
2023-02-14 Updated panel_DialysisPumps to fit pyDC. Added feature to stop pumps
2023-02-14 removed redundancy in creating roller pump hardware configurations
2023-02-15 Added units to logger message in pyDC_NIDAQ. Initialized SensorStream in panel?DC and panel_DialysisPumps
2023-02-15 Made loop to initialize roller pumps
2023-02-15 add basic circuit for controlling color sensors
    [VEML6040A3OG.PcbLib, VEML6040A3OG.SchLib, color_sensors.SchDoc, reservoir_level_color.PcbDoc, reservoir_level_color.PrjPcb, reservoir_level_color.SchDoc]
2023-02-15 remove extra getLogger in __init__ move pump loop into __init__ and clean up code a bit pass only sensor to panel_DC as it contains hw and name of sensor
2023-02-15 BUGFIX: on close, call sensor.hw.stop not hw.stop
    [panel_DC.py]
2023-02-16 complete design and layout
    [reservoir_level_color.PcbDoc, reservoir_level_color.PrjPcb]
2023-02-16 Added target flows to panel_gas_mixers
2023-02-16 Fixed start/stop of gas mixer
    [panel_gas_mixers.py]
2023-02-16 Added time delays to keep has mixer on when making flow or percent changes in app
2023-02-16 add config handling to sensor stream
2023-02-17 basic idea for 2 sensor calculation...basic functionality works, but needs to be improved
2023-02-17 Added update rate btns for total flows and percent changes
2023-02-17 Added timer to check hardware for changes in a loop
2023-02-21 add helper function to get strategies from config check if flow and pressure have valid values before dividing
2023-02-21 remove Stream from FlowOverPressure classname to avoid confusion with Sensorstream
2023-02-21 Temporarily removed CDI inputs (SensorStream not ready) and deleted old timer
2023-02-21 UPdated GUI to take updates to flow, % mix before starting gas mixer
2023-02-21 Added timer as in plotting.py
2023-02-21 Removed timer after testing (failed), corrected button enabling
    [panel_gas_mixers.py]
2023-02-21 add calculated stream to calculate the total volume delivered based on the flow sensor
2023-02-21 fix length of calibration as it needs to be related to the buffer length
2023-02-21 uncomment timer code but comment out setting spin control values which is a conflicting action (setting based on hardware versus allowing user changes)
2023-02-22 restore Strategy class init parameters to original to prevent breakage. Full integration of config class will be done in a separate branch to allow initial testing of calculated streams
    [Strategies.py]
2023-02-22 Adjusted files to run with hardware. CDI not workign still
    [PerfusionConfig.py, panel_gas_mixers.py]
2023-02-22 Update to timer functionality. Work in progress
2023-02-22 Added two other functions to gas mixer timer
2023-02-22 Added stop to timers and increased time to 1 minute
2023-02-22 Changed timer to use wx.MessageBox instead of logger
2023-02-23 Minor fix to run CDI
    [panel_gas_mixers.py]
2023-03-02 add new sensor and reader/writer classes to clean up old sensorstream interface New classes allow for easier integration as old classes will still work
2023-03-02 fix bug where processing buffer created as array of float arrays instead of array of float minor code cleanups
    [Sensor.py, Strategy_Processing.py, Strategy_ReadWrite.py]
2023-03-06 change from deque to Queue as Queue is intended for multi-threading apps add sampling_period_ms to strategy config...required to get example ex_plot_sensor working, but not ideal
2023-03-07 update ReaderPoints to retrieve data from current elapsed time instead of last saved time keep track of last time in SYS_HW
2023-03-07 create a mockCDI class to help test reading multi-var sensors
2023-03-07 Aesthetic improvements to dialysis pump panel
2023-03-07 create mock syringe to test sensor interface with actuators recording data
2023-03-08 convert all timestamps to use time_ns for absolute time converted to integer milliseconds.
2023-03-08 Improved logic of update methods. Increased CDI timer length to 5 mins
2023-03-09 Draft code callign CDI hgb reading for automated dialysis pump control
2023-03-09 All gas mixer and roller pump hardware initializes and shuts down in app_hardware_control
2023-03-09 Closed out syringe hardware in app_hardware_control
2023-03-10 Moved auto dialysis button to its own subpanel with FlexGridSizer
2023-03-10 Call hardware outside of SyringePanel class
2023-03-10 Added additional wrappers and fixed automatic spacing in apps_hardware_control
    [panel_multiple_syringes.py]
2023-03-13 update code to autoload all syringes, add some additional checks and logs if hardware not loaded
2023-03-14 add pumps to SystemHardware and add example for pump control and reading
2023-03-14 remove obsolete examples and update examples for new Sensor/SYS_HW API
2023-03-14 Updated appearance of syringe panels
2023-03-14 change VolumeByFlow to a strategy instead of a dedicated class add get_writer to Sensor to gain access to the writer class...needed to reset VolumeByFlow strategy
    [Sensor.py, Strategies.py, Strategy_Processing.py]
2023-03-14 bugfixes and updates to volume by flow to integrate config
    [Sensor.py, Strategy_Processing.py, Strategy_ReadWrite.py]
2023-03-14 rename SensorChain to CalculatedSensor, add CalculatedSensorConfig to hold samples_per_calc
2023-03-14 move FlowOverPressure to a DivisionSensor, update example remove obsolete CalculateSensor
2023-03-14 update panels for new Sensor and SYS_HW API
2023-03-14 pass drug names as parameter to syringepanel so it can be more easily changed
2023-03-14 update code to use set_reader not set_strategy for calculatedsensor and divisionsensor set hw attribute to one of the underlying sensors as the readers need access to the sampling rate of the underly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
2023-03-14 update example config files, should match current hardware config
2023-03-14 if no serial port, return a default response of '0 0' to avoid parsing errors
    [pyPump11Elite.py]
2023-03-15 update code for latest Dexcom fixes
    [SystemHardware.py]
2023-03-17 add missing gas mixer config to hardware.ini
    [hardware.ini]
2023-03-17 fix bug when pushing real data to queue add logging messages
    [pyCDI.py]
2023-03-20 added config for smaller hammock
    [Alpan_3fold.SLDPRT, Hammock.SLDPRT]
2023-03-21 update pyCDI to provide an easy way to convert variable names to an index. process string response in a CDIStreaming method replace CDIParsedData with new CDIData as data will always be provided as a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
    [pyCDI.py]
2023-03-21 fix off-by-1 bug when calculating expected variables. update error messages
    [pyCDI.py]
2023-03-21 fix bug in handling of CDIData, add check for none
    [pyCDI.py]
2023-03-21 Debug added, SYSHW access corrected
    [pyCDI.py]
2023-03-21 fix bug in ReaderPoints. get_file_size returned samples instead of bytes as expected. On retrieve_buffer in ReaderStream uses the filesize in samples, so adjust in that method only.
    [Strategy_ReadWrite.py, pyCDI.py]
2023-03-22 panel_DC updated with SYS_HW and with sensor wrap
2023-03-22 panel_DialysisPumps updated to accept sensor wrapped panel_DCs
2023-03-22 Wrapped panel_syringe in sensor
2023-03-22 multiple_panel_syringes using sensor
2023-03-23 add sensor interface
2023-03-23 Added box that displays real pump value during automated dialysis
2023-03-23 add sensors and strategies config for gas mixers
2023-03-23 Added timer to check roller pumps for hardware updates
2023-03-23 fix bug in opening modbus, specific port not config
    [pyGB100.py]
2023-03-23 Hard coded roller pump offset of 0.03 V
2023-03-27 Updated HA Flow plottnig strategy
2023-03-27 Tried to fix hardware loading across the two apps
    [SystemHardware.py]
2023-03-27 fix bug in reporting error message (device instead of Device)
    [pyDC_NIDAQ.py]
2023-03-27 add check for missing hardware to prevent program crashes while testing without hardware
    [Sensor.py, Strategy_ReadWrite.py, panel_AI.py]
2023-03-27 fix bug in reading a register
    [pyGB100.py]
2023-03-27 Added CDI related methods to panel_gas_mixers, incorporated CDI sensor
2023-03-28 fix read_register api call
    [pyGB100.py]
2023-03-28 fix attempt to get gas name string based on value
    [pyGB100.py]
2023-03-28 Added read_config to CDI sensor loading
2023-03-28 Forced cdi sensor in as argument
2023-03-28 Fixed hardware loading in main_app - functional. Added equalities to gas mixer CDI methods
    [panel_gas_mixers.py]
2023-03-30 use cdi_reader only, do not start/stop CDI sensor in the panels
2023-03-30 fix bug in stopping AutoGasMixer disable auto checkbox if flow is not enabled, stop autogasmixer when flow stopped
    [panel_gas_mixers.py, pyAutoGasMixer.py]
2023-03-31 improve GUI interface in regards to enabling buttons and updating text controls ensure autogasmixer is started correctly, do not do anything if no CDI data
    [panel_gas_mixers.py, pyAutoGasMixer.py, pyGB100.py]
2023-03-31 fix loading of mocks for testing
    [SystemHardware.py, panel_gas_mixers.py, pyCDI.py]
2023-03-31 enable manual inputs based on auto check box only (allows changing values before enabling flow) shut down all hardware on testframe exit
2023-04-03 save commands (flow, mixes, status) as array for easier reading, provide index enum for references Add mock mixers to SystemHardware and integrate Sensors
2023-04-03 Updated CDI timer to 5 mins
2023-04-05 add additional error checking to avoid the loop failing during a long run
    [pyCDI.py]
2023-04-05 set serial timeout in open(), stop thread on close()
2023-04-05 fix bugs introduced by fixing conflicts in rebase/merge
    [pyAutoGasMixer.py, pyGB100.py]
2023-04-05 check for no CDI response, if so, in between valid data points, so don't consider that an error
    [pyCDI.py]
2023-04-06 fix bug after merge
    [panel_gas_mixers.py, pyCDI.py]
2023-04-10 fix bug in working_status helpers...didn't get value of enum, used enum directly
    [pyGB100.py]
2023-04-11 Deleted redundant BaseGasMixerPanel, fixed typos
    [panel_gas_mixers.py, pyAutoGasMixer.py]
2023-04-12 after init, update the controls to the current hardware values
2023-04-12 refactor pyAI for consistent class usage (config has no name, object has name), remove obsolete code, change ai_channels from dict to list as channels maintains name so avoid a key name different fro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
    [pyAI.py]
2023-04-12 fix bug in remove channel, add get_channel function for retrieving a channel by name updates to NIDAQ classes and pytests to match new changes
    [pyAI.py, pyAI_Finite_NIDAQ.py, pyAI_NIDAQ.py]
2023-04-12 remove obsolete pyAO update pyDC classes to new naming API, switch back to using Queue instead of dequeue
2023-04-12 add MASTER_HALT event to all threads to allow one event to shut down everything update thread while loops to use event.wait instead of sleeps as that should be more efficient
2023-04-12 refactor SystemHardware to use a map for easier handling of hardware fix config API issues with pyDC and pyPump11Elite
    [SystemHardware.py, pyDC.py, pyPump11Elite.py]
2023-04-12 update syringe for newer API, autoload mock if syringe hw not accessible
2023-04-12 redoing acrylic enclosure models
    [2633T11_HIGH-TEMPERATURE SILICONE RUBBER SHEET.SLDPRT, Alpan_3fold.SLDPRT, Autoclavechamber.SLDPRT, Bloodcollection_exittube.SLDPRT, Countertop.SLDPRT, CustomSpacerWall.SLDPRT, CustomSpacer_Assembly.SLDASM, Enclosure_top.SLDPRT]
2023-04-12 move syringes into hardware.ini, remove syringes.ini
2023-04-12 fix bug if when checking adjust values
    [pyAutoGasMixer.py]
2023-04-12 update some examples and panels to load a single hardware instance add more error checking to get_object
    [SystemHardware.py, panel_AI.py]
2023-04-13 restore missing imports in SystemHardware
    [SystemHardware.py]
2023-04-13 update NI device ini names
2023-04-13 fix bug in get_file_size, should return bytes, update name to avoid confusion
    [Strategy_ReadWrite.py]
2023-04-13 fix bug in converting string to dtype
    [pyCDI.py]
2023-04-13 update sensor and strategy to new naming convention add checks for sensor and strategy ini
2023-04-14 hardcode infusing state until pump responses can be tested more thoroughly
2023-04-17 update to fix handling of strategies.ini fix all discrepancies
    [Sensor.py, Strategy_ReadWrite.py, hardware.ini]
2023-04-17 add flow_limits to config, fix bug in ReaderPoints
    [Strategy_ReadWrite.py, pyGB100.py, utils.py]
2023-04-17 add automation for Dialysis pumps including cleanups to panels
2023-04-17 add calibration to convert between volts and flow for DC pumps
2023-04-17 add support for syringe automations
2023-04-17 update to abstract actuators...INCOMPLETE
2023-04-18 add sensors for actuators and remove actuators.ini. Will not abstract pumps as the it provides no benefit
2023-04-18 add PerfusionSystem class to manage sensors update apps/panel as needed
2023-04-18 add PerfusionSystem to panel_multiple_syringes, accept syringe_sensor directly
2023-04-18 update to use PerfusionSystem and fix bug where auto wasn't turned off on uncheck
    [panel_gas_mixers.py]
2023-04-18 fix some logging and properly setup and close hardware when running apps
    [PerfusionSystem.py, Sensor.py, SystemHardware.py, panel_syringe.py]
2023-04-19 autoload dc pump automations
2023-04-19 update panel syringe to handle automations
2023-04-19 add autoloading of syringe automations
2023-04-19 clean up datatype uses in pyPump11Elite add default target vol and rate for syringes
2023-04-19 eliminate type checking for Sensor
2023-04-19 add configs for calculated and division sensors, including cleanups to plotting (need to check if sensor has valid_range)
2023-04-19 remove tightlayout which doesn't work anyway
    [plotting.py]
2023-04-19 remove assumption that sensor has a hw component
2023-04-19 get volume by flow example running
2023-04-19 fix bug in ReadWrite in get_data_from_last_read where last read index was incorrect retrieve_buffer should return time in ms to be consistent with other retrieve methods in plotting, check if not dat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
    [Strategy_ReadWrite.py, plotting.py]
2023-04-19 add logging helpers to filter log messages add example to show how to filter
2023-04-20 Set flow button state based on hardware, fixes wrong button state issue when flow is changed
    [panel_gas_mixers.py]
2023-04-20 move read/write config from Sensor to PerfusionSystem and handle configs from there. Allow better control of config source and loading of objects
2023-04-28 Removed Start Auto button for syringes
2023-04-28 Added manual TPN and Zosyn syringes (under auto file for simplicity)
2023-04-28 Updated syringe panel font size
2023-04-28 Adding in initial values to syringe panel
2023-04-28 Tried to debug adding initial syringe values... did nto succeed
2023-04-28 remove old pump docs and add Levitronix docs
2023-04-28 initial class for PuraLev pump
2023-04-28 add simple example for Levitronix pump
2023-04-28 added flow control for PuraLev
2023-04-28 add mutex to prevent conflicts accessing modbus
    [pyPuraLevi30.py]
2023-04-28 working leviflow example, save flows as float64, ml/min
2023-04-28 fix bugs from merge
    [pyLeviFlow.py]
2023-04-28 code updates to communicate with Levitronix converter (have not tried with flow sensor attached)
2023-05-01 Syringe panel takes starting values from config
2023-05-01 Added automation buttons for glucose control and vasoactive substance control
2023-05-01 Added logging window, changed layout of syringe gui
2023-05-01 Altered syringe layout further
2023-05-02 redo enclosure acrylic
    [2633T11_HIGH-TEMPERATURE SILICONE RUBBER SHEET.SLDPRT, 89325K911_CORROSION-RESISTANT 316316L STAINLESS STEEL ROD.SLDPRT, 90107A011_316 Stainless Steel Washer.SLDPRT, 91292A114_18-8 Stainless Steel Socket Head Screw.SLDPRT, 91841A195_18-8 Stainless Steel Hex Nut.SLDPRT, 93865A570_Weld Studs.SLDPRT, 93865A590_Weld Studs.SLDPRT, 97481A115_Aluminum Flat Head Solid Rivets.SLDPRT]
2023-05-02 Fixed udate_config_from_controls for syringe pumps
    [panel_multiple_syringes.py, panel_syringe.py]
2023-05-02 Updating syringe initial values
2023-05-02 debugging dc pump errors
    [hardware.ini, panel_DC.py, pyDC.py, pyDC_NIDAQ.py]
2023-05-02 Updates to syringe configs
2023-05-02 updates to help debug why DC pumps don't work in Hernandez lab
2023-05-02 Updates to syringe logging
2023-05-02 add thread to read responses in the background
2023-05-02 add printing hexlify output of response for better mocks
2023-05-02 Re-ordered pump configs
2023-05-03 Updated sensors.ini to accurate syringe volumes
2023-05-03 New calibrations for each pump
2023-05-03 updates testing syringe non-blocking
2023-05-03 complete non-blocking calls...Pump11Elite does not always return something or returns a blank. Reduce serial timeout and always strip all \r and \n
2023-05-03 UPdated calibration - needs additional edits to work with timer
2023-05-03 weld fitting add in
    [Alpan_3fold.SLDasm.SLDPRT, Alpan_3foldasm.SLDASM, Lowerenclosure_Assembly.SLDASM, Upperenclosure_Asm.SLDASM, WF08MN.SLDPRT, magnet_based_drain.SLDPRT]
2023-05-03 add pyGeneric base class for hardware to handle common functions of all hardware update logging to add sensor name to hardware logger for easier parsing update wxTextCtrl logging to allow showing jus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
2023-05-03 minor code cleanups, fix all examples
    [PerfusionConfig.py, PerfusionSystem.py]
2023-05-03 handle case where sensor doesn't have any units
    [plotting.py]
2023-05-03 clean up some logging message, avoid duplicate messages when using wxTextCtrl handler
    [panel_DialysisPumps.py, pyAutoDialysis.py, pyDC.py, utils.py]
2023-05-04 add function codes to i30 pump class modbus read/writes
2023-05-04 Eliminated DC pump timer - cannot be updated manually
2023-05-04 Changes to dialysis calibration
2023-05-04 Eliminated methylpred syringe
2023-05-04 Calibration values are set inpyDC to Pump 3 values - works currently
2023-05-05 Corrected dialysis pump configs for calibration
    [hardware.ini]
2023-05-05 Final dialysis calibration fix
    [hardware.ini, panel_DC.py]
2023-05-08 add syringe response to error message when an error occurs trying to parse the response
    [pyPump11Elite.py]
2023-05-08 increase serial timeout to see if that resolves get_infusion_rate response being blank
    [pyPump11Elite.py]
2023-05-09 update syringe example to call more APIs to record responses in log
2023-05-09 check if serial port open before getting infuson rate to avoid issue with the stop() trying to record a continuous infusion stop on a closed port
    [pyPump11Elite.py]
2023-05-09 reset syringe serial timeout to 0.1s
    [panel_multiple_syringes.py, pyPump11Elite.py]
2023-05-09 check status of is_infusing after closing syringe
2023-05-09 remove propagate=False in create_wx_handler as that blocks regular logging Update panel_gas_mixers for correct names to prevent duplicate messages
    [panel_gas_mixers.py, pyPump11Elite.py, utils.py]
2023-05-09 don't enable flow when changing parameters unless it is already on
2023-05-09 properly close all panels and frames Use sensor_frame as parent to hardwareframe so sensor_frame can close it on exit
2023-05-10 code cleanup and better error checking return None when requesting data from syringe and the response is bad
    [panel_syringe.py, pyPump11Elite.py]
2023-05-11 strip cr from str2send to prevent overwriting line in log file tested raising uncaught exception to verify crashes
    [pyPump11Elite.py, utils.py]
2023-05-11 consistent use of super().__init__() all wxpython objects are saved to self (reaction to occasional exception thrown on Hernandez laptop about a deleted text control). Should ensure no object are del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
2023-05-11 improve log formatting, add color logs to terminal, add handlers to root only, filter by name in more efficient manner
2023-05-11 remove hardware check for syringe status to see if that is causing errors
    [pyPump11Elite.py]
2023-05-14 Fixed display of syringe and dialysis panel logging
    [panel_DialysisPumps.py, panel_multiple_syringes.py, panel_syringe.py]
2023-05-18 fitting for exit of pan
    [Alpan_3fold.SLDasm.SLDPRT, Alpan_3foldasm.SLDASM, Lowerenclosure_Assembly.SLDASM, Upperenclosure_Asm.SLDASM, WF06MN.SLDPRT, magnet_based_drain.SLDPRT]
2023-05-22 Added 1.5 V ceiling for dialysis pumps to limit flow
2023-05-22 Using timer in dialysis panels again
2023-05-22 Pressure range in epo/phenyl automation to stop injection at midpoint
2023-05-23 updates to get pump working
2023-05-23 updates for leviflow (not testing, wrong tubing port on sensor)
    [hardware.ini]
2023-05-23 Added algorithm to increase flow in event of low O2 in arterial gas mixer
2023-05-23 update automations.ini to use _min/_max values instead of _range to avoid issues saving to config add actions to update/save/load buttons
    [PerfusionConfig.py, PerfusionSystem.py, automations.ini, panel_DialysisPumps.py, pyAutoDialysis.py]
2023-05-23 shorten config button names reduce pH increment
    [panel_config.py, panel_gas_mixers.py]
2023-05-24 Revert "shorten config button names"
    This reverts commit 829561172631b7fc14698520aae191e1fd1b8799.
    [panel_config.py, panel_gas_mixers.py]
2023-05-24 Revert "add vaso automation"
    This reverts commit e4363121003b70a794605d88203e65b8ecf66525.
    [pyAutoSyringe.py]
2023-05-24 update configs for proper device addr
2023-05-24 Initial Levitronix app framework
2023-05-24 Levitronix gui, configs updated to control both pumps
2023-05-24 add code for CITSens glucose sensor
2023-05-24 basic code for reading from CITSens glucose sensor
2023-05-24 add classes and example for glucose sensor
2023-05-24 fix bug in reading of RawPoints
    [Strategy_ReadWrite.py]
2023-06-01 move automation config to buttons line remove <br> in log files so lines are more compact move logs and automation to basemixerpanel
2023-06-01 in log, search for sensor name, not hw name
2023-06-01 improvements to Dialysis Pump section
2023-06-01 redo syringe panel control for more compact layout
2023-06-01 show all syringes
2023-06-02 enable syringe buttons
2023-06-02 gui layout enhancements for syringe controls
2023-06-22 Deleted extra syringe debugging
2023-06-22 Fixed levitronix logging error
    [panel_levitronix_pumps.py]
2023-06-22 Removed flow view from levitronix panel
2023-06-29 made dialysis pump layout three across, more condensed
2023-06-29 shrunk autodialysis button
2023-06-30 Fixed sizing so stop button is visible
    [panel_DC.py]
2023-06-30 now when we stop flow in dialysis pumps the offset value goes back to zero
2023-07-21 BUGFIX: write_from_dataclass missing required parameter in several classes
    [PerfusionSystem.py, pyAI.py, pyAutoGasMixer.py, pyGeneric.py]
2023-07-21 BUGFIX: add missing lgr to BaseGasMixerPanel
    [panel_gas_mixers.py]
2023-07-21 add logging to PuraLev BUGFIX: fix Mocki30 so it derives from PuraLevi30
    [SystemHardware.py, panel_levitronix_pumps.py, pyPuraLevi30.py]
2023-07-26 BUGFIX: in arterial gas automation, if check for ph<min, and decrease CO2, ph>max, increase CO2
    [pyAutoGasMixer.py]
2023-08-09 convert start timestamp to milliseconds
2023-08-09 fix get_all for points sensor fix saving all points to columns for points sensor
    [Strategy_ReadWrite.py]
2023-08-10 move util functions to Strategy_ReadWrite, autocreate sensor based on output_type
2023-08-10 move bottom cubes up, resize for pan, add trap door and slits
    [91292A114_18-8 Stainless Steel Socket Head Screw.SLDPRT, 91292A114_TYPE 18-8 SS SOCKET HEAD CAP SCREW.SLDPRT, 93865A590_Weld Studs.SLDPRT, 99607A219_Stainless Steel Flared-Collar Knurled-Head Thumb Screw.SLDPRT, Alpan_3fold.SLDasm.SLDPRT, Alpan_3foldasm.SLDASM, Bloodcollection_exittube.SLDPRT, Countertop.SLDPRT]
2023-08-14 changed lower limit of gas flow from 5 to 0
2023-08-14 for an AI channel, use the device's acq_start_ms minor code cleanups
2023-08-14 Changed venous gas mixer automation to turn on or off depending on PO2 reading. Made "flow_cancel" and "flow_resume" functions (parallel purpose to flow_adjust)
2023-08-17 Revert "move bottom cubes up, resize for pan, add trap door and slits"
    This reverts commit a40000d1551bed223f33211a01530c05b4016acd.
    [91292A114_18-8 Stainless Steel Socket Head Screw.SLDPRT, 91292A114_TYPE 18-8 SS SOCKET HEAD CAP SCREW.SLDPRT, 93865A590_Weld Studs.SLDPRT, 99607A219_Stainless Steel Flared-Collar Knurled-Head Thumb Screw.SLDPRT, Alpan_3fold.SLDasm.SLDPRT, Alpan_3foldasm.SLDASM, Bloodcollection_exittube.SLDPRT, Countertop.SLDPRT]
2023-08-18 add sinusoidal output puralev device
2023-08-18 add automation class for controlling flow
2023-08-21 remove debug message to avoid clogging logs
    [pyCITSens.py]
2023-08-21 add examples to test sinusoidal output and pid
2023-08-21 override set_speed to avoid printing log message
    [pyPuraLevi30.py]
2023-08-21 add plots for flow and speed, other minor improvements
2023-08-21 save change to Puralev speed ensure controls are updated with correct tunings
    [PerfusionSystem.py, pyAutoFlow.py, pyPuraLevi30.py]
2023-08-22 pid returns relative change, convert to absolute value
2023-08-22 testing in the lab, get speed from motor
2023-08-23 copy files
    [1120A99_Water- and Weather-Resistant Rubber Push-on Seal.SLDPRT, 91292A114_18-8 Stainless Steel Socket Head Screw.SLDPRT, 91292A114_TYPE 18-8 SS SOCKET HEAD CAP SCREW.SLDPRT, 93865A590_Weld Studs.SLDPRT, 99607A219_Stainless Steel Flared-Collar Knurled-Head Thumb Screw.SLDPRT, Alpan_3fold.SLDasm.SLDPRT, Alpan_3foldasm.SLDASM, Bloodcollection_exittube.SLDPRT]
2023-08-23 if error loading a missing sensor/automation/etc., give more descriptive error message
    [PerfusionSystem.py]
2023-08-29 if no update rate for waveform given, set to 10x the sin freq, or stop the thread if DC.
2023-08-29 fix gui layout, link in config save/loading
    [panel_config.py, panel_levitronix_pumps.py, pyPuraLevi30.py, pyWaveformGen.py]
2023-08-29 Make upper enclosure smaller to fit pan
    [Upperenclosure_Asm.SLDASM, Upperenclosure_backwall.SLDPRT, Upperenclosure_frontwall.SLDPRT, Upperenclosure_sidewalls.SLDPRT]
2023-08-29 Create c clamp for holding acrylic to pan, update pan LxW, update acrylic LxW
    [90128A241_Zinc-Plated Alloy Steel Socket Head Screw.SLDPRT, 90128A245_Zinc-Plated Alloy Steel Socket Head Screw.SLDPRT, Alpan_3fold.SLDasm.SLDPRT, Alpan_3foldasm.SLDASM, Enclosure_top.SLDPRT, FabricationCube.SLDPRT, Lowerenclosure_Assembly.SLDASM, Lowerenclosure_backwall.SLDPRT]
2023-08-30 add slits to top enclosure, make dummy drawing for laser cutting
    [CUT_acrylic.SLDASM, Upperenclosure_Asm.SLDASM, Upperenclosure_sidewalls.SLDPRT, Upperenclosure_topwall.SLDPRT]
2023-08-31 update to gui so buttons reflect actual status of pumps and automation remove debug statements
2023-09-01 add vertical and horizontal tie bars and trap door
    [1586A22_Surface-Mount Hinge with Holes.SLDPRT, 90128A197_Zinc-Plated Alloy Steel Socket Head Screw.SLDPRT, 91841A009_18-8 Stainless Steel Hex Nut.SLDPRT, 92141A009_18-8 Stainless Steel Washer.SLDPRT, Enclosure_trapdoor.SLDPRT, Enclosure_trapdoor_lockin.SLDPRT, Enclosure_trapdoor_lockout.SLDPRT, FabricationCube.SLDPRT]
2023-09-05 fix c clamp mirror, replace trap door hinge with hinge from lab and hw from lab
    [Enclosure_trapdoor.SLDPRT, Enclosure_trapdoor_lockin.SLDPRT, FabricationCube.SLDPRT, Lowerenclosure_Assembly.SLDASM, Upperenclosure_Asm.SLDASM, Upperenclosure_frontwall.SLDPRT, Upperenclosure_sidewalls.SLDPRT, found_Surface-Mount Hinge with Holes.SLDPRT]
2023-09-06 update pan c clamp and trap door lock based on printed versions
    [91292A114_TYPE 18-8 SS SOCKET HEAD CAP SCREW.SLDPRT, Enclosure_trapdoor_lockin.SLDPRT, Enclosure_trapdoor_lockout.SLDPRT, Upperenclosure_Asm.SLDASM, panacryclic_clamp.SLDPRT, panacryclic_clamp_mir.SLDPRT]
2023-09-06 minor visual updates
    [Lowerenclosure_Assembly.SLDASM]
2023-09-07 new design for tubing platform and push down bracket
    [Tubing_platform.SLDPRT, Tubing_pushdownbracket.SLDPRT, Tubing_pushdownfoam.SLDPRT, Upperenclosure_Asm.SLDASM]
2023-09-12 update threading on pan drain adapter to make opening larger
    [magnet_based_drain.SLDPRT]
2023-09-14 add nut pockets to tie down bars, v and h, add trap door to top of chamber
    [Enclosure_trapdoor.SLDPRT, Enclosure_trapdoor_lockasm.SLDASM, FabricationCube.SLDPRT, Tiebar_horizontal.SLDPRT, Tiebar_vertical.SLDPRT, Upperenclosure_Asm.SLDASM, Upperenclosure_sidewalls.SLDPRT, Upperenclosure_topwall.SLDPRT]
2023-09-14 make tie bars v and h doubles
    [Lowerenclosure_Assembly.SLDASM, Metal_Plate.SLDPRT, Tiebar_vertical.SLDPRT, Upperenclosure_Asm.SLDASM]
2023-09-18 try different sizes for drain adapter and update side wall for double tie off bars
    [Enclosure_trapdoor.SLDPRT, FabricationCube.SLDPRT, Lowerenclosure_Assembly.SLDASM, Tiebar_horizontal.SLDPRT, Upperenclosure_Asm.SLDASM, Upperenclosure_sidewalls.SLDPRT, magnet_based_drain.SLDPRT]
2023-09-21 make tie down bar holes through holes for V and H and shorten shank length on lock
    [Enclosure_trapdoor_lockasm.SLDASM, Enclosure_trapdoor_lockin.SLDPRT, FabricationCube.SLDPRT, Tiebar_horizontal.SLDPRT, Tiebar_vertical.SLDPRT, Upperenclosure_Asm.SLDASM]
2023-09-21 drain dia update Please enter the commit message for your changes. Lines starting
    [magnet_based_drain.SLDPRT]
2023-09-26 update drain ID to 13.375
    [FabricationCube.SLDPRT, Lowerenclosure_Assembly.SLDASM, Metal_Plate.SLDPRT, Upperenclosure_Asm.SLDASM, magnet_based_drain.SLDPRT]
2023-09-26 Add holes for tie bars on tubing panel. Update to 08 drain and adapter
    [Alpan_3foldasm.SLDASM, Lowerenclosure_Assembly.SLDASM, Upperenclosure_Asm.SLDASM, Upperenclosure_backwall.SLDPRT, WF06MN.SLDPRT, WF08MN.SLDPRT, magnet_based_drain.SLDPRT]
2023-09-27 Make trap doors lay flat on outside, update lock
    [Enclosure_trapdoor.SLDPRT, Enclosure_trapdoor_lockasm.SLDASM, Enclosure_trapdoor_lockin.SLDPRT, Lowerenclosure_Assembly.SLDASM, Tubing_platform.SLDPRT, Upperenclosure_Asm.SLDASM, Upperenclosure_backwall.SLDPRT, Upperenclosure_sidewalls.SLDPRT]
2023-09-29 updated config files to fix error
    [hardware.ini]
2023-09-29 Platform for print
    [Enclosure_trapdoor_lockasm.SLDASM, FabricationCube.SLDPRT, Lowerenclosure_Assembly.SLDASM, Metal_Plate.SLDPRT, Tubing_platform.SLDPRT, Upperenclosure_Asm.SLDASM, Upperenclosure_sidewalls.SLDPRT]
2023-10-03 Add gaskets to trap doors and update lock
    [8510K22_trapdoor.SLDPRT, 8510K22_trapdoor_bot.SLDPRT, Enclosure_trapdoor.SLDPRT, Enclosure_trapdoor_lockasm.SLDASM, Enclosure_trapdoor_lockout.SLDPRT, FabricationCube.SLDPRT, Lowerenclosure_Assembly.SLDASM, Upperenclosure_Asm.SLDASM]
2023-10-03 add tubing diaphragm with metal mesh
    [3945T73_Quick-Install Plastic Clamping Hanger.SLDPRT, Diaphragmtube_discharge.SLDPRT, Diaphragmtube_dischargeinflate.SLDPRT, Hammock.SLDPRT, Lowerenclosure_Assembly.SLDASM, Metal_Plate.SLDPRT, Upperenclosure_Asm.SLDASM]
2023-10-05 Update diaphram metal to reduce file size and increase hole size
    [9358T531_304 Stainless Steel Perforated Sheet.SLDPRT, FabricationCube.SLDPRT, Lowerenclosure_Assembly.SLDASM, Metal_Plate.SLDPRT, Upperenclosure_Asm.SLDASM]
2023-10-06 add gas exchanger model
    [Gasexchange_PDMSXA2500.SLDPRT, Lowerenclosure_Assembly.SLDASM, Upperenclosure_Asm.SLDASM]
2023-10-18 Models for table components, pump, flow sensor, screen, peg board
    [1928A26_pegboard_al.SLDPRT, Diaphragmtube_discharge.SLDPRT, Levitronics_pumpwithpumphead.SLDASM, Lowerenclosure_Assembly.SLDASM, PS-4060-07 Rev01 Spec for Pump Driver IPD-30-8 Simplified Solid.SLDPRT, PS-4078-00 Rev00 Pump Head DCP-30-2 Simplified Solid.SLDPRT, PS-4536-01 Rev05 Flowsensor LFS-03SU-Z Simplified Solid.SLDPRT, Upperenclosure_Asm.SLDASM]
2023-10-20 Add pump holder and gas exchanger holder
    [18535A102_Zinc-Plated Steel Pegboard Hook.SLDPRT, Gasexchange_high.SLDPRT, Gasexchange_low.SLDPRT, Gasexchange_mid.SLDPRT, Levitronics_pumpwithpumphead.SLDASM, Lowerenclosure_Assembly.SLDASM, PS-4536-01 Rev05 Flowsensor LFS-03SU-Z Simplified Solid.SLDPRT, Pump_platform.SLDPRT]
2023-10-20 Clamp on flow sensor and holder work, radii and thru holes for gas ex
    [Clamponflow_holder.SLDPRT, Gasexchange_PDMSXA2500.SLDPRT, Gasexchange_asm.SLDASM, Gasexchange_high.SLDPRT, Gasexchange_low.SLDPRT, Gasexchange_mid.SLDPRT, Lowerenclosure_Assembly.SLDASM, Pump_platform.SLDPRT]
2023-10-24 Update clamp on pressure holder for second slot
    [Clamponflow_holder.SLDPRT, Lowerenclosure_Assembly.SLDASM, PS-4536-01 Rev05 Flowsensor LFS-03SU-Z Simplified Solid.SLDPRT, Upperenclosure_Asm.SLDASM]
2023-10-24 updates to get Keyence flow sensors working fixes so Levitronix pumps start/stop correctly
    [SystemHardware.py, panel_AI.py, panel_levitronix_pumps.py, pyPuraLevi30.py]
2023-10-24 Clamp on sensor and other minor updates
    [Clamponflow_holder.SLDPRT, Lowerenclosure_Assembly.SLDASM, Upperenclosure_Asm.SLDASM, magnet_based_drain.SLDPRT]
2023-10-25 Update asm to reduce size
    [Diaphragm_asm2.SLDASM, FabricationCube.SLDPRT, Lowerenclosure_Assembly.SLDASM, Metal_Plate.SLDPRT, Upperenclosure_Asm.SLDASM]
2023-10-26 Spin asm to match irl
    [FabricationCube.SLDPRT, Lowerenclosure_Assembly.SLDASM, Upperenclosure_Asm.SLDASM]
2023-10-30 Switch trap door trim, add hd filter, switch to double peg board hook
    [Bloodcollection_exittube.SLDPRT, Gasexchange_asm.SLDASM, Gasexchange_low.SLDPRT, Gasexchange_mid.SLDPRT, Lowerenclosure_Assembly.SLDASM, Upperenclosure_Asm.SLDASM]
2023-11-02 HD filter holder, smaller gasket trim, gas exchanger update to delete lower
    [18535A132_Pegboard Holder for 1-1 2 Diameter Item.SLDPRT, 44555K154_Brass Low-Pressure Barbed Tube Fitting.SLDPRT, Enclosure_trapdoor.SLDPRT, Gasexchange_asm.SLDASM, Gasexchange_mid.SLDPRT, HDfilter_dialysis.SLDPRT, HDfilter_holder.SLDPRT, HDfilter_holder_U.SLDPRT]
2023-11-06 Update peg board for irl depth and peg board holders
    [1928A26_pegboard_al.SLDPRT, FabricationCube.SLDPRT, Lowerenclosure_Assembly.SLDASM, Metal_Plate.SLDPRT, Upperenclosure_Asm.SLDASM, pegboard_stand.SLDPRT]
2023-11-09 Update lock to use a shorter screw, pump platform update to extruded slots, peg board stand mods
    [Enclosure_trapdoor_lockasm.SLDASM, Enclosure_trapdoor_lockout.SLDPRT, Pump_platform.SLDPRT, Upperenclosure_Asm.SLDASM, pegboard_stand.SLDPRT]
2023-11-09 Create loop for gas exchanger, hd filter thickness options
    [Clamponflow_holder.SLDPRT, Gasexchange_loop.SLDPRT, HDfilter_holder_U.SLDPRT, pegboard_stand.SLDPRT, pegboard_stand_top.SLDPRT]
2023-11-13 Update gas ex in tableside asm
    [Enclosure_trapdoor_lockasm.SLDASM, Lowerenclosure_Assembly.SLDASM, Upperenclosure_Asm.SLDASM]
2023-11-15 update to valid range handling to reduce memory leaks
    [plotting.py]
2023-12-07 add pressure sensor datasheets
2023-12-11 edits with flow control and pressure sensor integration
2023-12-12 Update trap door hinge holes from 10-32 to 8-32 like irl
    [Enclosure_trapdoor.SLDPRT, Upperenclosure_Asm.SLDASM, Upperenclosure_sidewalls.SLDPRT, Upperenclosure_topwall.SLDPRT]
2023-12-15 Update diaphragm model with new tubing, cots fitting from tubing to 1/4in tubing, and make custom fittings on front and back of diaph tubing
    [2633T11_HIGH-TEMPERATURE SILICONE RUBBER SHEET.SLDPRT, 2974K271_Plastic Barbed Tube Fitting for Air and Water.SLDPRT, 2974K271_Plastic Barbed Tube Fitting for Air and Water_mod.SLDPRT, 74965K67_tubing.SLDPRT, 9322T242_Easy-to-Form 304 Stainless Steel Wire Cloth.SLDPRT, DiaphTubingasm.SLDASM, Diaphragm_asm2.SLDASM, Endcap_diaphragmtubing.SLDPRT]
2023-12-15 update baud rate for CITSens glucose sensor
2024-01-05 catch NoSamplesAvailableError for NIDAQ override get samples to acquire a quickly as possible instead of using read period
2024-01-08 update timeout of NIDAQ acq to be based on samples being read instead of independent timeout value
2024-01-08 BUGFIX: fix parsing for citsens glucoe sensor plot more data so glucose sensor shows results add new API to panel_AI to update frame_ms
    [panel_AI.py, plotting.py, pyCITSens.py]
2024-01-08 BUGFIX: fix display of CITsens
    [hardware.ini, pyCITSens.py]
2024-01-12 Diaphragm acrylic base and wire asm
    [1023N331_Straight-Flow Rectangular Manifold.SLDPRT, 4452K142_316 Stainless Steel Threaded Pipe Fitting.SLDPRT, 47065T697_T-Slotted Framing.SLDPRT, 47205K37_onoffvalve.SLDPRT, 53515K51_316 Stainless Steel Push-on Hose Fitting for Air and Water.SLDPRT, 74965K67_tubing.SLDPRT, Acrylicbase.SLDPRT, DiaphTubingasm.SLDASM]
2024-01-16 Clamp on pressure sensor table top asm, diaphragm in unit clip
    [97042A268_18-8 Stainless Steel Threaded on One End Stud.SLDPRT, Clampon_backbracket.SLDPRT, Clampon_base.SLDPRT, Clampon_frontbracket.SLDPRT, Diaphragm_asm2.SLDASM, Endcap_bracket.SLDPRT]
2024-02-27 fixed start/stop buttons and confirmed it worked with actual pumps
    [panel_DC.py]
2024-02-27 scaled dialysis blood pump to actual flow and made input range 0-200, double checked with machinery
2024-02-28 fixed issue/error with start/stop buttons for dropdown drug infusions
    [panel_syringe.py]
2024-02-28 disabled bolus button and target volume during basal
2024-02-28 added panel for solumed - this now uses the old glucagon syringe pump, changed old glucagon syringe to 10mL (not coded)
2024-02-28 Expand dropdown for pumps on initialization
2024-02-28 A few aesthetic changes and color code for action/auto clicked/unclicked buttons so easier to visualize what settings are on
2024-03-07 changed auto gas so it doesn't read "zero" as past flow on flow_resume - which was just keeping the flow zero forever
    [pyGB100.py]
2024-03-08 check for bad timestamp and correct. Force proper timestamp format on write.
    [Strategy_ReadWrite.py]
2024-04-09 when checking for dummy start time (1970-01-01) use startswith instead of full string compare to avoid needing to compare decimal places which seems to change occasionally
    [Strategy_ReadWrite.py]
2024-04-10 BUGFIX: start_ts also needs to be divided by 1000 to generate correct timestamp
    [Strategy_ReadWrite.py]
2024-04-10 BUGFIX: update to handle situation with multiple samples per timestamp
    [Strategy_ReadWrite.py]
2024-04-25 detect if no device found minor code cleanups
2024-04-26 add additional error checking improve handling of buffers to avoid lost buffers fix bug in setting rate (was setting period, needed to specify samples/s)
    [pyAI_MCC.py]
2024-04-26 when starting AI, only issue stop if already started
    [pyAI.py, pyGeneric.py]
2024-04-26 add error handling to catch invalid fid on close. Caused by calculated sensors using strategy outputs that were not created
    [Strategy_ReadWrite.py, pyAI_MCC.py]
2024-05-01 basic code to control 3 DAC channels over UART, not complete
2024-05-02 working code, remove timer and update on flag when changed. Assume mostly static changes
2024-05-09 add board for Nucleo to ADC
    [CONBNC002.PcbLib, CONBNC002.SchLib, SSQ-106-02-T-S-RA.PcbLib, SSQ-106-02-T-S-RA.SchLib, mcc_dac_amp.PcbDoc, mcc_dac_amp.PrjPcb, mcc_dac_amp.SchDoc]
2024-05-10 Based on conversation with Hannah Stepp, make voltage is 1.5V so no need for amps.
    [mcc_dac_amp.PcbDoc, mcc_dac_amp.PrjPcb, mcc_dac_amp.SchDoc]
2024-05-10 create board and enclosure for Nucleo DAC
    [DialysisDACEnclosure.SLDASM, DialysisDACEnclosure.SLDPRT, DialysisDACEnclosure_RearPanel.SLDPRT, LINX_CONBNC002_CONBNC002-1.SLDPRT, LINX_CONBNC002_CONBNC002.x_t, LINX_CONBNC002_CONBNC002_1.x_t, MODULE_NUCLEO-F303K8_NUCLEO-F303K8-3.SLDPRT, MODULE_NUCLEO-F303K8_NUCLEO-F303K8-4.SLDPRT]
2024-05-28 update silkscreen for OshPark fab
    [mcc_dac_amp.PcbDoc]
2024-05-29 fix legend code to allow selection of readers
    [panel_plotting.py]
2024-06-07 fix bug in name of Solumed sensor. Add better error checking and error messages
    [PerfusionSystem.py, panel_syringe.py, panel_syringes_all.py]
2024-06-07 update gitignore for STM32IDE
2024-07-02 add more code to ensure a proper shutdown of hardware, particularly MCC board. If not shutdown properly, the next time the code is run, the MCC board does not seem to acquire data
2024-07-02 update ini's add back glucose sensor to app_sensors
2024-11-08 comb through and delete folders definitely not used
    [1023N331_Straight-Flow Rectangular Manifold.SLDPRT, 1120A99_Water- and Weather-Resistant Rubber Push-on Seal.SLDPRT, 1586A22_Surface-Mount Hinge with Holes.SLDPRT, 18535A102_Zinc-Plated Steel Pegboard Hook.SLDPRT, 18535A132_Pegboard Holder for 1-1 2 Diameter Item.SLDPRT, 1928A26_pegboard_al.SLDPRT, 2518N131_Twist-Release Paired Magnets.SLDPRT, 2633T11_HIGH-TEMPERATURE SILICONE RUBBER SHEET.SLDPRT]
2024-11-18 remove unsed circuits
    [GUI_Switches.brd, GUI_Switches.sch, MSP430F5529_Relays_PressureSensor.brd, MSP430F5529_Relays_PressureSensor.sch, VEML6040A3OG.PcbLib, VEML6040A3OG.SchLib, color_sensors.SchDoc, reservoir_level_color.PcbDoc]
2024-11-19 Delete System Setup/HOW TO Set Up Circuit for Liver Perfusion.pdf
    will re-add when updated
